davegutz/myStateOfCharge/README.md

# myStateOfCharge

[SOC_Particle - the main application](SOC_Particle/README.md)

- Interface python gui to interpret device Serial i/o is  [TestSOC.py](SOC_Particle/py/TestSOC.py) documented [here](SOC_Particle/doc/TestSOC.md).

[BT-AT - setup Bluetooth to a device](BT-AT/README.md)

[eeprom_test - Test Argon+ use of ERAM](eeprom_test/README.md)

[ScanI2C_Photon - Scan available I2C devices on system](ScanI2C_Photon/README.md)

[SOC_data_collection_test - Test serial connection possibilities](SOC_data_collection_test/README.md)
