davegutz/myStateOfCharge/SOC_Sense/README.md

# State of Charge Monitor sense only

Turned off everything.  Will get build warning about unused 'boot_wait' otherwise clean.   The pro3p2 has bad usb cable causing loss of usb sometimes...   Got T=0.0015 after efforts to turn off all unnecessary calculations.
