davegutz/myStateOfCharge/SOC_Particle/select_all decision table.odt

Certainly! Here's a decision tree representation of the logic in the `Fault::select_all_logic` function:

```Decision Table

Condition | Decision/Action | Outcome
reset_all_faults_ == true | Check sp.ib_select()
sp.ib_select() == 2 | ib_sel_stat_ = 2
sp.ib_select() == -1 | ib_sel_stat_ = -1
sp.ib_select() == 1 | ib_sel_stat_ = 1
Any of the above sp.ib_select() conditions | ib_sel_stat_last_ = ib_sel_stat_ | Print "reset ib flt"
ap.fake_faults == true | Check HDWE_IB_HI_LO
HDWE_IB_HI_LO defined | ib_sel_stat_ = 2
HDWE_IB_HI_LO not defined | ib_sel_stat_ = 1 | latched_fail_ = false
Sen->ShuntAmp->bare_detected() == true and Sen->ShuntNoAmp->bare_detected() == true | ib_sel_stat_ = 0 | latched_fail_ = true
sp.ib_select() > 0 and Sen->ShuntAmp->bare_detected() == false | ib_sel_stat_ = 1 | latched_fail_ = true
ib_sel_stat_last_ == -1 and Sen->ShuntNoAmp->bare_detected() == false and !(sp.mod_ib() && reset_all_faults_) | ib_sel_stat_ = -1 | latched_fail_ = true
sp.ib_select() < 0 and Sen->ShuntNoAmp->bare_detected() == false | ib_sel_stat_ = -1 | latched_fail_ = true
sp.ib_select() == 0 (auto) | Check conditions
Sen->ShuntAmp->bare_detected() == true and Sen->ShuntNoAmp->bare_detected() == false | ib_sel_stat_ = -1 | latched_fail_ = true
ib_diff_fa() == true | Check vb_sel_stat_ and wrap_fa()
vb_sel_stat_ == true and wrap_fa() == true | ib_sel_stat_ = -1 | latched_fail_ = true
vb_sel_stat_ == false and cc_diff_fa() == true | ib_sel_stat_ = -1 | latched_fail_ = true
`(sp.ib_select() < 0 && ib_sel_stat_last_ > -1) | | (sp.ib_select() >= 0 && ib_sel_stat_last_ < 1)`
Any other condition | latched_fail_ = false | Print "latchF"
ap.fake_faults == true (handling fake faults) | Check conditions
Sen->ShuntAmp->bare_detected() == true and Sen->ShuntNoAmp->bare_detected() == true | latched_fail_fake_ = true
ib_sel_stat_last_ == -1 and Sen->ShuntNoAmp->bare_detected() == false and sp.mod_ib() == false | latched_fail_fake_ = true
sp.ib_select() < 0 and Sen->ShuntNoAmp->bare_detected() == false | latched_fail_fake_ = true
Sen->ShuntAmp->bare_detected() == true and Sen->ShuntNoAmp->bare_detected() == false | latched_fail_fake_ = true
ib_diff_fa() == true | Check vb_sel_stat_ and wrap_fa()
vb_sel_stat_ == true and wrap_fa() == true | latched_fail_fake_ = true
vb_sel_stat_ == false and cc_diff_fa() == true | latched_fail_fake_ = true
Redundancy loss check | Call faultAssign(red_loss_calc(), RED_LOSS)
ap.fake_faults == true | ib_sel_stat_ = sp.ib_select()
reset_all_faults_ == true (reset vb faults) | vb_sel_stat_last_ = 1 | vb_sel_stat_ = 1
!ap.fake_faults == true | Check conditions
!vb_sel_stat_last_ == true and !sp.mod_vb() == true | vb_sel_stat_ = 0 | latched_fail_ = true
wrap_vb_fa() == true or vb_fa() == true | vb_sel_stat_ = 0 | latched_fail_ = true
ap.fake_faults == true (fake faults) | Check conditions
!vb_sel_stat_last_ == true and !sp.mod_vb() == true | latched_fail_fake_ = true
wrap_vb_fa() == true or vb_fa() == true | latched_fail_fake_ = true
reset_all_faults_ == true (reset tb faults) | tb_sel_stat_last_ = 1 | tb_sel_stat_ = 1
tb_fa() == true | tb_sel_stat_ = 0 | latched_fail_ = true
Any other condition | tb_sel_stat_ = 1
Status changes in ib_sel_stat_, vb_sel_stat_, or tb_sel_stat_ | Print detailed status message
ib_sel_stat_ != ib_sel_stat_last_ | Print "Small reset" | Call cp.cmd_reset()
Update last status | ib_sel_stat_last_ = ib_sel_stat_ | vb_sel_stat_last_ = vb_sel_stat_
| tb_sel_stat_last_ = tb_sel_stat_
Async Rf command execution | Check conditions
`(falw_ == 0 && fltw_ == 0) | | count > 1`
Any other condition | Increment count | Print Rf with count, Print "waiting to reset latched_fail"

### Detailed Graphical Decision Tree Description

#### Root Node

- Condition: reset_all_faults_ == true
  - True: Proceed to check sp.ib_select()
    - Condition: sp.ib_select() == 2
      - True: ib_sel_stat_ = 2 and ib_sel_stat_last_ = ib_sel_stat_
      - False: Proceed to next condition
    - Condition: sp.ib_select() == -1
      - True: ib_sel_stat_ = -1 and ib_sel_stat_last_ = ib_sel_stat_
      - False: Proceed to next condition
    - Condition: sp.ib_select() == 1
      - True: ib_sel_stat_ = 1 and ib_sel_stat_last_ = ib_sel_stat_
      - False: Proceed to next condition
    - Outcome: Print "reset ib flt"
  - False: Proceed to check ap.fake_faults == true

#### Node: ap.fake_faults == true

- True: Check HDWE_IB_HI_LO
  - Condition: HDWE_IB_HI_LO defined
    - True: ib_sel_stat_ = 2
    - False: ib_sel_stat_ = 1
  - Outcome: latched_fail_ = false
- False: Proceed to next condition

#### Node: Sen->ShuntAmp->bare_detected() && Sen->ShuntNoAmp->bare_detected()

- True:
  - Action: ib_sel_stat_ = 0
  - Outcome: latched_fail_ = true
- False: Proceed to next condition

#### Node: sp.ib_select() > 0 && !Sen->ShuntAmp->bare_detected()

- True:
  - Action: ib_sel_stat_ = 1
  - Outcome: latched_fail_ = true
- False: Proceed to next condition

#### Node: ib_sel_stat_last_ == -1 && !Sen->ShuntNoAmp->bare_detected() && !(sp.mod_ib() && reset_all_faults_)

- True:
  - Action: ib_sel_stat_ = -1
  - Outcome: latched_fail_ = true
- False: Proceed to next condition

#### Node: sp.ib_select() < 0 && !Sen->ShuntNoAmp->bare_detected()

- True:
  - Action: ib_sel_stat_ = -1
  - Outcome: latched_fail_ = true
- False: Proceed to next condition

#### Node: sp.ib_select() == 0

- True: Check nested conditions
  - Condition: Sen->ShuntAmp->bare_detected() && !Sen->ShuntNoAmp->bare_detected()
    - True:
      - Action: ib_sel_stat_ = -1
      - Outcome: latched_fail_ = true
    - False: Proceed to next condition
  - Condition: ib_diff_fa()
    - True: Check nested conditions
      - Condition: vb_sel_stat_ && wrap_fa()
        - True:
          - Action: ib_sel_stat_ = -1
          - Outcome: latched_fail_ = true
        - False: Proceed to next condition
      - Condition: cc_diff_fa()
        - True:
          - Action: ib_sel_stat_ = -1
          - Outcome: latched_fail_ = true
        - False: End of nested conditions
  - False: End of nested conditions
- False: Proceed to next condition

#### Node: (sp.ib_select() < 0 && ib_sel_stat_last_ > -1) || (sp.ib_select() >= 0 && ib_sel_stat_last_ < 1)

- True:
  - Outcome: latched_fail_ = true
- False:
  - Outcome: latched_fail_ = false

#### Node: Handling fake faults (if ap.fake_faults == true)

- True: Check conditions
  - Condition: Sen->ShuntAmp->bare_detected() && Sen->ShuntNoAmp->bare_detected()
    - True:
      - Outcome: latched_fail_fake_ = true
    - False: Proceed to next condition
  - Condition: ib_sel_stat_last_ == -1 && !Sen->ShuntNoAmp->bare_detected() && !sp.mod_ib()
    - True:
      - Outcome: latched_fail_fake_ = true
    - False: Proceed to next condition
  - Condition: sp.ib_select() < 0 && !Sen->ShuntNoAmp->bare_detected()
    - True:
      - Outcome: latched_fail_fake_ = true
    - False: Proceed to next condition
  - Condition: Sen->ShuntAmp->bare_detected() && !Sen->ShuntNoAmp->bare_detected()
    - True:
      - Outcome: latched_fail_fake_ = true
    - False: Proceed to next condition
  - Condition: ib_diff_fa()
    - True: Check nested conditions
      - Condition: vb_sel_stat_ && wrap_fa()
        - True:
          - Outcome: latched_fail_fake_ = true
        - False: Proceed to next condition
      - Condition: cc_diff_fa()
        - True:
          - Outcome: latched_fail_fake_ = true
        - False: End of nested conditions
  - False: End of nested conditions
- False: End of fake faults handling

#### Node: Redundancy loss check

- Action: Call faultAssign(red_loss_calc(), RED_LOSS)
- Condition: ap.fake_faults == true
  - True:
    - Action: ib_sel_stat_ = sp.ib_select()
  - False: Proceed to next condition

#### Node: Reset vb faults (if reset_all_faults_ == true)

- True:
  - Action: vb_sel_stat_last_ = 1, vb_sel_stat_ = 1
  - Outcome: Print "reset vb flts"
- False: Proceed to next condition

#### Node: Handling vb failure (if !ap.fake_faults)

- Condition: !vb_sel_stat_last_ && !sp.mod_vb()
  - True:
    - Action: vb_sel_stat_ = 0
    - Outcome: latched_fail_ = true
  - False: Proceed to next condition
- Condition: wrap_vb_fa() || vb_fa()
  - True:
    - Action: vb_sel_stat_ = 0
    - Outcome: latched_fail_ = true
  - False: End of nested conditions

#### Node: Handling vb failure (if ap.fake_faults)

- True: Check conditions
  - Condition: !vb_sel_stat_last_ && !sp.mod_vb()
    - True:
      - Outcome: latched_fail_fake_ = true
    - False: Proceed to next condition
  - Condition: wrap_vb_fa() || vb_fa()
    - True:
      - Outcome: latched_fail_fake_ = true
    - False: End of nested conditions
- False: End of fake faults handling

#### Node: Reset tb faults (if reset_all_faults_ == true)

- True:
  - Action: tb_sel_stat_last_ = 1, tb_sel_stat_ = 1
  - Outcome: Print "reset tb flts"
- False: Proceed to next condition

#### Node: Handling tb failure

- Condition: tb_fa()
  - True:
    - Action: tb_sel_stat_ = 0
    - Outcome: latched_fail_ = true
  - False:
    - Action: tb_sel_stat_ = 1
- Condition: Status changes in ib_sel_stat_, vb_sel_stat_, or tb_sel_stat_
  - True:
    - Outcome: Print detailed status message
  - False: Proceed to next condition
