davegutz/myStateOfCharge/SOC_Photon/dataReduction/figures/ReGaugeVocSoc.pyReGaugeVocSoc.py_2023-03-04T08-31-28.pdf_picture_1-2_of_2.pdf

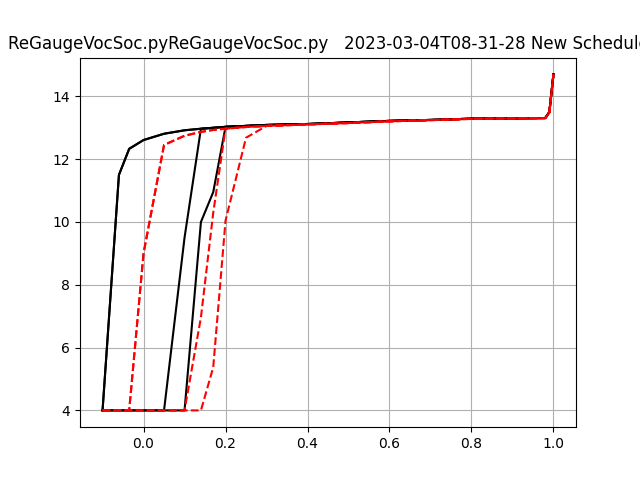
[picture p9: page 1]
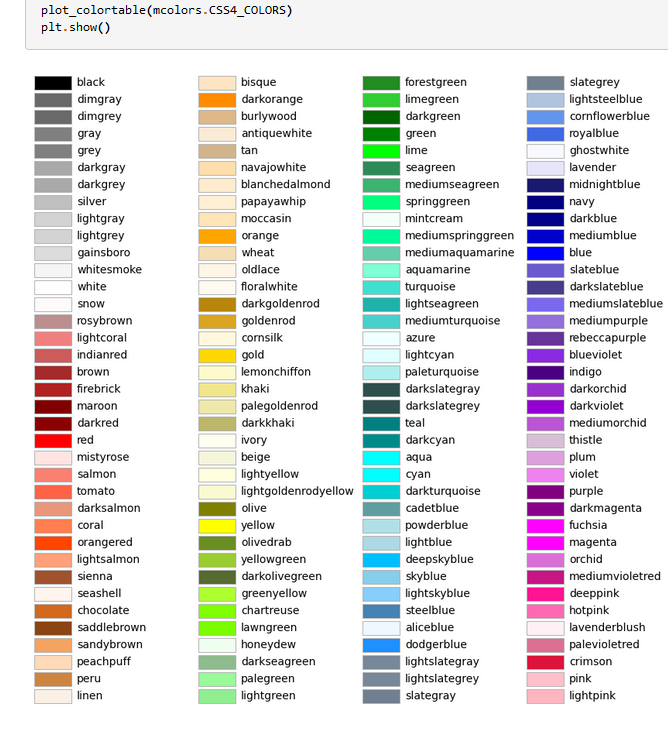
[picture p10: page 2]
