davegutz/myStateOfCharge/SOC_Photon/dataReduction/figures/ReGaugeVocSoc.pyReGaugeVocSoc.py_2023-03-02T19-05-37.pdf_picture_1-2_of_2.pdf

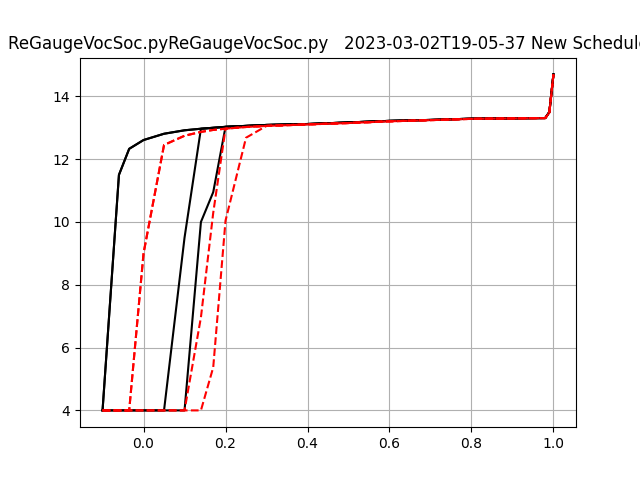
[picture p11: page 1]
