davegutz/myStateOfCharge/SOC_Photon/dataReduction/figures/ReGaugeVocSoc.pyReGaugeVocSoc.py_2023-03-02T18-55-13.pdf_picture_1-2_of_2.pdf

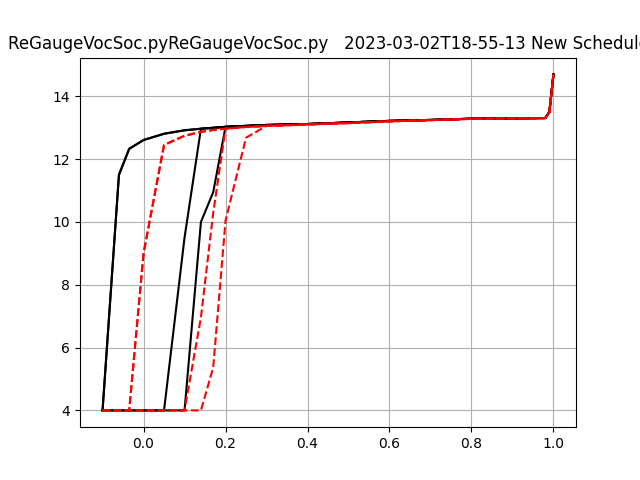
[picture p12: page 1]
