davegutz/myStateOfCharge/SOC_Photon/dataReduction/figures/ReGaugeVocSoc.pyReGaugeVocSoc.py_2023-03-02T16-22-21.pdf_picture_1-2_of_2.pdf

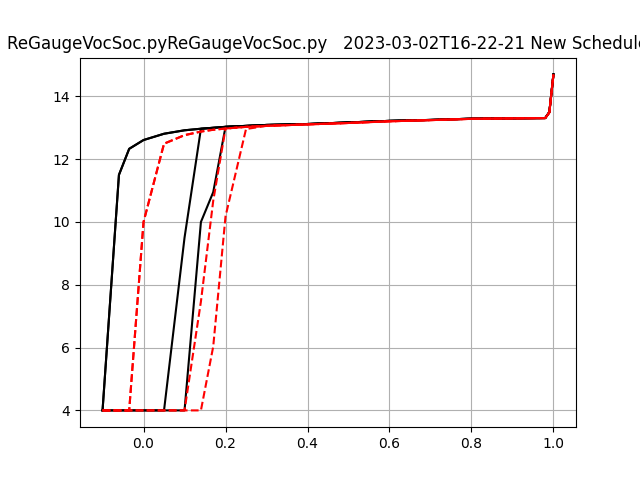
[picture p13: page 1]
