davegutz/myStateOfCharge/SOC_Photon/dataReduction/figures/hist_CompareFault-CompareFault.py_2023-02-12T07-20-07.pdf_picture_19-20_of_20.pdf

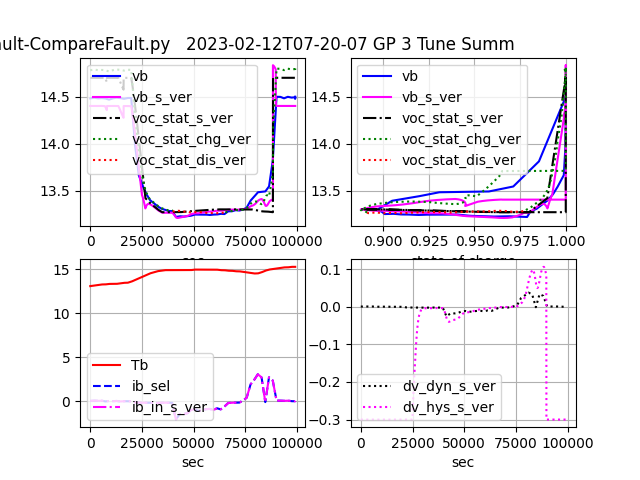
[picture p14: page 1]
