davegutz/myStateOfCharge/SOC_Photon/dataReduction/figures/hist_CompareFault-CompareFault.py_2023-02-12T05-17-59.pdf_picture_19-20_of_20.pdf

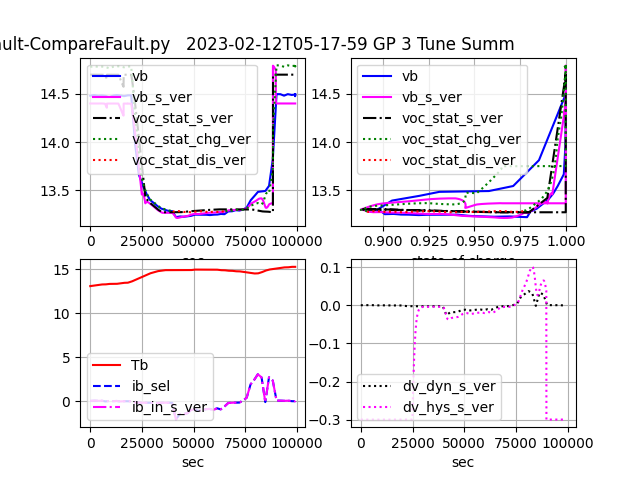
[picture p15: page 1]
