davegutz/myStateOfCharge/SOC_Photon/dataReduction/figures/hist_CompareFault-CompareFault.py_2023-02-11T13-36-58.pdf_picture_19-20_of_20.pdf

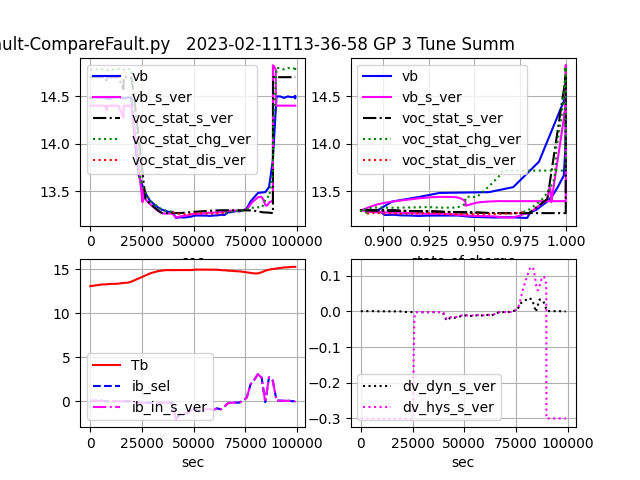
[picture p16: page 1]
