davegutz/myStateOfCharge/SOC_Photon/dataReduction/figures/hist_CompareFault-CompareFault.py_2023-02-09T05-07-31.pdf_picture_19-20_of_20.pdf

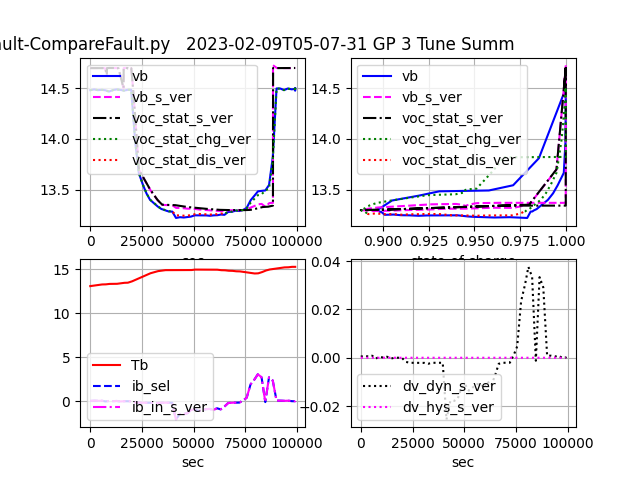
[picture p17: page 1]
