davegutz/myStateOfCharge/SOC_Photon/dataReduction/figures/hist_CompareFault-CompareFault.py_2023-02-08T13-31-16.pdf_picture_19-20_of_20.pdf

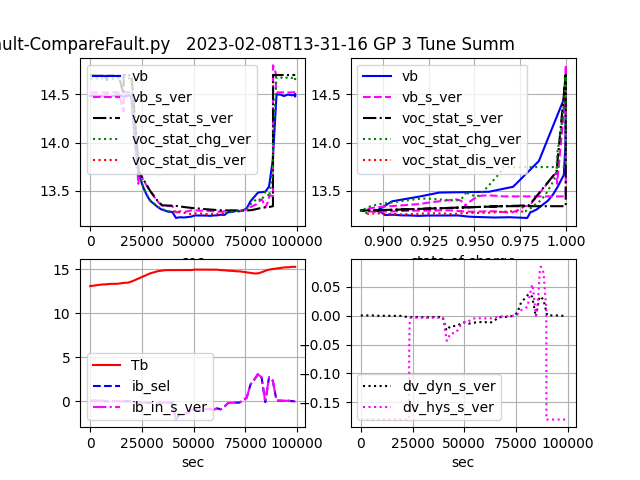
[picture p18: page 1]
