davegutz/myStateOfCharge/SOC_Photon/dataReduction/figures/hist_CompareFault-CompareFault.py_2023-02-07T05-28-49.pdf_picture_19-20_of_20.pdf

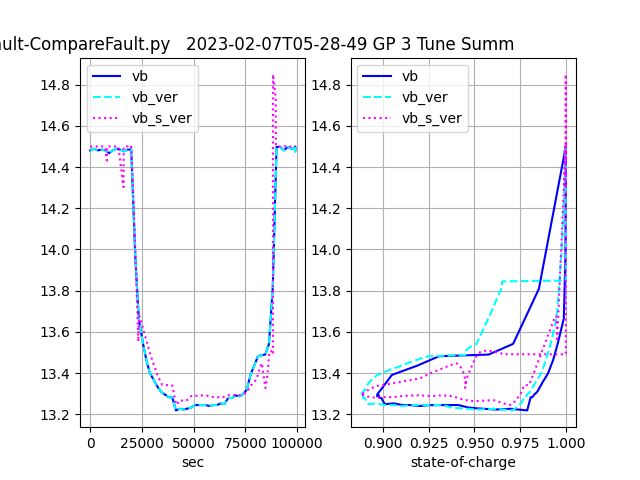
[picture p19: page 1]
