davegutz/myStateOfCharge/SOC_Photon/dataReduction/figures/rapidTweakRegression v20220917a_mon-CompareRun.py_2022-09-27T05-37-11.pdf_picture_19-19_of_19.pdf

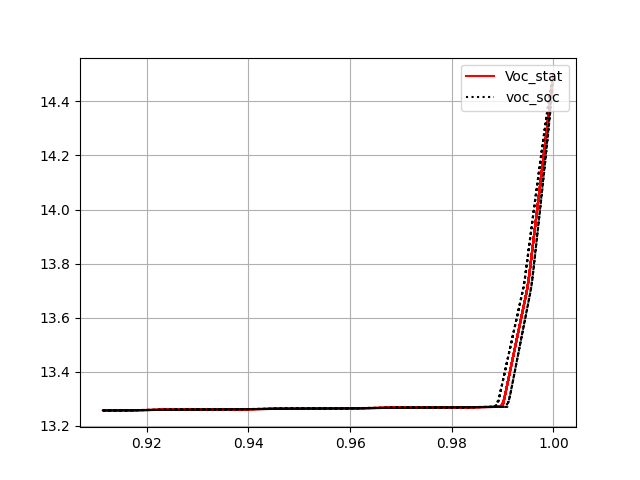
[picture p20: page 1]
