davegutz/myStateOfCharge/SOC_Photon/dataReduction/figures/EKF_Track Dr2000 v20220917_mon-CompareRun.py_2022-09-18T11-55-39.pdf_picture_19-19_of_19.pdf

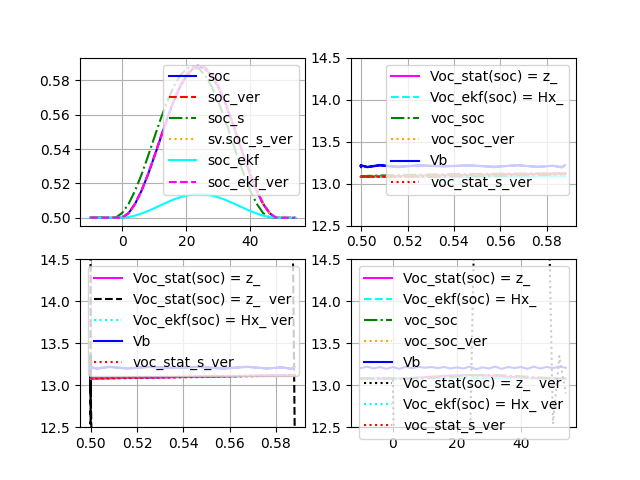
[picture p21: page 1]
