davegutz/myStateOfCharge/SOC_Particle/pyStateOfCharge/figures/faultParade_pro0p_ch_CompareHistSim_2023-12-15T14-03-37.pdf_picture_10-11_of_11.pdf

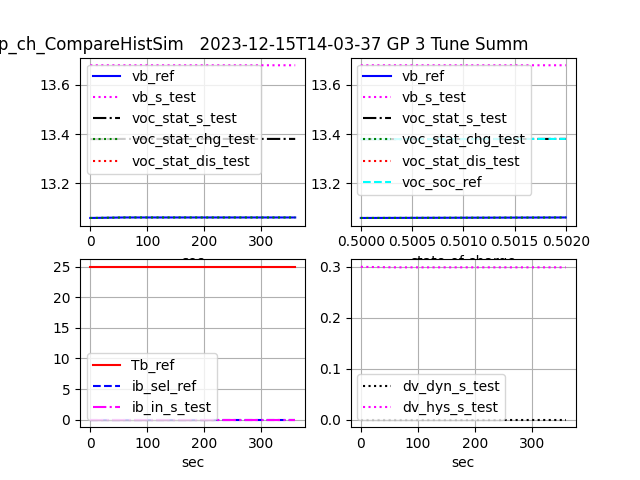
[picture p22: page 1]
