davegutz/myStateOfCharge/SOC_Particle/Battery State/BattleBorn Usable Capacity vs Temperature.png

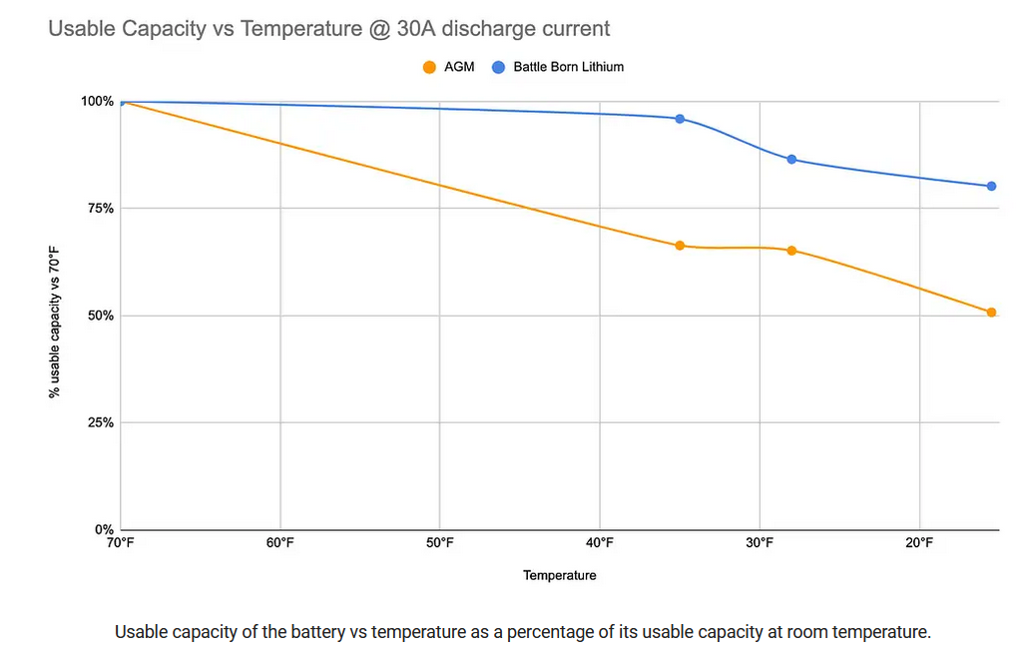
SOC_Particle/Battery State/BattleBorn Usable Capacity vs Temperature.png
