davegutz/myStateOfCharge/SOC_Particle/Battery State/Charge Bookkeeping 20211208.jpg

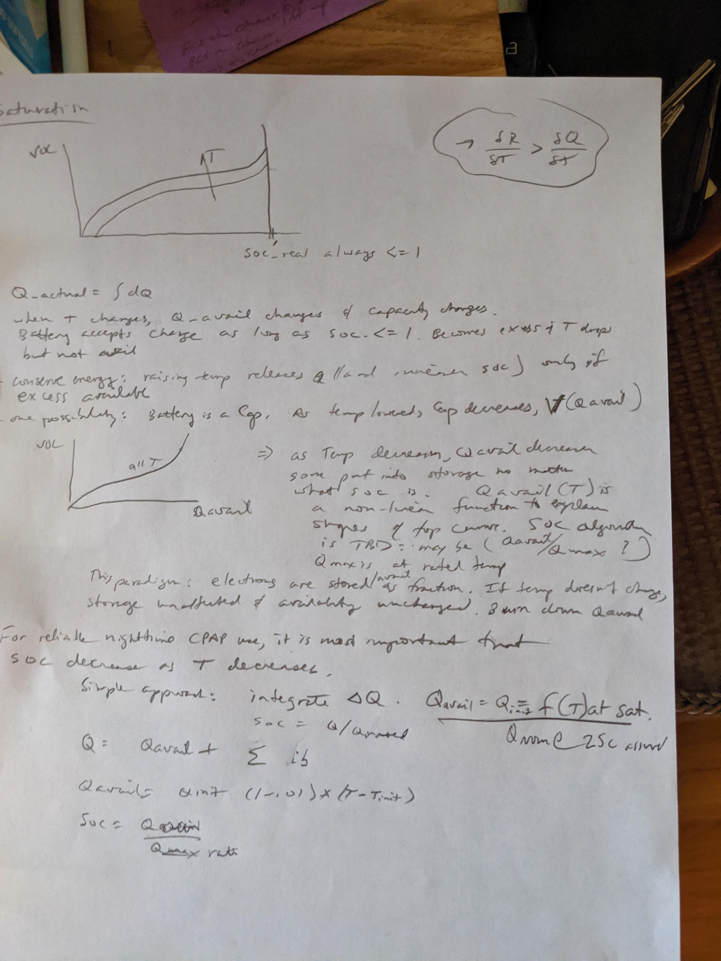
SOC_Particle/Battery State/Charge Bookkeeping 20211208.jpg
