davegutz/myStateOfCharge/SOC_Particle/Battery State/EKF/sandbox/figures/figure_d.png

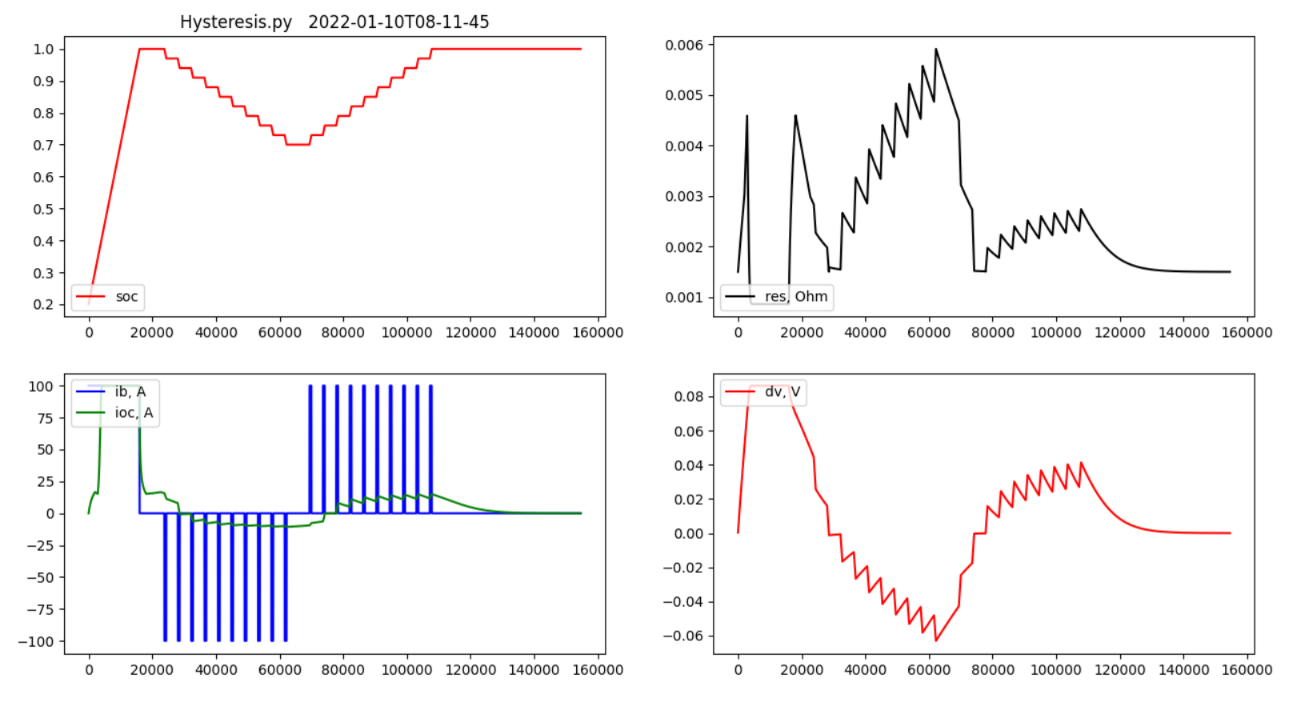
SOC_Particle/Battery State/EKF/sandbox/figures/figure_d.png
