davegutz/myStateOfCharge/SOC_Particle/Battery State/EKF/sandbox/figures/Hysteresis.py_1.png

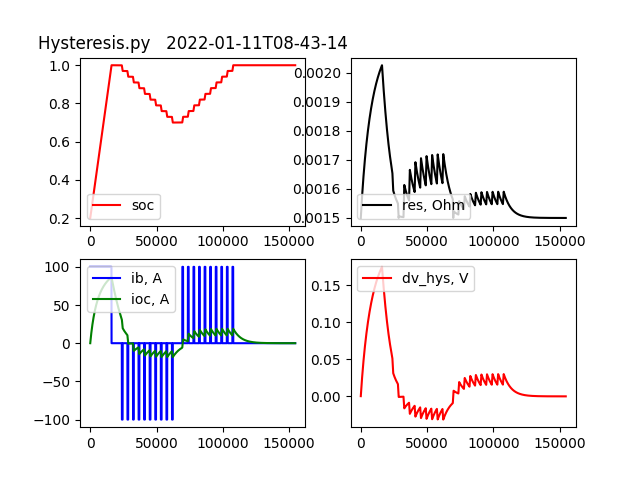
SOC_Particle/Battery State/EKF/sandbox/figures/Hysteresis.py_1.png
