davegutz/myStateOfCharge/SOC_Particle/Battery State/EKF/sandbox/figures/Hysteresis.py_2.png

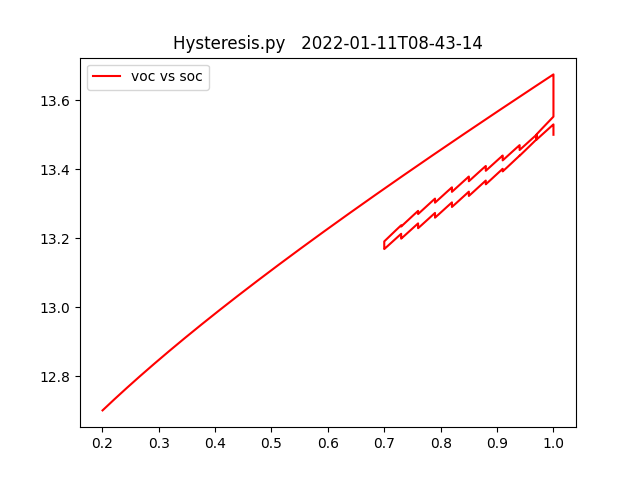
SOC_Particle/Battery State/EKF/sandbox/figures/Hysteresis.py_2.png
