davegutz/myStateOfCharge/SOC_Particle/Battery State/EKF/sandbox/figures/table_d.png

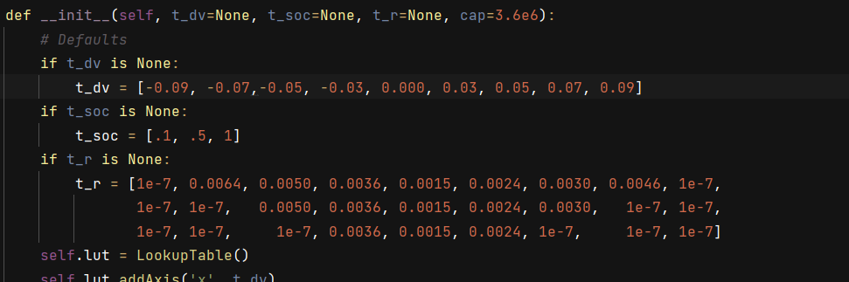
SOC_Particle/Battery State/EKF/sandbox/figures/table_d.png
