davegutz/myStateOfCharge/SOC_Particle/Battery State/Evolution-of-differential-voltage-curves-of-the-fresh-and-aged-LiFePO4-graphite-batteries.png

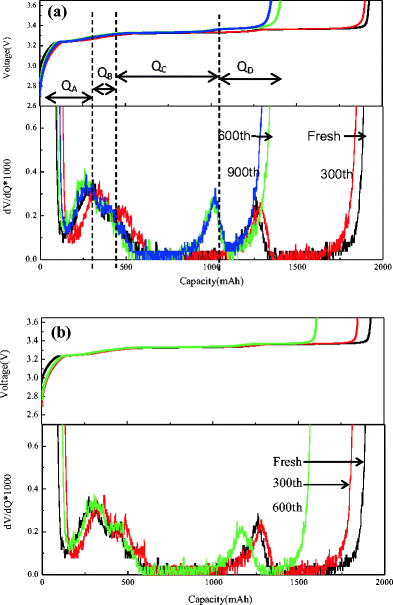
SOC_Particle/Battery State/Evolution-of-differential-voltage-curves-of-the-fresh-and-aged-LiFePO4-graphite-batteries.png
