davegutz/myStateOfCharge/SOC_Particle/Battery State/SMBus Battery Screenshot.png

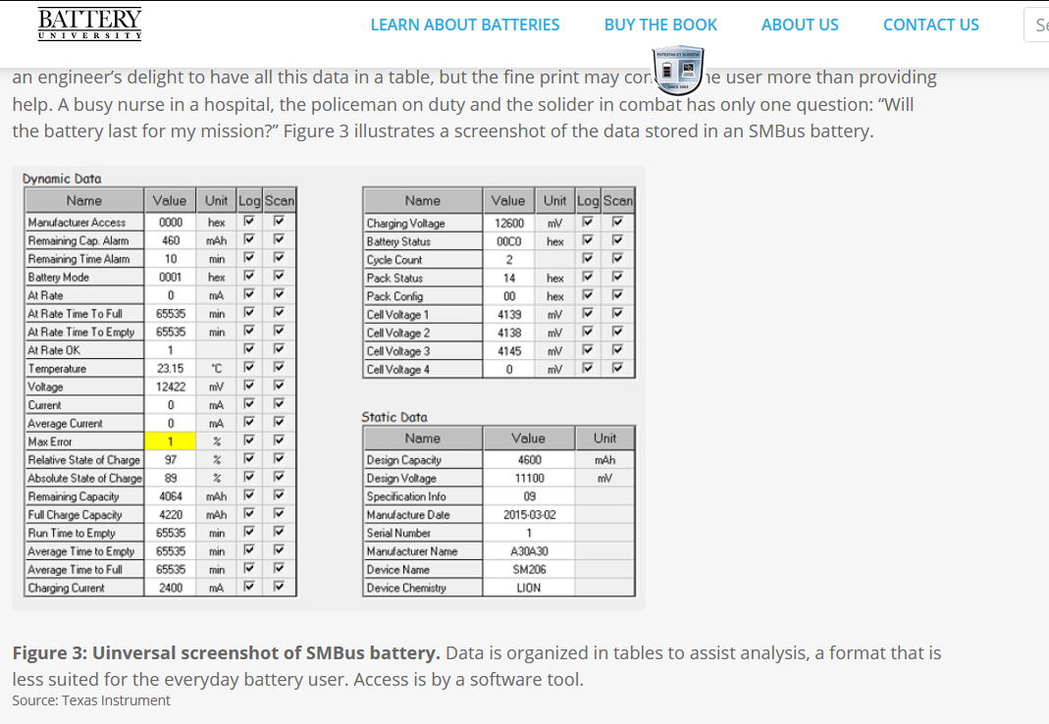
SOC_Particle/Battery State/SMBus Battery Screenshot.png
