davegutz/myStateOfCharge/SOC_Particle/Battery State/The-coulombic-efficiency-of-the-LiFePO4-graphite-batteries-cycled-at-a-25C-and-b-55C.png

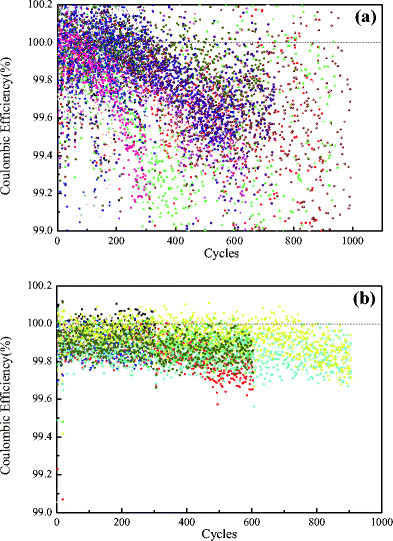
SOC_Particle/Battery State/The-coulombic-efficiency-of-the-LiFePO4-graphite-batteries-cycled-at-a-25C-and-b-55C.png
