davegutz/myStateOfCharge/SOC_Particle/datasheets/pSpice/3_filters_compared.png

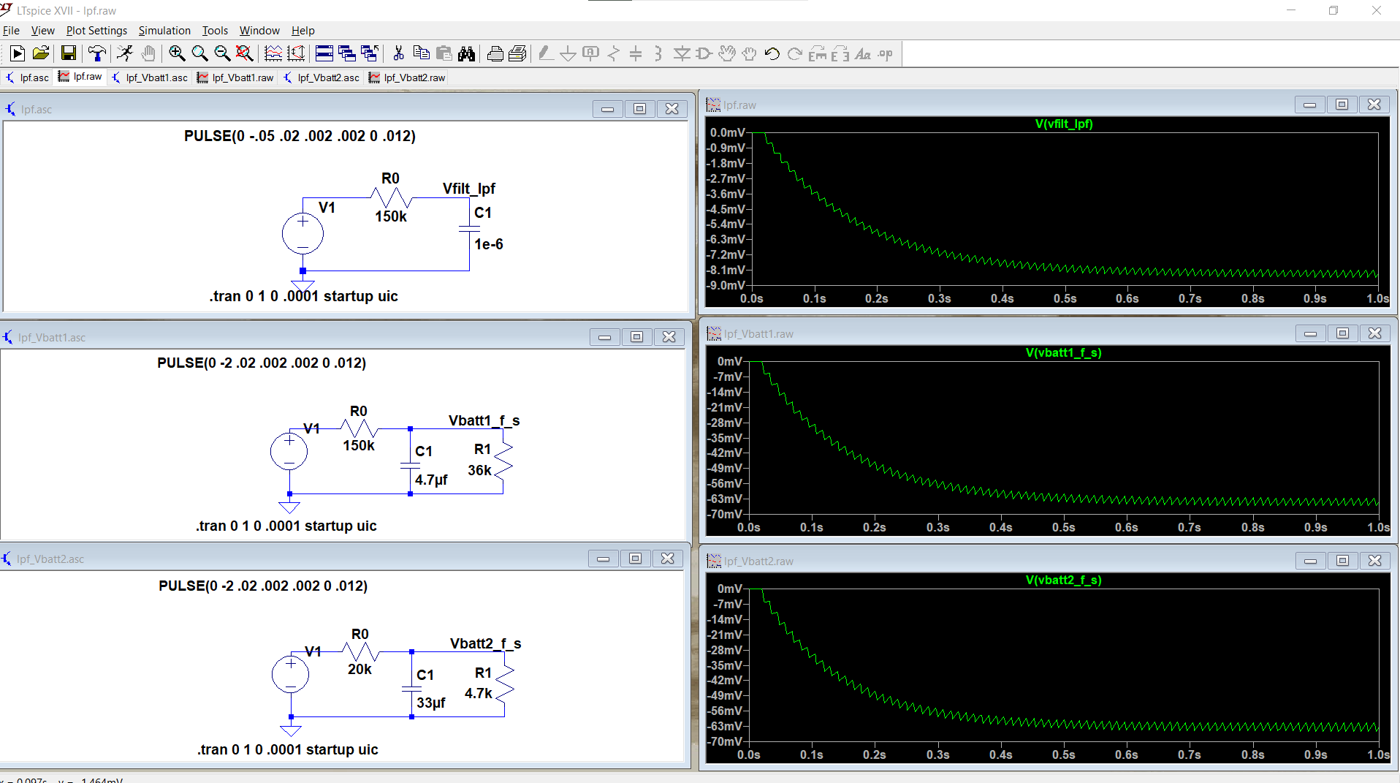
SOC_Particle/datasheets/pSpice/3_filters_compared.png
