davegutz/myStateOfCharge/SOC_Particle/datasheets/Schematics/ArgonBeta.jpg

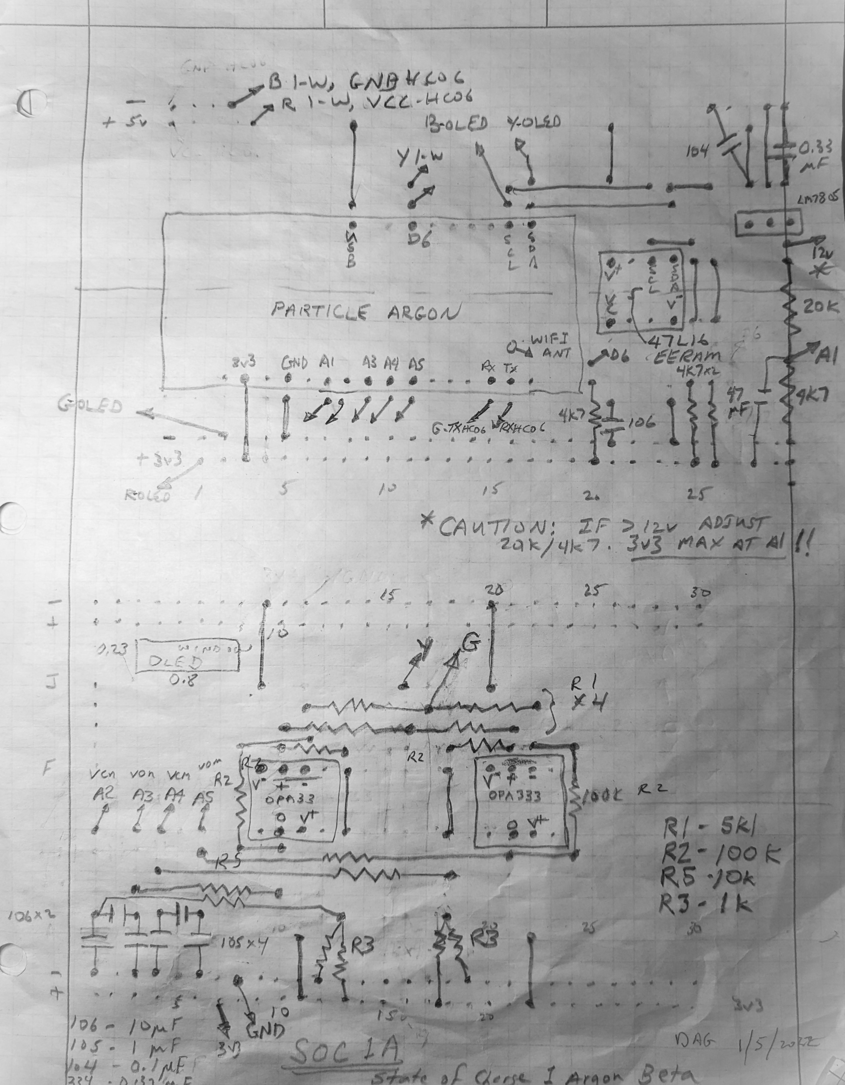
SOC_Particle/datasheets/Schematics/ArgonBeta.jpg
