davegutz/myStateOfCharge/SOC_Particle/datasheets/Schematics/ASD1013_OPA333 Layout.png

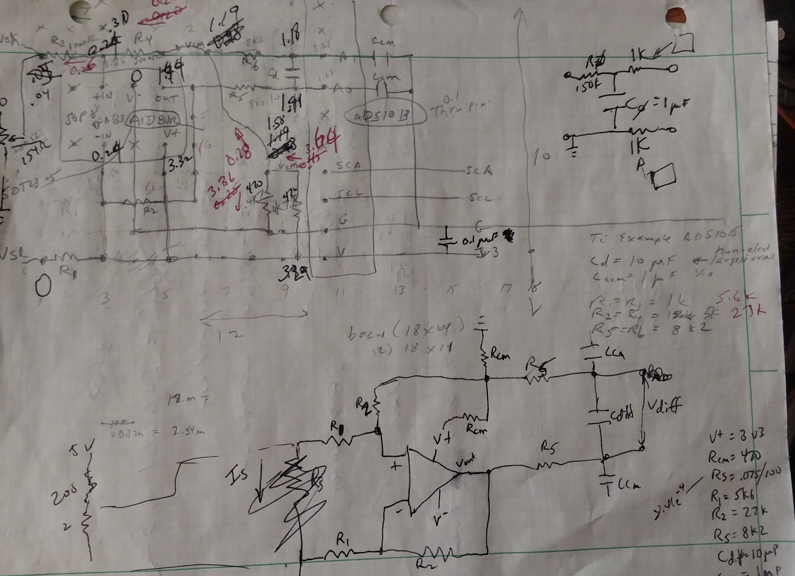
SOC_Particle/datasheets/Schematics/ASD1013_OPA333 Layout.png
