davegutz/myStateOfCharge/SOC_Particle/datasheets/Schematics/ASD1013_OPA333 Prototype Layout.png

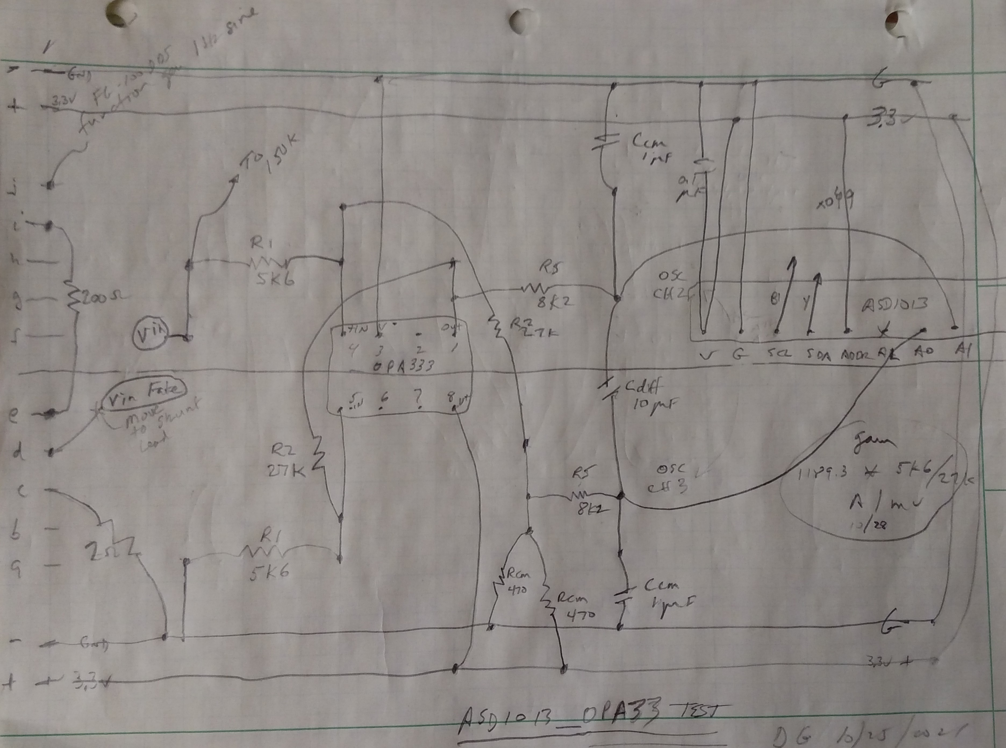
SOC_Particle/datasheets/Schematics/ASD1013_OPA333 Prototype Layout.png
