davegutz/myStateOfCharge/SOC_Particle/datasheets/Schematics/ASD_OPA Design 20211212.jpg

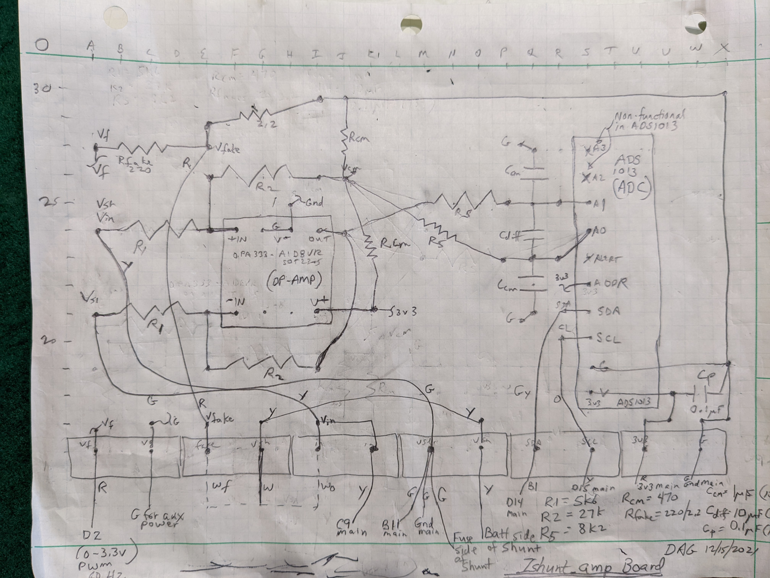
SOC_Particle/datasheets/Schematics/ASD_OPA Design 20211212.jpg
