davegutz/myStateOfCharge/SOC_Particle/datasheets/Schematics/Cutting Strip Board Circuit.jpg

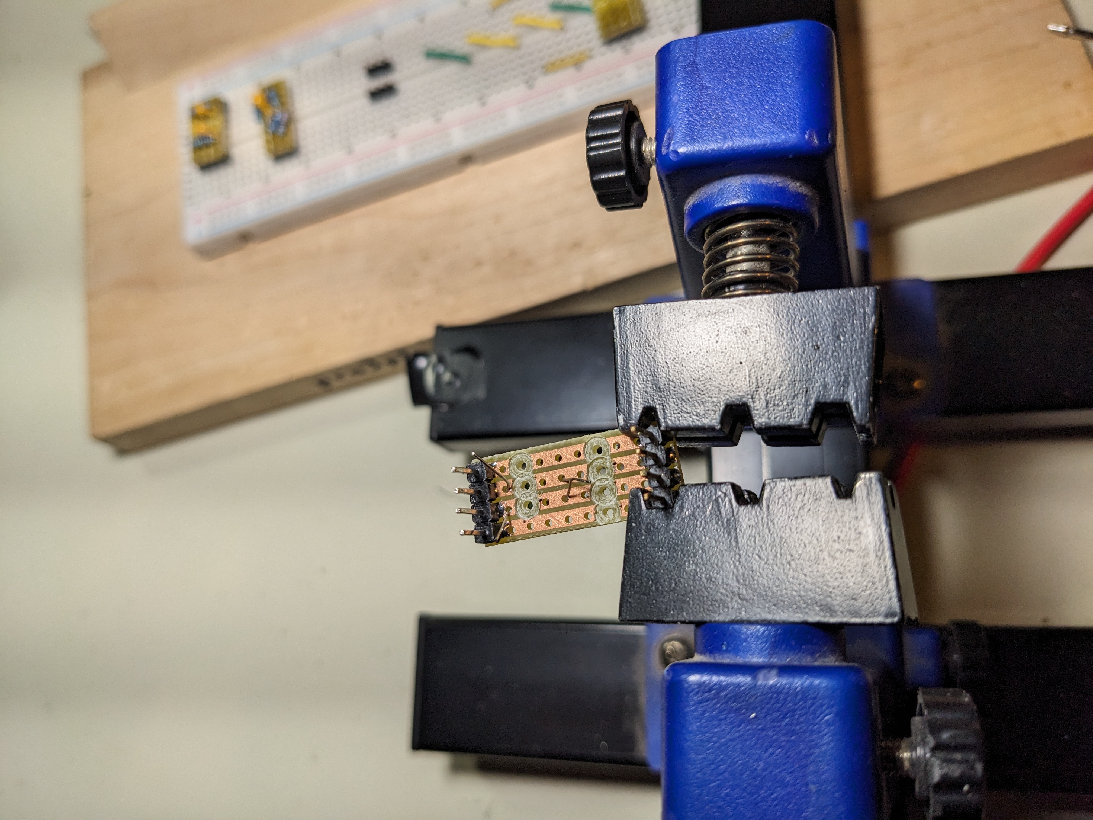
SOC_Particle/datasheets/Schematics/Cutting Strip Board Circuit.jpg
