davegutz/myStateOfCharge/SOC_Particle/datasheets/Schematics/Header Complete.jpg

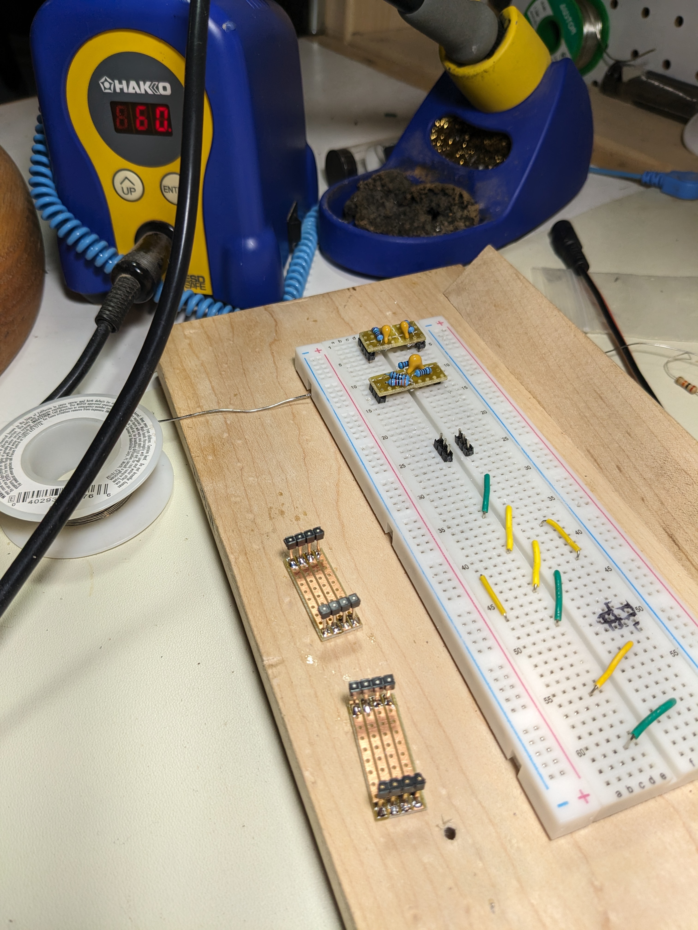
SOC_Particle/datasheets/Schematics/Header Complete.jpg
