davegutz/myStateOfCharge/SOC_Particle/datasheets/Schematics/Header Prep.jpg

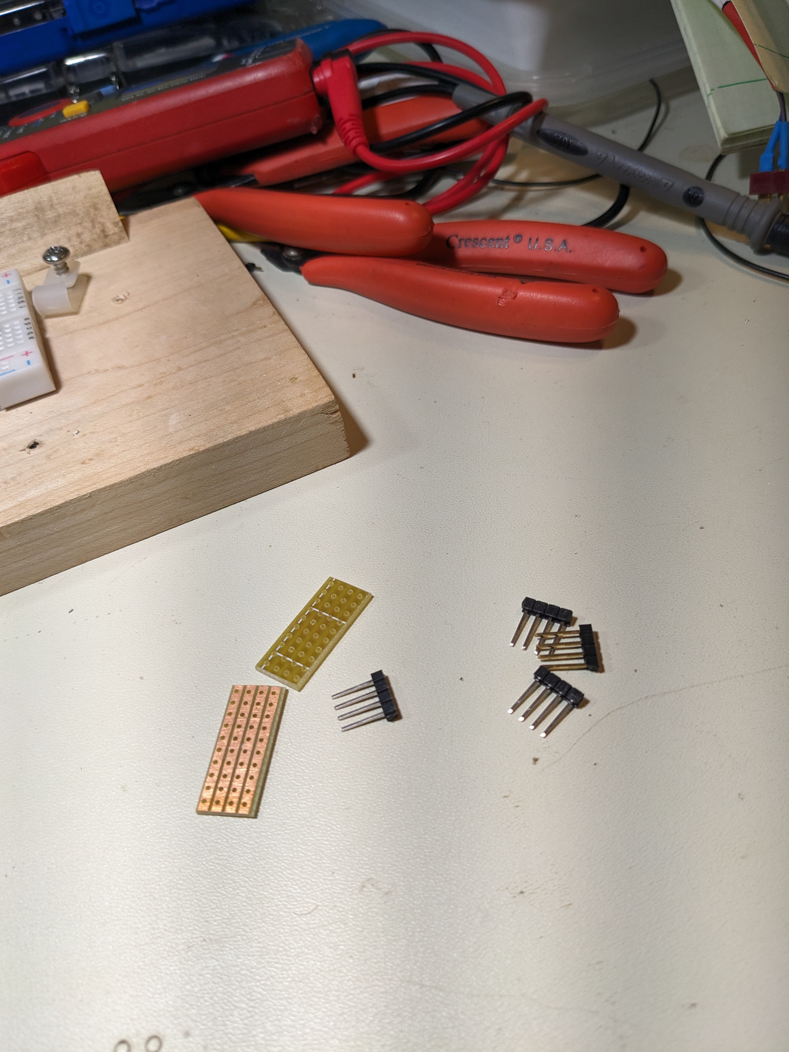
SOC_Particle/datasheets/Schematics/Header Prep.jpg
