davegutz/myStateOfCharge/SOC_Particle/datasheets/Schematics/Header Tack.jpg

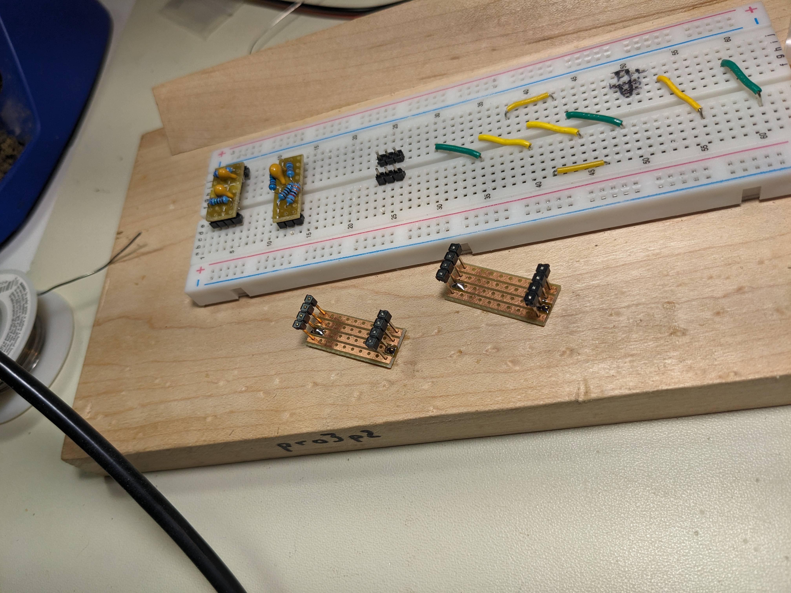
SOC_Particle/datasheets/Schematics/Header Tack.jpg
