davegutz/myStateOfCharge/SOC_Particle/datasheets/Schematics/House Awning.jpg

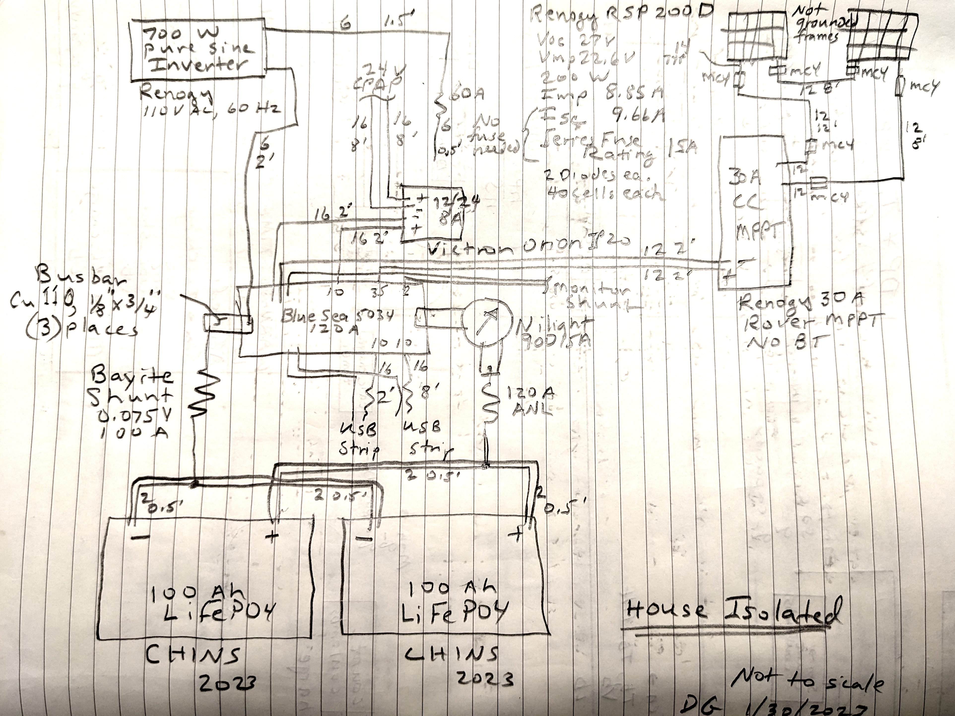
SOC_Particle/datasheets/Schematics/House Awning.jpg
