davegutz/myStateOfCharge/SOC_Particle/datasheets/Schematics/Ib Module.jpg

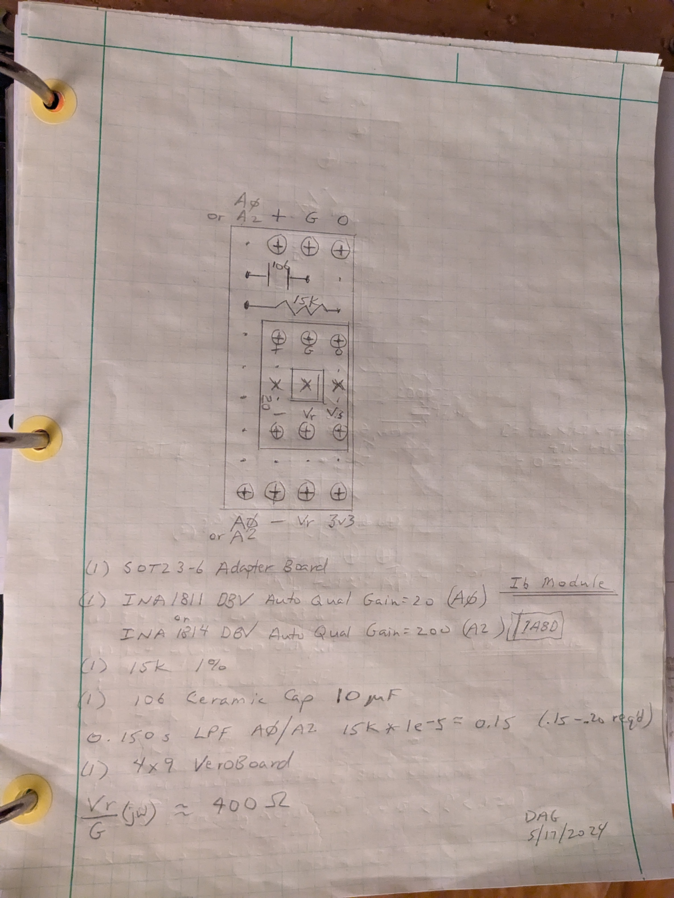
SOC_Particle/datasheets/Schematics/Ib Module.jpg
