davegutz/myStateOfCharge/SOC_Particle/datasheets/Schematics/Ib_Filter_Module.jpg

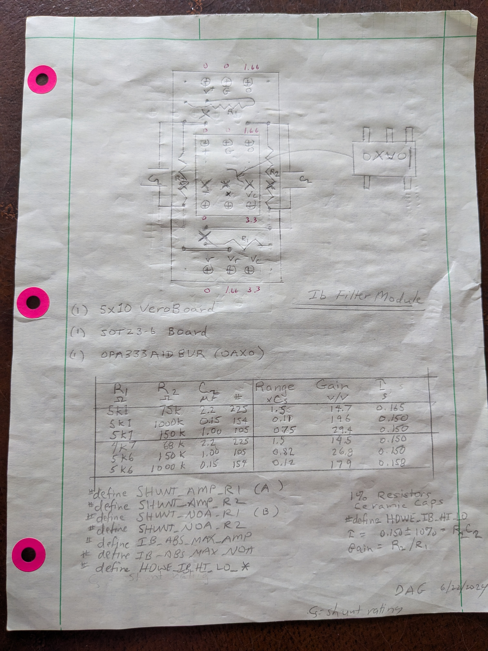
SOC_Particle/datasheets/Schematics/Ib_Filter_Module.jpg
