davegutz/myStateOfCharge/SOC_Particle/datasheets/Schematics/Isolated Garage Solar Power Station.drawio.png

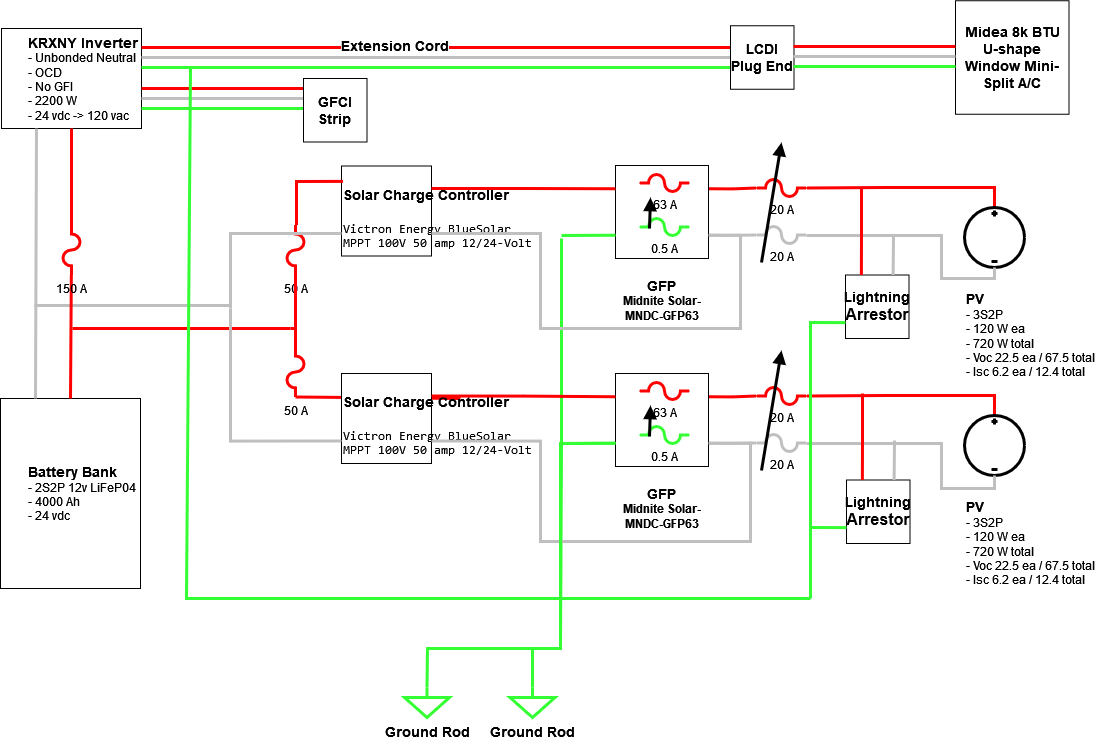
SOC_Particle/datasheets/Schematics/Isolated Garage Solar Power Station.drawio.png
