davegutz/myStateOfCharge/SOC_Particle/datasheets/Schematics/lifepo service life per powertechsystems_eu.png

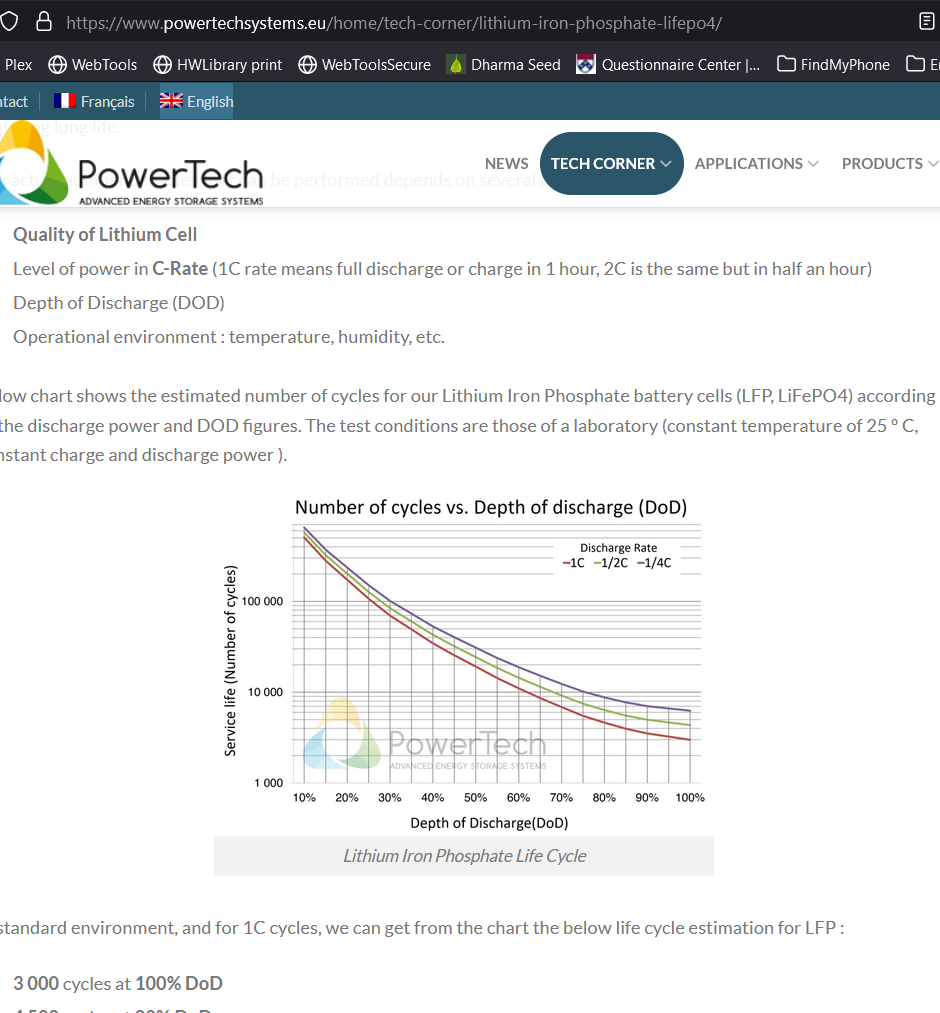
SOC_Particle/datasheets/Schematics/lifepo service life per powertechsystems_eu.png
