davegutz/myStateOfCharge/SOC_Particle/datasheets/Schematics/opa333_asd1013_5betaWith100k.png

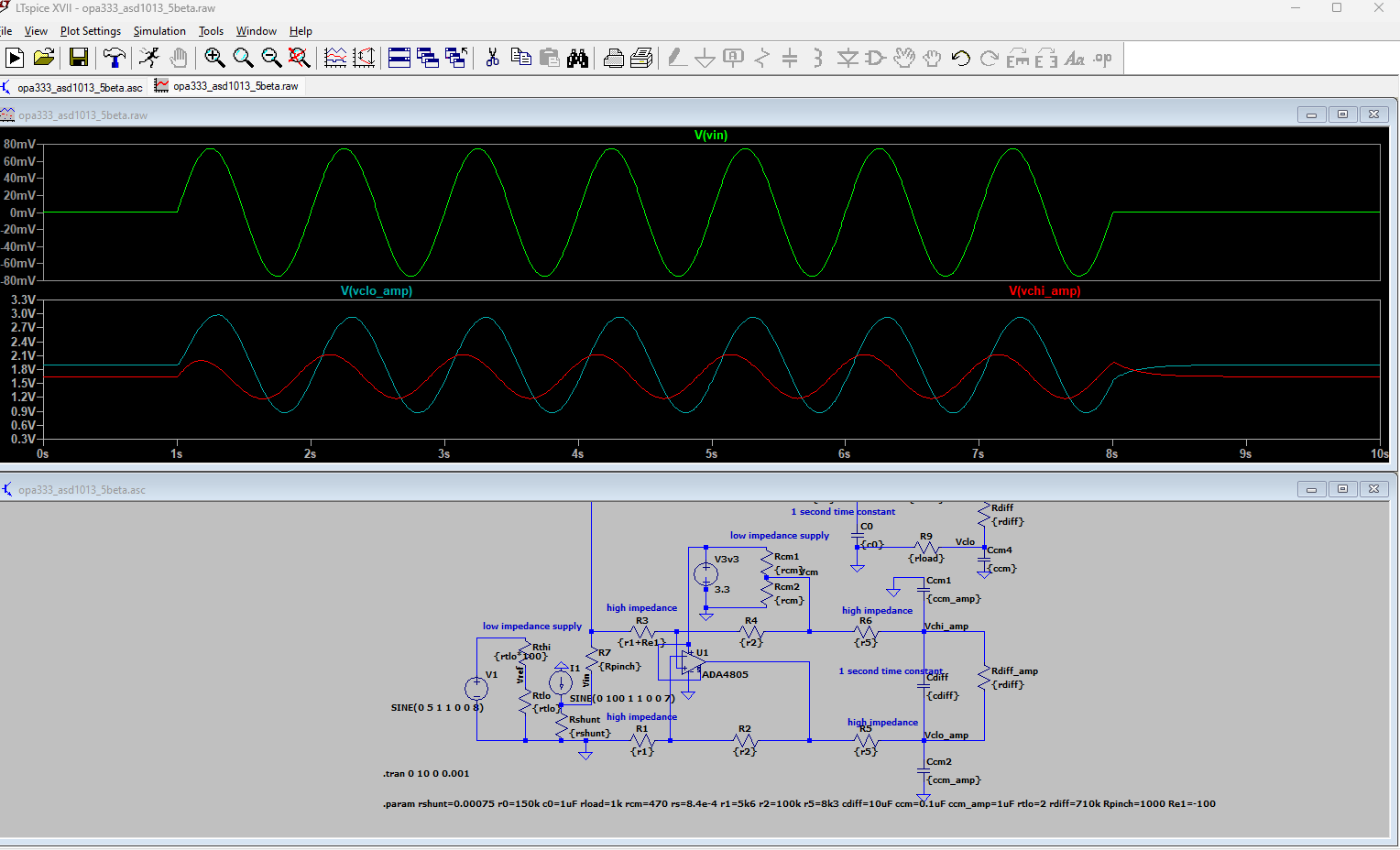
SOC_Particle/datasheets/Schematics/opa333_asd1013_5betaWith100k.png
