davegutz/myStateOfCharge/SOC_Particle/datasheets/Schematics/soc2p2_soc3p2.jpg

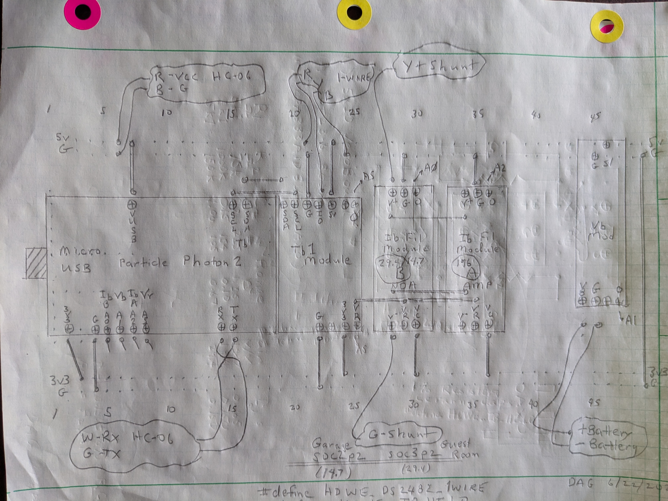
SOC_Particle/datasheets/Schematics/soc2p2_soc3p2.jpg
