davegutz/myStateOfCharge/SOC_Particle/datasheets/Schematics/soc4p2.jpg

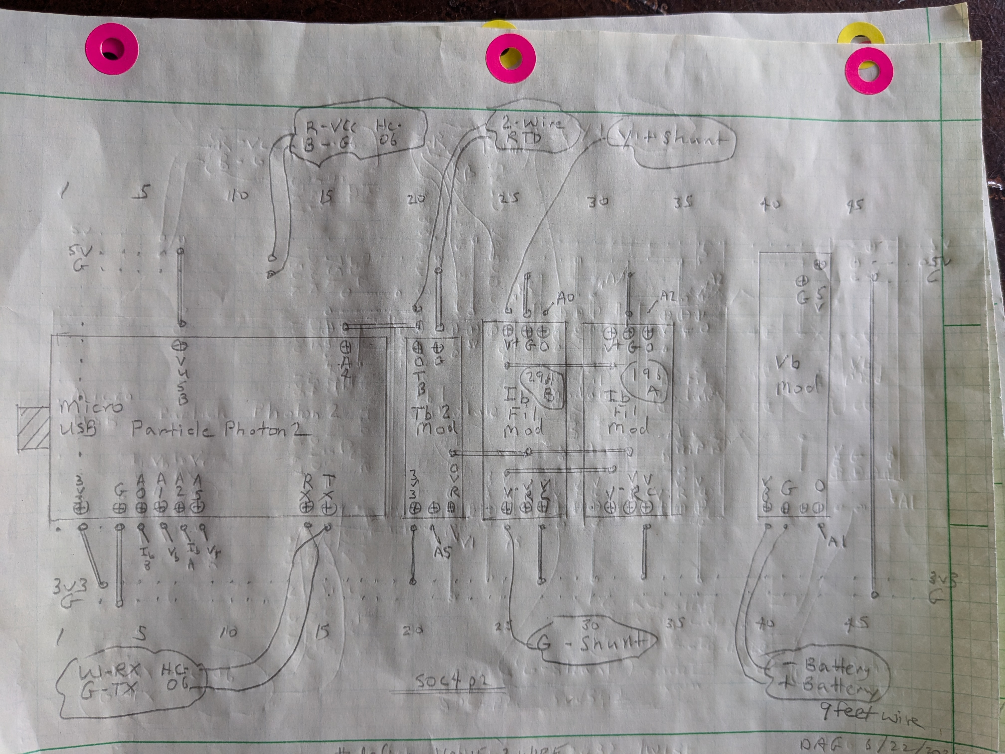
SOC_Particle/datasheets/Schematics/soc4p2.jpg
