davegutz/myStateOfCharge/SOC_Particle/datasheets/Schematics/SoC Layout.png

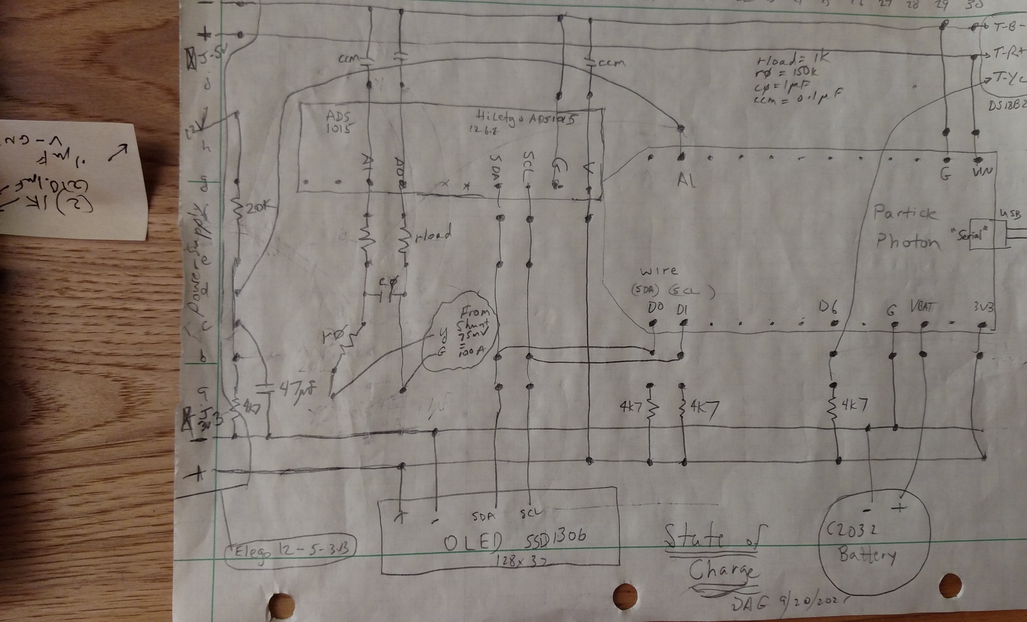
SOC_Particle/datasheets/Schematics/SoC Layout.png
