davegutz/myStateOfCharge/SOC_Particle/datasheets/Schematics/SoC Prototype Layout.png

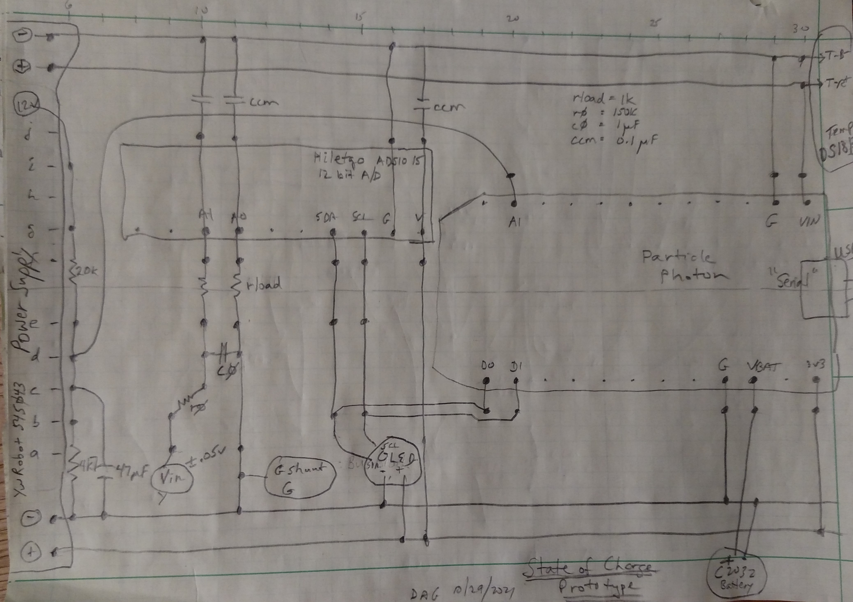
SOC_Particle/datasheets/Schematics/SoC Prototype Layout.png
