davegutz/myStateOfCharge/SOC_Particle/datasheets/Schematics/State of Charge Design.jpg

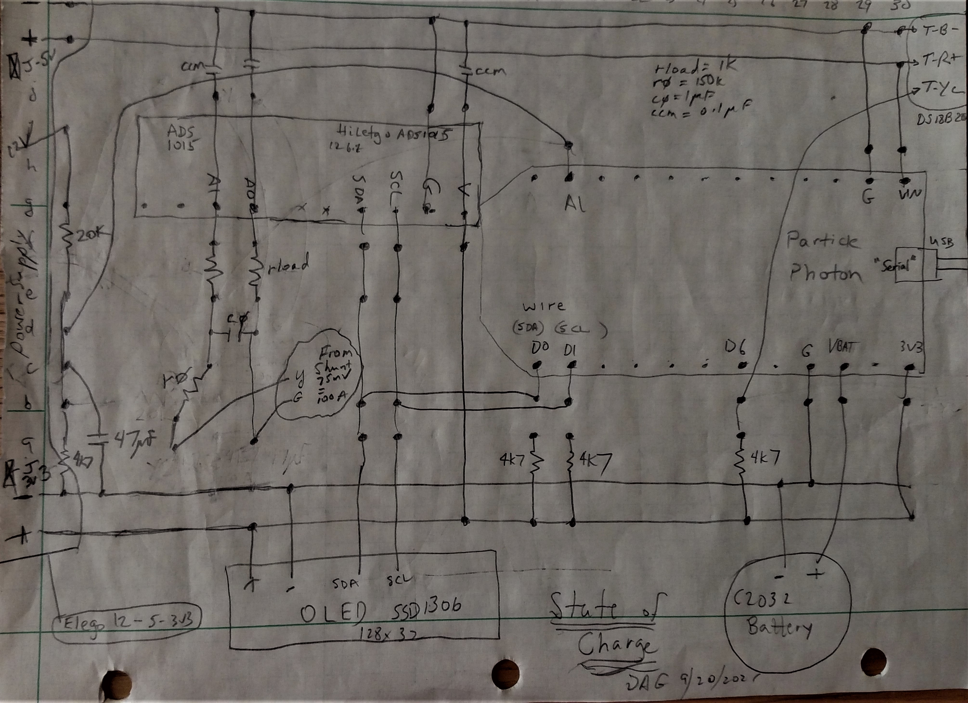
SOC_Particle/datasheets/Schematics/State of Charge Design.jpg
