davegutz/myStateOfCharge/SOC_Particle/datasheets/Schematics/State Of Charge Prototype.jpg

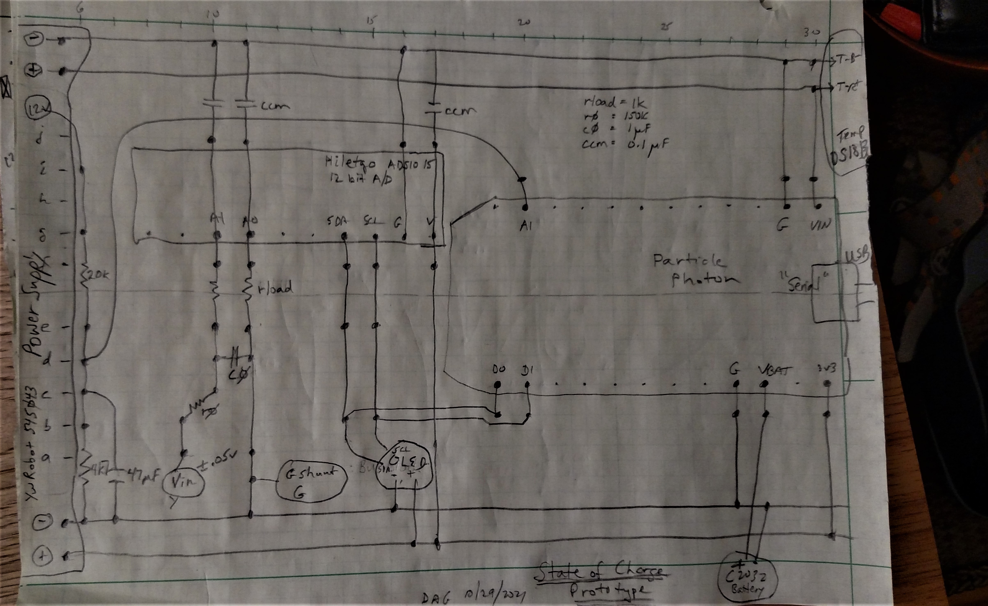
SOC_Particle/datasheets/Schematics/State Of Charge Prototype.jpg
