davegutz/myStateOfCharge/SOC_Particle/datasheets/Schematics/Tb1 Module.jpg

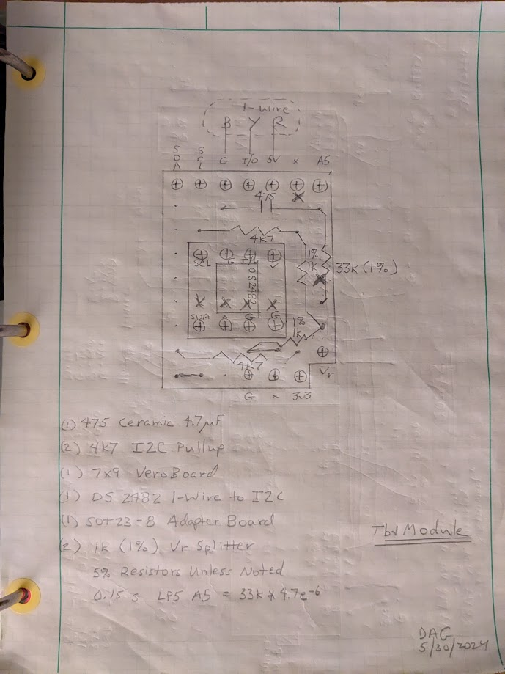
SOC_Particle/datasheets/Schematics/Tb1 Module.jpg
