davegutz/myStateOfCharge/SOC_Particle/datasheets/Schematics/Tb2 Module.jpg

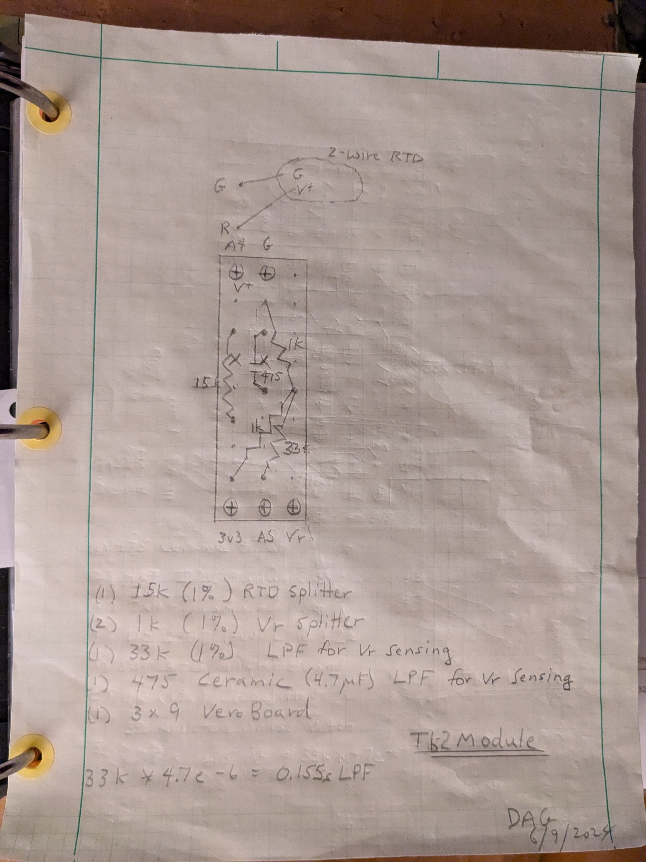
SOC_Particle/datasheets/Schematics/Tb2 Module.jpg
