davegutz/myStateOfCharge/SOC_Particle/datasheets/Schematics/Truck Camper.jpg

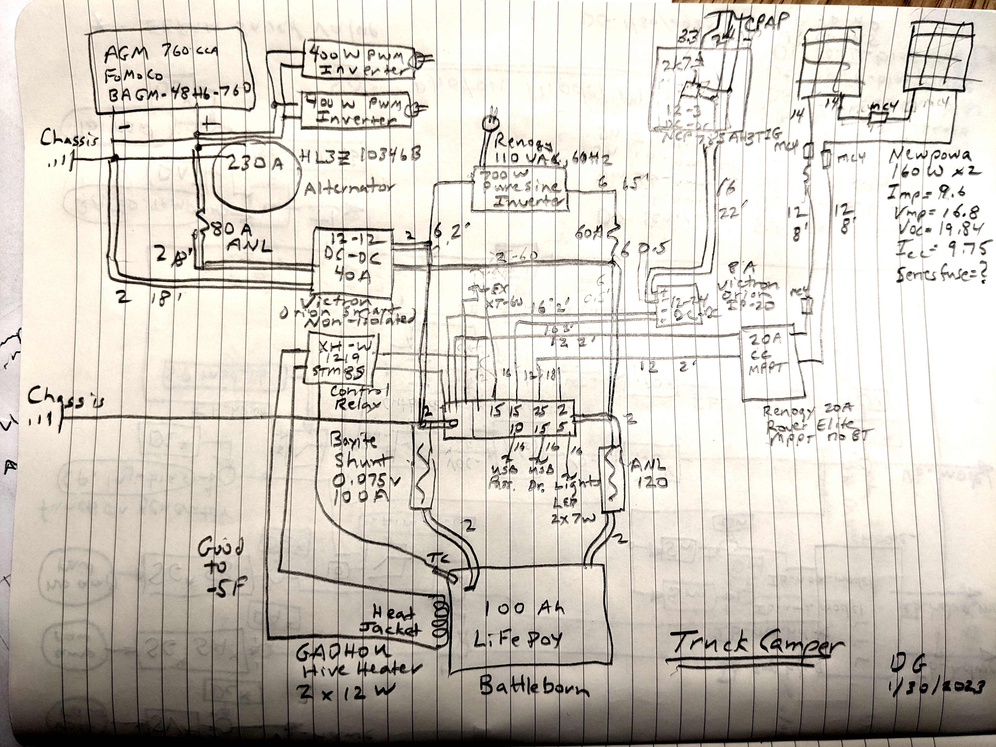
SOC_Particle/datasheets/Schematics/Truck Camper.jpg
