davegutz/myStateOfCharge/SOC_Particle/datasheets/Schematics/Vb Module.jpg

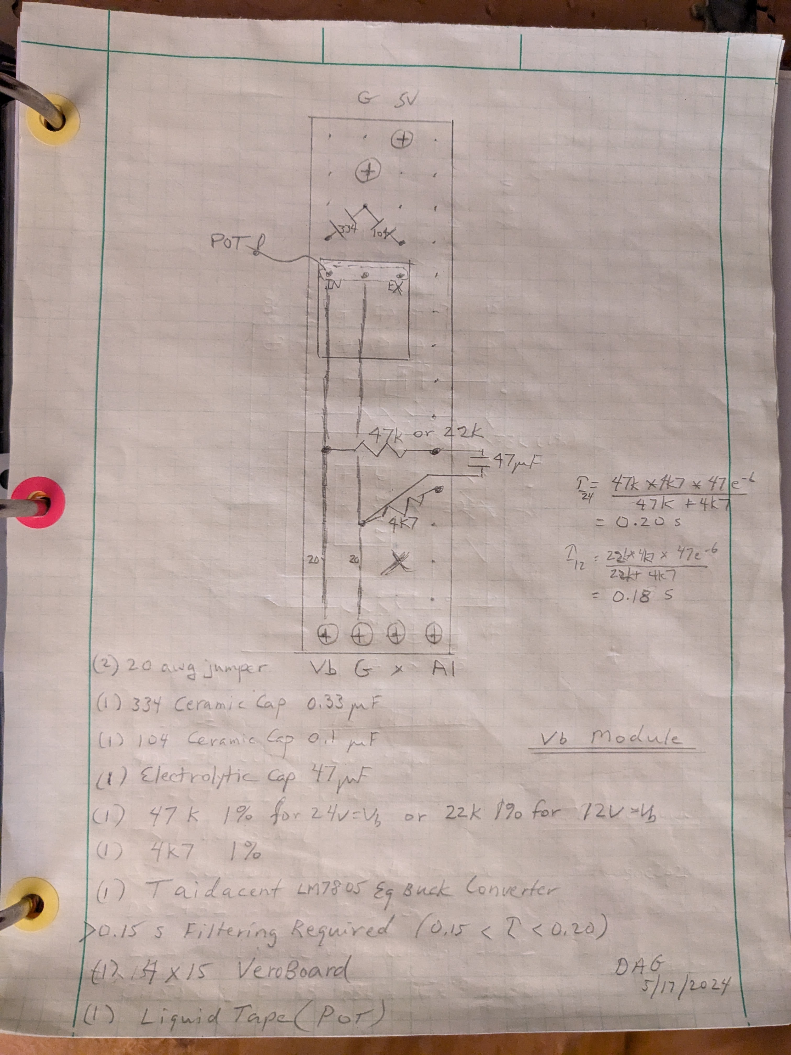
SOC_Particle/datasheets/Schematics/Vb Module.jpg
