davegutz/myStateOfCharge/SOC_Particle/datasheets/Schematics/VeroBoardDeburr.jpg

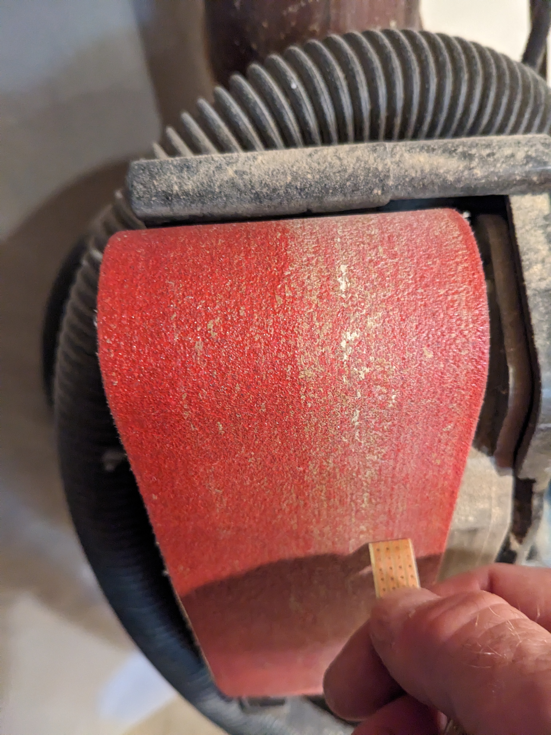
SOC_Particle/datasheets/Schematics/VeroBoardDeburr.jpg
