davegutz/myStateOfCharge/SOC_Particle/pyStateOfCharge/myFilters.py_1.png

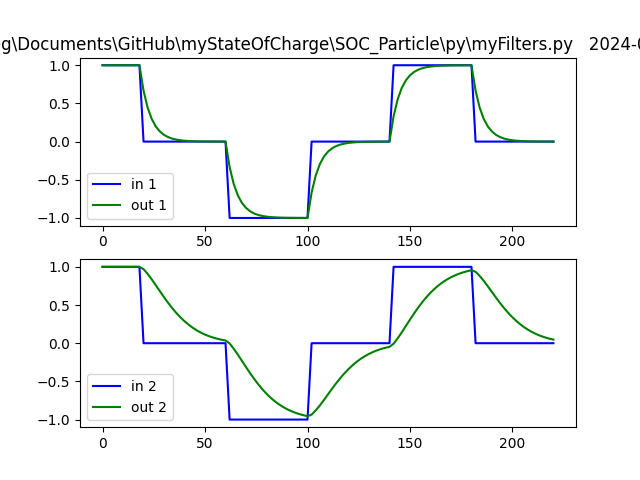
SOC_Particle/pyStateOfCharge/myFilters.py_1.png
