davegutz/myStateOfCharge/SOC_Particle/target/output_circuit.png

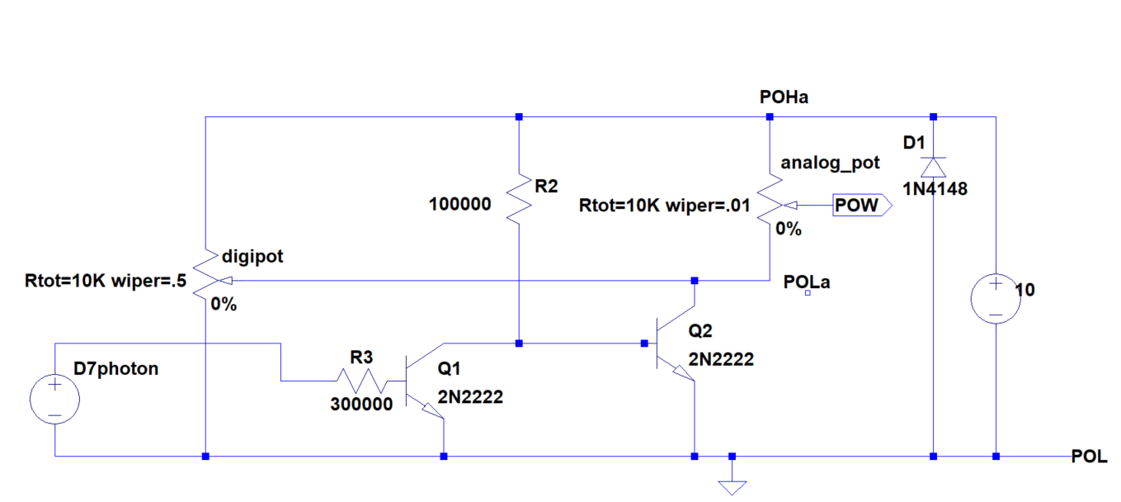
SOC_Particle/target/output_circuit.png
