davegutz/myStateOfCharge/SOC_Particle/doc/InstallationMacOS.md

# macOS Software Installation for Particle Devices State of Charge Monitoring

Particle Workbench extension to Visual Studio Code is used to develop and configure the real-time code for the different Particle devices and installations.   Header files set the differences.   Particle 'configure for device' chooses the device options that then interact with the headers.

A serial port tool is required to interact.  puTTY is the most effective and integrates best with the TestSOC.py tool on both Windows and Linux.

## Installing GitHub

Install the desktop app from [here](https://desktop.github.com/)

GitHub is tightly integrated with browser sessions.   Sign in to your GitHub first using the browser and browse to  [here](https://github.com/davegutz/myStateOfCharge)
 
- Code - Open with GitHub Desktop - Clone

## Installing Particle Workbench Integrated Development Environment (IDE)

- Download from [here](https://docs.particle.io/quickstart/workbench/#windows)
- Follow the instructions at that link
- It is not necessary to install the Azure IoT toolkit
- When done with installation open Visual Studio
  - IDE - File - New Window 
  - New Window - Particle Workbench 
    - Welcome to Particle Workbench
       - Create new Project - browse to parent folder.   e.g. if want BT-AT under GitHub/myStateOfCharge select 'myStateOfCharge' - Choose parent folder
                    -  Project name - e.g. 'BT-AT' - ok..........project will 'initialize and redraw the window with browser on side
      -  Configure for device  e.g. '3.1.0'  - 'Photon' - device name optional e.g. 'pro'

## Installing puTTY

- Download from [here](https://www.putty.org/)
- On macOS, it's easiest to configure graphically.   Open puTTY and '_Load_' the '_Default Settings_'.
- Configure non-default settings per [here](../dataReduction/putty/sessions/puTTY_Windows_setup_def.odt) and save as 'def'
- Configure the 'test' settings by changing the _logging_ location per [here](../dataReduction/putty/sessions/puTTY_Windows_setup_test.odt)
- Plug in a Particle device to a USB and set the proper _Serial line_ in both the _test_ and _def_ settings and resave them.
- You can find the device by plugging it in and out.
```
ls -lha /dev/tty* > plugged.txt
ls -lha /dev/tty* > np.txt
diff np.txt plugged.txt
```
- The Particle devices will not always be producing output.   Try entering _v1;_ into the puTTY terminal window manually to get it to produce a data stream.
- Enter _v0;_ to turn it back off.

To run putty on macOS you need to install [macPorts](https://guide.macports.org/chunked/installing.macports.html).
Then run
```commandline
sudo port install putty
```
For pasting into the open putty xterm window you need to install [XQuartz](https://www.xquartz.org/) and make some configuration changes.
Start putty then highlight the xterm (Xquartz) window and change
```commandline
XQuartz - X11 Preference
        - Emulate 3-button mouse
        - Emulate syncing
        - Update Primary
```
Then use 'Option key - click' to paste from mouse buffer.

## Installing GUI

The 'install.py' script run from py creates an .app in myStateOfCharge/SOC_Particle/py/dist.  The python scripts have embedded print statments to stdout that won't be visible unless you start the .app with a terminal.  TODO:  use python logger instead so the Console.app utility will show stdout.

```
    # Run from terminal command line:
    # /Users/daveg/Documents/GitHub/myStateOfCharge/SOC_Particle/py/dist/GUI_TestSOC.app/Contents/MacOS/GUI_TestSOC
```
