davegutz/myStateOfCharge/SOC_Sense/dataReduction/putty/puTTY_Windows_setup_def.odt

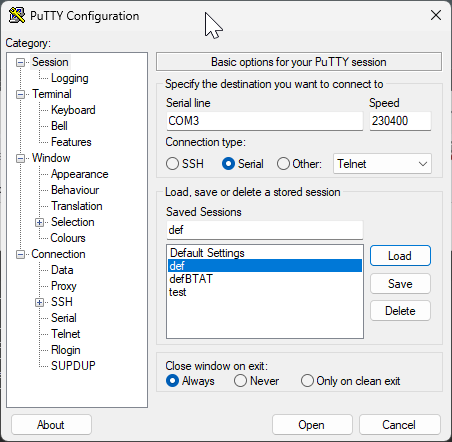
[picture p61: figure]
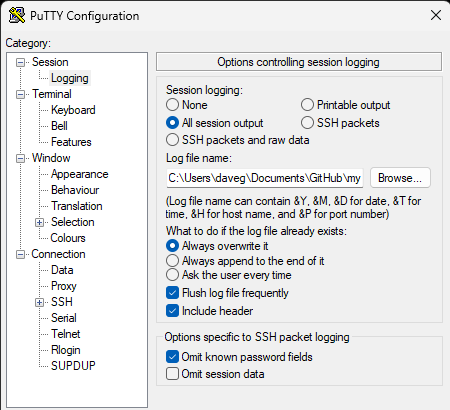
[picture p62: figure]

Windows puTTY setup to interact with SOC_Particle serial port

/dev/ttyACM0 for linux

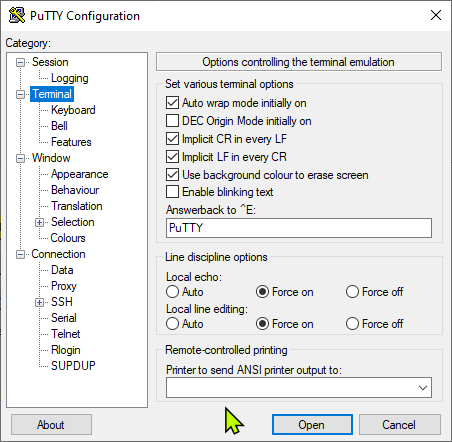
[picture p63: figure]
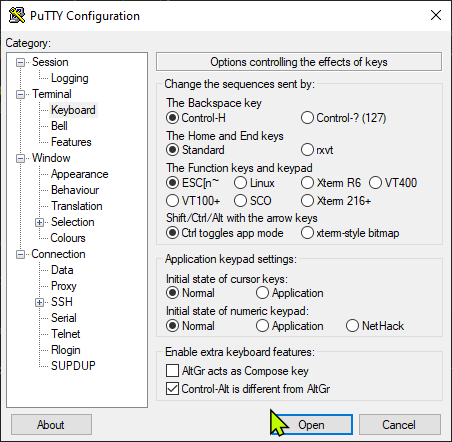
[picture p64: figure]
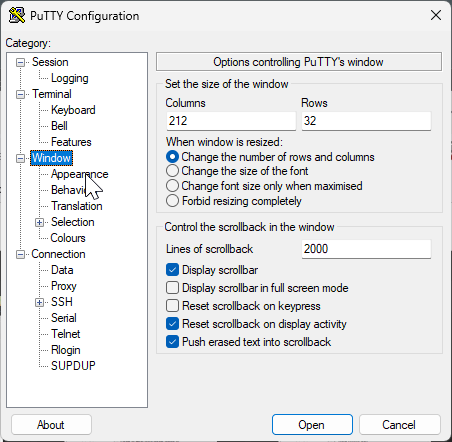
[picture p65: figure]
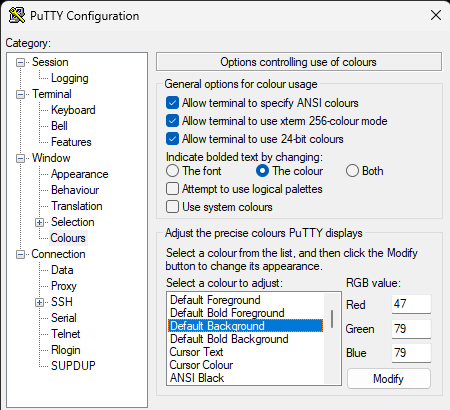
[picture p66: figure]
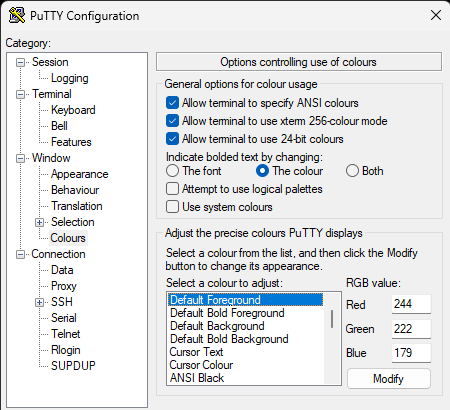
[picture p67: figure]
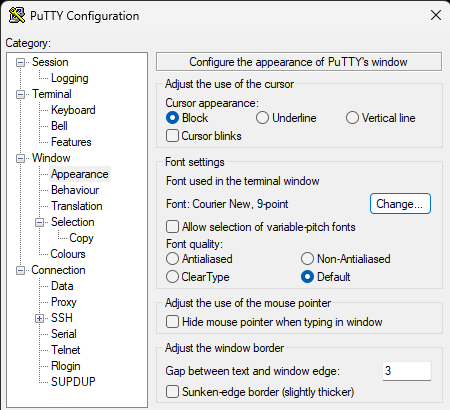
[picture p68: figure]
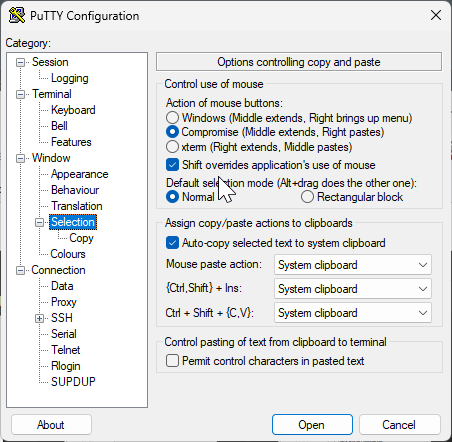
[picture p69: figure]
