davegutz/myStateOfCharge/SOC_Particle/dataReduction/putty/puTTY_Windows_setup_def.odt

Windows puTTY setup to interact with SOC_Particle serial port

/dev/ttyACM0 for linux

/home/daveg/.local/putty_def.csv (Linux)

Or

/Users/daveg/.local/putty_def.csv (Darwin)

or

C:\Users\daveg\AppData\Local\Temp\putty_def.csv (Windows)

/dev/tty.usbmodem14202 for Darwin

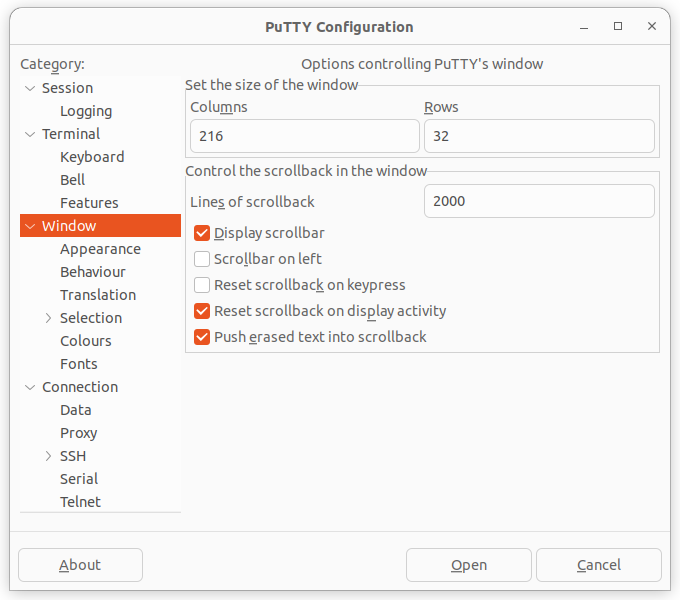
[picture p70: figure]
