davegutz/myStateOfCharge/SOC_Photon/dataReduction/rapidTweakRegressionTest20220723.txt

self_talk:  new string = 'Xp0'
self_talk:  new string = 'XS'
STOPPED
self_talk:  new string = 'Mk1'
rp.tweak_sclr   1.000 to   1.000
self_talk:  new string = 'Nk1'
rp.tweak_sclr from   1.000 to   1.000
self_talk:  new string = 'Dn0.998500'
coulombic eff from  0.9985, 0.9985, 0.9985, 0.9985, to  0.9985, 0.9985, 0.9985, 0.9985
self_talk:  new string = 'v0'
self_talk:  new string = 'Bm0'
Changing monitor chemistry from 0 to 0
self_talk:  new string = 'Bs0'
Changing simulation chemistry from 0 to 0 ('Battleborn')
self_talk:  new string = 'Xm15'
modeling from 7 to 15
Changed...soft reset
Modeling is 15
tweak_test is 1
mod_ib is 1
mod_vb is 1
mod_tb is 1
self_talk:  new string = 'Xts'
Set sin.  rp.type = 1
self_talk:  new string = 'Ca1'
soc=  1.000, modeling = 15, delta_q=  0.000, soc_model=  1.0000,   delta_q_model=  0.000, soc_ekf=  1.0000, delta_q_ekf= -0.095,
self_talk:  new string = 'Ri'
Amp cinf CC reset from -360000.0 to -360000.0
Amp dinf CC reset from  360000.0 to  360000.0
No amp cinf CC reset from -360000.0 to -360000.0
No amp dinf CC reset from  360000.0 to  360000.0
self_talk:  new string = 'Mw0'
Amp->time_to_wait from   6.000 to   0.000
self_talk:  new string = 'Nw0'
NoAmp->time_to_wait   6.000 to   0.000
self_talk:  new string = 'MC0.004'
Amp->max_change_   0.001000 to   0.004000
self_talk:  new string = 'Mx0.04'
Amp->max_tweak from   0.010 to   0.040
self_talk:  new string = 'NC0.004'
NoAmp->max_change_   0.001000 to   0.004000
self_talk:  new string = 'Nx0.04'
NoAmp->max_tweak   0.010 to   0.040
self_talk:  new string = 'Mk1'
rp.tweak_sclr   1.000 to   1.000
self_talk:  new string = 'Nk1'
rp.tweak_sclr from   1.000 to   1.000
self_talk:  new string = 'Dn1'
coulombic eff from  0.9985, 0.9985, 0.9985, 0.9985, to  1.0000, 1.0000, 1.0000, 1.0000
self_talk:  new string = 'Dp100'
100
self_talk:  new string = 'Xf0.02'
Injected freq set   0.020 Hz =   0.126 r/s
self_talk:  new string = 'Xa-2000'
Inj amp set -2000.000 & inj_bias set   0.000
self_talk:  new string = 'XW5'
Waiting     5.0 s to start inj
self_talk:  new string = 'XT5'
Waiting     5.0 s tail after inj
self_talk:  new string = 'XC3'
Num of inj cycles set to   3.000
self_talk:  new string = 'v24'
self_talk:  new string = 'Pa'
self_talk:  new string = 'Pm'

Mon:BatteryMonitor::Battery:
  temp_c_ =          25.000;  //  deg C
 *rp_delt_q_ =          0.0;  //  Coulombs
 *rp_t_last_ =         25.0;  // deg C
  dvoc_dt  =       0.004000;  //  V/deg C
  r_0 =            0.003000;  //  ohms
  r_ct =           0.001600;  //  ohms
  tau_ct =         0.200000;  //  s (=1/Rct/Cct)
  r_diff =         0.007700;  //  ohms
  tau_diff =      83.000000;  //  s (=1/Rdif/Cdif)
  r_sd =          70.000000;  //  ohms
  tau_sd =       25000000.0;  //  sec
  bms_off_ =              0;  // T=off
  dv_dsoc_=      122.995758;  // V/fraction
  ib_ =               0.000;  // A
  Ib =                0.000;  // Bank, A
  vb_ =              14.530;  // V
  Vb =               14.530;  // Bank, V
  voc_ =             14.530;  // V
  voc_stat_ =        14.530;  // V
  vsat_ =            13.800;  // V
  dv_dyn_ =           0.000;  // V
  sr_ =               1.000;  // Resistance scalar
  dv_ =               0.010;  // Table hard adj, V
  dt_ =               0.100;  // Update time, s
 *rp_nP_ =             1.00;  // P parallel in bank, e.g. '2P1S'
 *rp_nS_ =             1.00;  // S series in bank, e.g. '2P1S'
 BatteryMonitor::BatteryMonitor:
  amp_hrs_remaining_ekf_ =   92.250;  // Discharge amp*time left if drain to q_ekf=0, A-h
  amp_hrs_remaining_wt_  =   92.250;  // Discharge amp*time left if drain soc_wt_ to 0, A-h
  EKF_converged =                 1;  // EKF is converged, T=converged
  q_ekf =                  359999.9;  // Filtered charge calculated by ekf, C
  soc_ekf =                  1.0000;  // Solved state of charge, fraction
  soc_wt_ =                  1.0000;  // Weighted selection of ekf state of charge and coulomb counter (0-1)
  tcharge =                    24.0;  // Counted charging time to full, hr
  tcharge_ekf =                 0.0;  // Solved charging time to full from ekf, hr
  voc_filt_ =                14.480;  // Filtered charging voltage for saturation detect, V
  voc_stat_ =                14.530;  // Static model open circuit voltage from table (reference), V
  y_filt_ =                   0.000;  // Filtered y_ residual from EKF, V
Mon::Coulombs:
  q_cap_rated_ = 360000.0;  // Rated capacity at t_rated, C
  q_cap_rated_scaled_ =  360000.0;  // Applied rated capacity at t_rated_, C
  q_capacity_ =  360000.0;  // Saturation charge at temperature, C
  q_ =           360000.0;  // Present charge available to use, except q_min_, C
  q_min_ =        27900.0;  // Estimated charge at low voltage shutdown, C
  delta_q             0.0;  // Charge change since saturated, C
  soc_ =           1.0000;  // Fraction of saturation charge (q_capacity_) available (0-1);
  sat_ =                1;  // Indication that battery is saturated, T=saturated
  t_rated_ =         25.0;  // Rated temperature, deg C
  t_last =           25.0;  // Last battery temperature for rate limit memory, deg C
  t_rlim_ =         0.017;  // Tbatt rate limit, deg C / s
  resetting_ =          1;  // Flag to coordinate user testing of coulomb counters, T=performing an external reset of counter
  soc_min_ =       0.0775;  // Estimated soc where battery BMS will shutoff current, fraction
  mod_ =        Battleborn;  // Model type of battery chemistry e.g. Battleborn or LION
  mod_code_ =           0;  // Chemistry code integer
  coul_eff_ =      1.00000;  // Coulombic Efficiency
Coulombs::Chemistry:
  dqdt =          0.010;  // Change of charge with temperature, fraction/deg C (0.01 from literature)
  low_voc =      10.000;  // Volt threshold for BMS to turn off battery, V
  hys_cap =     360000.000;  // Cap of hysteresis, Farads
  v_sat =        13.850;  // Sat thresh at temp, V
  dvoc_dt =       0.004;  // Change of VOC with operating temperature in range 0 - 50 C V/deg C
  dv =            0.010;  // Adjustment for calibration error, V
  r_0 =          0.003000;  // Randles R0, ohms
  r_ct =         0.001600;  // Randles charge transfer resistance, ohms
  r_diff =       0.007700;  // Randles diffusion resistance, ohms
  tau_ct =        0.200;  // Randles charge transfer time constant, s (=1/Rct/Cct)
  tau_diff =     83.000;  // Randles diffusion time constant, s (=1/Rdif/Cdif)
  tau_sd =      25000000.000;  // Equivalent model for EKF reference.	Parasitic discharge time constant, sec
  r_sd =         70.000;  // Equivalent model for EKF reference.	Parasitic discharge equivalent, ohms
  r_ss =          0.012;  // Equivalent model for state space model initialization, ohms
  voc(t, soc):
    t=  {  5.000,  11.100,  20.000,  40.000, };
    soc={  0.000,   0.050,   0.100,   0.140,   0.170,   0.200,   0.250,   0.300,   0.400,   0.500,   0.600,   0.700,   0.800,   0.900,   0.990,   0.995,   1.000, };
    voc={
      {  4.000,   4.000,   6.000,   9.500,  11.700,  12.300,  12.500,  12.650,  12.820,  12.910,  12.980,  13.050,  13.110,  13.170,  13.220,  13.750,  14.450, },
      {  4.000,   4.000,   8.000,  11.600,  12.400,  12.600,  12.700,  12.800,  12.920,  13.010,  13.060,  13.110,  13.170,  13.200,  13.230,  13.760,  14.460, },
      {  4.000,   8.000,  12.200,  12.680,  12.730,  12.790,  12.810,  12.890,  13.000,  13.040,  13.090,  13.140,  13.210,  13.250,  13.270,  13.800,  14.500, },
      {  4.080,   8.080,  12.280,  12.760,  12.810,  12.870,  12.890,  12.970,  13.080,  13.120,  13.170,  13.220,  13.290,  13.330,  13.350,  13.880,  14.580, },
         };
  soc_min(temp_c):
    temp_c =  {  5.000,  11.100,  20.000,  40.000, };
    soc_min=  {  0.140,   0.120,   0.080,   0.070, };
  r(soc, dv):
    soc={0.000000, 0.500000, 1.000000, };
    dv ={ -0.900,  -0.700,  -0.500,  -0.300,   0.000,   0.300,   0.500,   0.700,   0.900, };
    r  ={
      { 0.000001,  0.064000,  0.050000,  0.036000,  0.015000,  0.024000,  0.030000,  0.046000,  0.000001, },
      { 0.000001,  0.000001,  0.050000,  0.036000,  0.015000,  0.024000,  0.030000,  0.000001,  0.000001, },
      { 0.000001,  0.000001,  0.000001,  0.036000,  0.015000,  0.024000,  0.000001,  0.000001,  0.000001, },
         };
Mon::StateSpace:
   A  =  [ -5.000000,  0.000000,
           0.000000, -0.012048];
   x  =  [  0.000000,  0.000000];
   B  =  [  0.008000,  0.000000,
           0.000093,  0.000000];
   u  =  [  0.000000, 14.530001];
   C  =  [ -1.000000, -1.000000];
   D  =  [ -0.003000,  1.000000];
   x_dot  =  [  0.000000,  0.000000];
   y  =  [ 14.530001];
   AinvB =  [  0.001600,  0.000000,
           0.007700,  0.000000];
  ::Hysteresis:
  res_ =         0.0150;  // Null, Ohms
  cap_init_ =  360000.0;  // Farads
  cap_ =       360000.0;  // Farads
  tau_ =         5400.0;  // Null time const, sec
  ib_ =           0.000;  // In, A
  ioc_ =          0.000;  // Out, A
  soc_ =         1.0000;  // Input
  res_ =          0.015;  // Variable value, ohms
  dv_dot_ =       0.000;  // Calculated rate, V/s
  dv_hys_ =       0.000;  // Delta state, V
  disabled_ =         0;  // Disabled by input < 1e-5, T=disab
  rp.hys_scale=    1.00;  // Scalar on hys
Mon::EKF_1x1:
Inputs:
  z  =    14.5300;  // 1x1 input, =voc, dynamic predicted by other model, V
  R  =   0.250000;  // 1x1 Kalman state uncertainty
  Q  =   0.000000;  // 1x1 Kalman process uncertainty
  H  =    122.996;  // 1x1 Jacobian sensitivity dV/dSOC
Outputs:
  x  =     1.0000;  // 1x1 Kalman state variable = Vsoc (0-1 fraction)
  hx =    14.5300;  // Output of observation function h(x)
  y  =     0.0000;  // 1x1 Residual z-hx, V
  P  =   0.000000;  // 1x1 Kalman uncertainty covariance
  K  =   0.000099;  // 1x1 Kalman gain
  S  =   0.253094;  // 1x1 system uncertainty

Sim:   rp.modeling = 15
self_talk:  new string = 'Ps'

Sim:   rp.modeling = 15
Sim:BatteryModel::Battery:
  temp_c_ =          25.000;  //  deg C
 *rp_delt_q_ =          0.0;  //  Coulombs
 *rp_t_last_ =         25.0;  // deg C
  dvoc_dt  =       0.004000;  //  V/deg C
  r_0 =            0.003000;  //  ohms
  r_ct =           0.001600;  //  ohms
  tau_ct =         0.200000;  //  s (=1/Rct/Cct)
  r_diff =         0.007700;  //  ohms
  tau_diff =      83.000000;  //  s (=1/Rdif/Cdif)
  r_sd =          70.000000;  //  ohms
  tau_sd =       25000000.0;  //  sec
  bms_off_ =              0;  // T=off
  dv_dsoc_=      122.999954;  // V/fraction
  ib_ =               0.000;  // A
  Ib =                0.000;  // Bank, A
  vb_ =              14.530;  // V
  Vb =               14.530;  // Bank, V
  voc_ =             14.530;  // V
  voc_stat_ =        14.530;  // V
  vsat_ =            13.800;  // V
  dv_dyn_ =           0.000;  // V
  sr_ =               1.000;  // Resistance scalar
  dv_ =               0.010;  // Table hard adj, V
  dt_ =               0.100;  // Update time, s
 *rp_nP_ =             1.00;  // P parallel in bank, e.g. '2P1S'
 *rp_nS_ =             1.00;  // S series in bank, e.g. '2P1S'
 BatteryModel::BatteryModel:
  sat_ib_max_ =         0.000;  // Current cutback to be applied to modeled ib output, A
  sat_ib_null_ =        0.000;  // Current cutback value for voc=vsat, A
  sat_cutback_gain_ =  1000.0;  // Gain to retard ib when voc exceeds vsat, dimensionless
  model_cutback_ =          1;  // Gain to retard ib when voc exceeds vsat, dimensionless
  model_saturated_ =        1;  // Modeled current being limited on saturation cutback, T = cutback limited
  ib_ =                 0.000;  // Battery terminal current, A
  ib_in_ =              0.000;  // Saved value of current input, A
  ib_fut_ =             0.000;  // Future value of limited current, A
  ib_sat_ =             0.500;  // Indicator of maximal cutback, T = cutback saturated
 *rp_s_cap_model_ =     1.000;  // Rated capacity scalar
Sim::Coulombs:
  q_cap_rated_ = 360000.0;  // Rated capacity at t_rated, C
  q_cap_rated_scaled_ =  360000.0;  // Applied rated capacity at t_rated_, C
  q_capacity_ =  360000.0;  // Saturation charge at temperature, C
  q_ =           360000.0;  // Present charge available to use, except q_min_, C
  q_min_ =        27900.0;  // Estimated charge at low voltage shutdown, C
  delta_q             0.0;  // Charge change since saturated, C
  soc_ =           1.0000;  // Fraction of saturation charge (q_capacity_) available (0-1);
  sat_ =                1;  // Indication that battery is saturated, T=saturated
  t_rated_ =         25.0;  // Rated temperature, deg C
  t_last =           25.0;  // Last battery temperature for rate limit memory, deg C
  t_rlim_ =         0.017;  // Tbatt rate limit, deg C / s
  resetting_ =          1;  // Flag to coordinate user testing of coulomb counters, T=performing an external reset of counter
  soc_min_ =       0.0775;  // Estimated soc where battery BMS will shutoff current, fraction
  mod_ =        Battleborn;  // Model type of battery chemistry e.g. Battleborn or LION
  mod_code_ =           0;  // Chemistry code integer
  coul_eff_ =      1.00000;  // Coulombic Efficiency
Coulombs::Chemistry:
  dqdt =          0.010;  // Change of charge with temperature, fraction/deg C (0.01 from literature)
  low_voc =      10.000;  // Volt threshold for BMS to turn off battery, V
  hys_cap =     360000.000;  // Cap of hysteresis, Farads
  v_sat =        13.850;  // Sat thresh at temp, V
  dvoc_dt =       0.004;  // Change of VOC with operating temperature in range 0 - 50 C V/deg C
  dv =            0.010;  // Adjustment for calibration error, V
  r_0 =          0.003000;  // Randles R0, ohms
  r_ct =         0.001600;  // Randles charge transfer resistance, ohms
  r_diff =       0.007700;  // Randles diffusion resistance, ohms
  tau_ct =        0.200;  // Randles charge transfer time constant, s (=1/Rct/Cct)
  tau_diff =     83.000;  // Randles diffusion time constant, s (=1/Rdif/Cdif)
  tau_sd =      25000000.000;  // Equivalent model for EKF reference.	Parasitic discharge time constant, sec
  r_sd =         70.000;  // Equivalent model for EKF reference.	Parasitic discharge equivalent, ohms
  r_ss =          0.012;  // Equivalent model for state space model initialization, ohms
  voc(t, soc):
    t=  {  5.000,  11.100,  20.000,  40.000, };
    soc={  0.000,   0.050,   0.100,   0.140,   0.170,   0.200,   0.250,   0.300,   0.400,   0.500,   0.600,   0.700,   0.800,   0.900,   0.990,   0.995,   1.000, };
    voc={
      {  4.000,   4.000,   6.000,   9.500,  11.700,  12.300,  12.500,  12.650,  12.820,  12.910,  12.980,  13.050,  13.110,  13.170,  13.220,  13.750,  14.450, },
      {  4.000,   4.000,   8.000,  11.600,  12.400,  12.600,  12.700,  12.800,  12.920,  13.010,  13.060,  13.110,  13.170,  13.200,  13.230,  13.760,  14.460, },
      {  4.000,   8.000,  12.200,  12.680,  12.730,  12.790,  12.810,  12.890,  13.000,  13.040,  13.090,  13.140,  13.210,  13.250,  13.270,  13.800,  14.500, },
      {  4.080,   8.080,  12.280,  12.760,  12.810,  12.870,  12.890,  12.970,  13.080,  13.120,  13.170,  13.220,  13.290,  13.330,  13.350,  13.880,  14.580, },
         };
  soc_min(temp_c):
    temp_c =  {  5.000,  11.100,  20.000,  40.000, };
    soc_min=  {  0.140,   0.120,   0.080,   0.070, };
  r(soc, dv):
    soc={0.000000, 0.500000, 1.000000, };
    dv ={ -0.900,  -0.700,  -0.500,  -0.300,   0.000,   0.300,   0.500,   0.700,   0.900, };
    r  ={
      { 0.000001,  0.064000,  0.050000,  0.036000,  0.015000,  0.024000,  0.030000,  0.046000,  0.000001, },
      { 0.000001,  0.000001,  0.050000,  0.036000,  0.015000,  0.024000,  0.030000,  0.000001,  0.000001, },
      { 0.000001,  0.000001,  0.000001,  0.036000,  0.015000,  0.024000,  0.000001,  0.000001,  0.000001, },
         };
Sim::StateSpace:
   A  =  [ -5.000000,  0.000000,
           0.000000, -0.012048];
   x  =  [  0.000000,  0.000000];
   B  =  [  0.008000,  0.000000,
           0.000093,  0.000000];
   u  =  [  0.000000, 14.530001];
   C  =  [  1.000000,  1.000000];
   D  =  [  0.003000,  1.000000];
   x_dot  =  [  0.000000,  0.000000];
   y  =  [ 14.530000];
   AinvB =  [  0.001600,  0.000000,
           0.007700,  0.000000];
  ::Hysteresis:
  res_ =         0.0150;  // Null, Ohms
  cap_init_ =  360000.0;  // Farads
  cap_ =       360000.0;  // Farads
  tau_ =         5400.0;  // Null time const, sec
  ib_ =           0.000;  // In, A
  ioc_ =          0.000;  // Out, A
  soc_ =         1.0000;  // Input
  res_ =          0.015;  // Variable value, ohms
  dv_dot_ =       0.000;  // Calculated rate, V/s
  dv_hys_ =       0.000;  // Delta state, V
  disabled_ =         0;  // Disabled by input < 1e-5, T=disab
  rp.hys_scale=    1.00;  // Scalar on hys
self_talk:  new string = 'Pr'

retained parameters (rp):
  debug =                     24;  // Level of debug printing
  delta_q =               0.000;  // Coulomb Counter state for ekf, (-1 - 1)
  t_last =               25.000;  // Battery temperature past value for rate limit memory, deg C
  delta_q_model =           0.0;  // Coulomb Counter state for model, (-1 - 1)
  t_last_model =         25.000;  // Battery temperature past value for rate limit memory, deg C
  ibatt_bias_amp =       -0.240;  // Calibrate amp current sensor, A
  ibatt_bias_noamp =     -1.100;  // Calibrate non-amplified current sensor, A
  ibatt_bias_all =        0.000;  // Bias all current sensors, A 
  ibatt_sel_noamp =           0;  // Use non-amplified sensor
  vbatt_bias =            1.500;  // Calibrate Vbatt, V
  modeling =                  15;  // Bit mapped modeling specification
  amp =                 -2000.000;  // Injected amplitude, A pk (0-18.3)
  freq =                  0.126;  // Injected frequency, r/s (0-2*pi)
  type =                      1;  //  Injected waveform type.   0=sine, 1=square, 2=triangle
  inj_bias =              0.000;  // Injected bias, A
  tbatt_bias =            0.000;  // Sensed temp bias, deg C
  s_cap_model =           1.000;  // Scalar on battery model size
  cutback_gain_scalar =   1.000;  // Scalar on battery model saturation cutback function
  isum =                      3;  // Summary location ptr.   Begins at -1
  delta_q_cinf_amp =  -360000.0;  // Coul
  delta_q_dinf_amp =   360000.0;  // Coul
  delta_q_cinf_noamp= -360000.0;  // Coul
  delta_q_dinf_noamp=  360000.0;  // Coul
  hys_scale =             1.000;  //  Hysteresis scalar
  tweak_sclr_amp =        1.000;  // Tweak calibration for amplified current
  tweak_sclr_noamp =      1.000;  // Tweak calibration for non-amplified current
  nP =                     1.00;  // Number of parallel batteries in bank, e.g. '2P1S'
  nS =                     1.00;  // Number of series batteries in bank, e.g. '2P1S'
  mon_mod =                   0;  //  Monitor battery model for electrical chars.  0=Battleborn, 1=LION
  sim_mod =                   0;  //  Simulation battery model for electrical chars.  0=Battleborn, 1=LION

command parameters(cp):
  enable_wifi =            0;
  model_cutback =          1;
  model_saturated =        1;
  soft_reset =             1;
  write_summary =          0;
  ibatt_bias_amp =     0.000;
  ibatt_bias_noamp =   0.000;
  dc_dc_on =               0;
  blynking =               0;
self_talk:  new string = 'Pt'

Mon::StateSpace:
   A  =  [ -5.000000,  0.000000,
           0.000000, -0.012048];
   x  =  [  0.000000,  0.000000];
   B  =  [  0.008000,  0.000000,
           0.000093,  0.000000];
   u  =  [  0.000000, 14.530001];
   C  =  [ -1.000000, -1.000000];
   D  =  [ -0.003000,  1.000000];
   x_dot  =  [  0.000000,  0.000000];
   y  =  [ 14.530001];
   AinvB =  [  0.001600,  0.000000,
           0.007700,  0.000000];
  ::Hysteresis:
  res_ =         0.0150;  // Null, Ohms
  cap_init_ =  360000.0;  // Farads
  cap_ =       360000.0;  // Farads
  tau_ =         5400.0;  // Null time const, sec
  ib_ =           0.000;  // In, A
  ioc_ =          0.000;  // Out, A
  soc_ =         1.0000;  // Input
  res_ =          0.015;  // Variable value, ohms
  dv_dot_ =       0.000;  // Calculated rate, V/s
  dv_hys_ =       0.000;  // Delta state, V
  disabled_ =         0;  // Disabled by input < 1e-5, T=disab
  rp.hys_scale=    1.00;  // Scalar on hys

Sim::StateSpace:
   A  =  [ -5.000000,  0.000000,
           0.000000, -0.012048];
   x  =  [  0.000000,  0.000000];
   B  =  [  0.008000,  0.000000,
           0.000093,  0.000000];
   u  =  [  0.000000, 14.530001];
   C  =  [  1.000000,  1.000000];
   D  =  [  0.003000,  1.000000];
   x_dot  =  [  0.000000,  0.000000];
   y  =  [ 14.530000];
   AinvB =  [  0.001600,  0.000000,
           0.007700,  0.000000];
  ::Hysteresis:
  res_ =         0.0150;  // Null, Ohms
  cap_init_ =  360000.0;  // Farads
  cap_ =       360000.0;  // Farads
  tau_ =         5400.0;  // Null time const, sec
  ib_ =           0.000;  // In, A
  ioc_ =          0.000;  // Out, A
  soc_ =         1.0000;  // Input
  res_ =          0.015;  // Variable value, ohms
  dv_dot_ =       0.000;  // Calculated rate, V/s
  dv_hys_ =       0.000;  // Delta state, V
  disabled_ =         0;  // Disabled by input < 1e-5, T=disab
  rp.hys_scale=    1.00;  // Scalar on hys
self_talk:  new string = 'PM'

Tweak::Shunt(Amp)::
  port_ =                0x49; // I2C port used by Acafruit_ADS1015
  bare_ =                   0; // If ADS to be ignored
  *cp_ibatt_bias_ =     0.000; // Global bias, A
  v2a_s_ =            -246.67; // Selected shunt conversion gain, A/V
  vshunt_int_ =           0; // Sensed shunt voltage, count
  ishunt_cal_ =         0.000; // Sensed, calibrated ADC, A
Shunt(Amp)::Tweak(Amp)::
  max_change_ =               0.004; // Maximum allowed change to calibration scalar see 'N/MC'
  max_tweak_ =                0.040; // Maximum allowed calibration scalar see 'N/Mx'
  rp_delta_q_cinf_ =      -360000.0; // Charge infinity at past update see 'N/Mi', Coulombs
  rp_delta_q_dinf_ =       360000.0; // Discharge infinity at past update see 'N/Mi', Coulombs
  sat_ =                          1; // Indication that battery is saturated, T=saturated
  delta_hrs_ =             0.030911; // Time since last allowed saturation see 'N/Mz', hr
  time_to_wait =           0.000000; // Time to wait before allowing saturation see 'N/Mw', hr
  tweak_sclr =                1.000; // Scalar on Coulombic Efficiency 'N/Mk'
  coul_eff_ =      1.00000;  // Coulombic Efficiency
Shunt(Amp)::Adafruit_ADS1x15 (Amp):
 m_bitShift =      4;
 m_gain =       2048;
 s_gain =       1024;
 m_dataRate =    128;
Adafruit_ADS1x15::Adafruit_I2CDevice (Amp):
  _addr =        0x49;
  _begun =          1;
  _maxBufferSize = 32;
self_talk:  new string = 'PN'

Tweak::Shunt(No Amp)::
  port_ =                0x48; // I2C port used by Acafruit_ADS1015
  bare_ =                   0; // If ADS to be ignored
  *cp_ibatt_bias_ =     0.000; // Global bias, A
  v2a_s_ =            -1189.30; // Selected shunt conversion gain, A/V
  vshunt_int_ =           0; // Sensed shunt voltage, count
  ishunt_cal_ =         0.000; // Sensed, calibrated ADC, A
Shunt(No Amp)::Tweak(No Amp)::
  max_change_ =               0.004; // Maximum allowed change to calibration scalar see 'N/MC'
  max_tweak_ =                0.040; // Maximum allowed calibration scalar see 'N/Mx'
  rp_delta_q_cinf_ =      -360000.0; // Charge infinity at past update see 'N/Mi', Coulombs
  rp_delta_q_dinf_ =       360000.0; // Discharge infinity at past update see 'N/Mi', Coulombs
  sat_ =                          1; // Indication that battery is saturated, T=saturated
  delta_hrs_ =             0.030913; // Time since last allowed saturation see 'N/Mz', hr
  time_to_wait =           0.000000; // Time to wait before allowing saturation see 'N/Mw', hr
  tweak_sclr =                1.000; // Scalar on Coulombic Efficiency 'N/Mk'
  coul_eff_ =      1.00000;  // Coulombic Efficiency
Shunt(No Amp)::Adafruit_ADS1x15 (No Amp):
 m_bitShift =      4;
 m_gain =       2560;
 s_gain =       2560;
 m_dataRate =    128;
Adafruit_ADS1x15::Adafruit_I2CDevice (No Amp):
  _addr =        0x48;
  _begun =          1;
  _maxBufferSize = 32;
self_talk:  new string = 'XR'
RUN: at 114934,   3.000 cycles from 119934 to 269934 with 5000 wait and 5000 tail
soft reset...
unit_sim,       115.171, 25.00000,25.00000, 13.80000,14.53000,0.00000,14.53000,   0.000,  0.000,  1,    0.000000,      0.0, 360000.0, 360000.0,   1.00000, 1, 
unit,               hm,                  cTime,       dt,       sat,sel,mod,  Tb,  Vb,  Ib,        Vsat,dV_dyn,Voc_stat,Voc_ekf,     y_ekf,    soc_m,soc_ekf,soc,soc_wt,
unit_m,  c_time,       Tb_m,Tbl_m,  vsat_m, voc_stat_m, dv_dyn_m, vb_m, ib_m, ib_in_m, sat_m, ddq_m, dq_m, q_m, qcap_m, soc_m, reset_m,
pro_20220723, 2022-07-23T03:59:34,       115.171, 0.237,   1,  0,  15,  25.0,14.530,     0.000,    13.80000,0.00000,14.53000,14.52986,   0.000143, 1.00000,1.00000,1.00000,1.00000,
unit_sim,       115.271, 25.00000,25.00000, 13.80000,14.53000,0.00000,14.53000,   0.000,  0.000,  1,    0.000000,      0.0, 360000.0, 360000.0,   1.00000, 0, 
pro_20220723, 2022-07-23T03:59:35,       115.271, 0.100,   1,  0,  15,  25.0,14.530,     0.000,    13.80000,0.00000,14.53000,14.52986,   0.000143, 1.00000,1.00000,1.00000,1.00000,
unit_sim,       115.371, 25.00000,25.00000, 13.80000,14.53000,0.00000,14.53000,   0.000,  0.000,  1,    0.000000,      0.0, 360000.0, 360000.0,   1.00000, 0, 
pro_20220723, 2022-07-23T03:59:35,       115.371, 0.100,   1,  0,  15,  25.0,14.530,     0.000,    13.80000,0.00000,14.53000,14.52986,   0.000143, 1.00000,1.00000,1.00000,1.00000,
unit_sim,       115.471, 25.00000,25.00000, 13.80000,14.53000,0.00000,14.53000,   0.000,  0.000,  1,    0.000000,      0.0, 360000.0, 360000.0,   1.00000, 0, 
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
unit_sim,       166.325, 25.00000,25.00000, 13.80000,13.81028,4.86420,18.67012, 929.413,907.086,  0,   92.941278,  -1774.0, 358226.0, 360000.0,   0.99507, 0,
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
