davegutz/myStateOfCharge/SOC_Particle/Battery State/EKF/sandbox/figures/Test_plot.py2.png

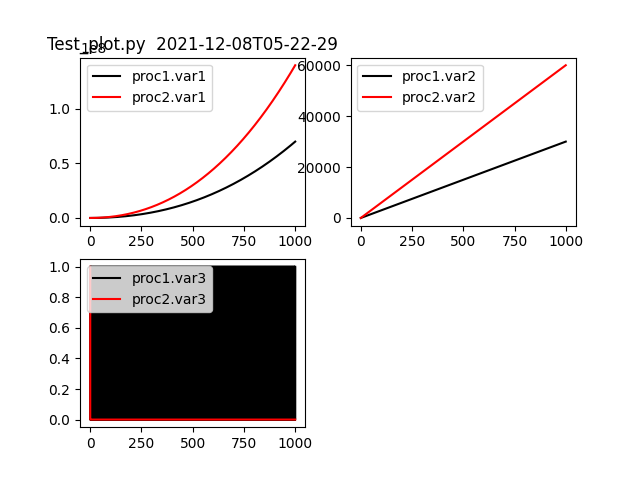
SOC_Particle/Battery State/EKF/sandbox/figures/Test_plot.py2.png
