davegutz/myStateOfCharge/SOC_Particle/datasheets/Schematics/ASD_OPA Test.jpg

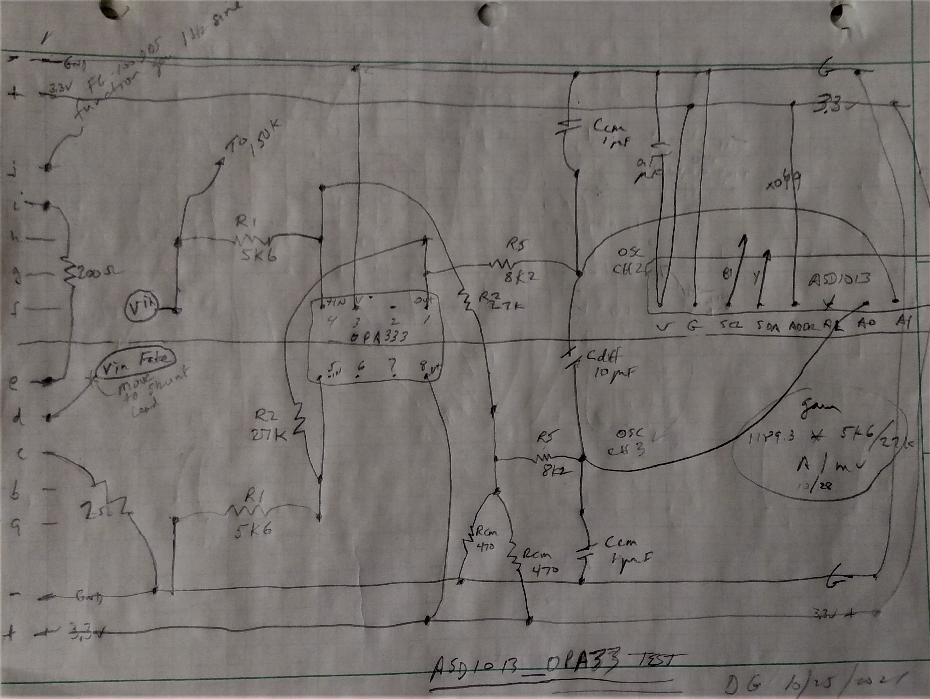
SOC_Particle/datasheets/Schematics/ASD_OPA Test.jpg
