davegutz/myStateOfCharge/SOC_Particle/datasheets/Schematics/opa333_asd1013_3_expected_result.png

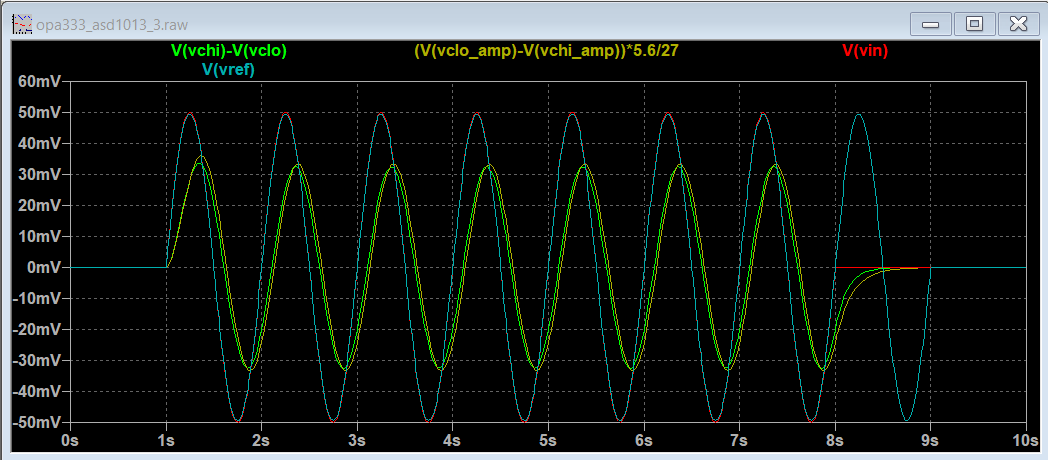
SOC_Particle/datasheets/Schematics/opa333_asd1013_3_expected_result.png
