davegutz/myStateOfCharge/SOC_Particle/pyStateOfCharge/Calibrate_exe_4.png

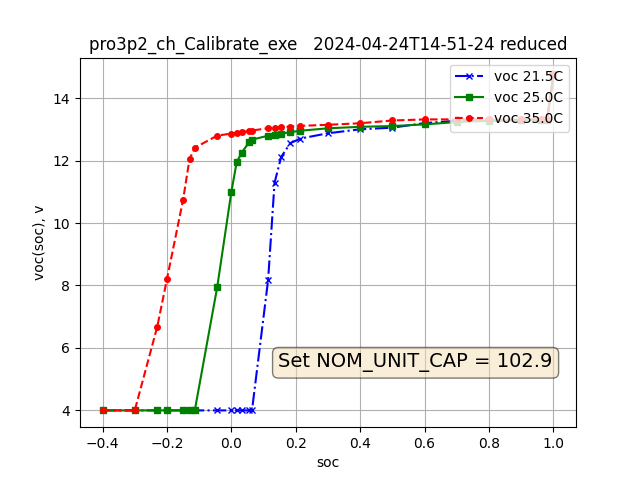
SOC_Particle/pyStateOfCharge/Calibrate_exe_4.png
