davegutz/myStateOfCharge/SOC_Particle/pyStateOfCharge/GUI_TestSOC.png

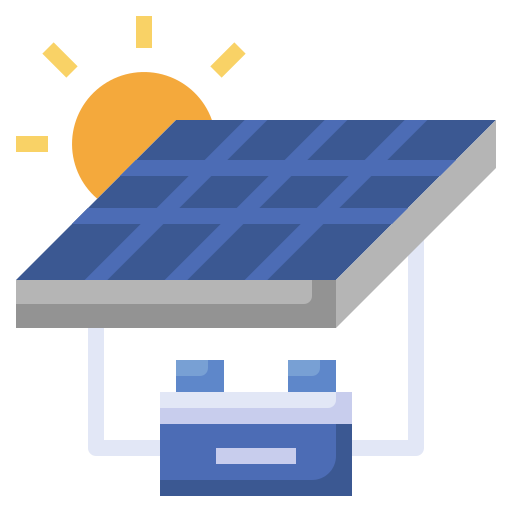
SOC_Particle/pyStateOfCharge/GUI_TestSOC.png
