davegutz/myStateOfCharge/SOC_Sense/doc/GUI_TestSOC.png

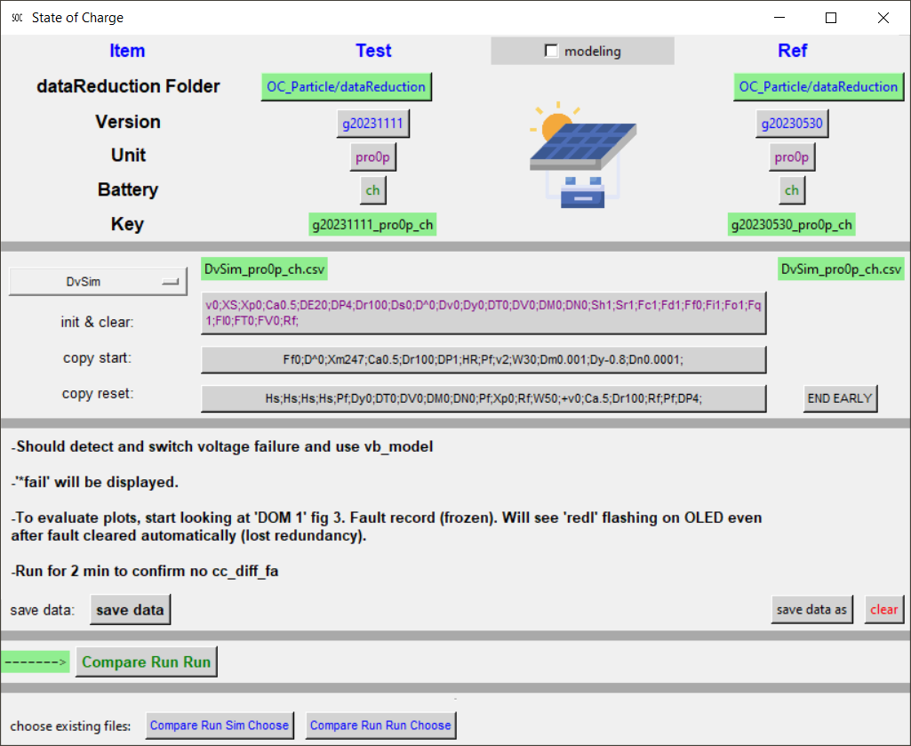
SOC_Sense/doc/GUI_TestSOC.png
