davegutz/myStateOfCharge/SOC_Particle/datasheets/pSpice/2s2p_batt_test_1.asc

I1: current; SINE(0 200 1 1 0 0 3)
R2: res; {r32}
R3: res; {r41}
R4: res; {r42}
R5: res; {r}
R6: res; {r}
R7: res; {r}
R8: res; {r}
R9: res; {r34}
R10: res; {r21}
R11: res; {r13}
V1: voltage; 12
V2: voltage; 12
V3: voltage; 12
V4: voltage; 12
Named nets: 0
.tran 0 5 0 0.001
.param r=.011 rawg2=0.00039 r21=1*rawg2 r41=2.5*rawg2 r32=0.5*rawg2 r34=1*rawg2 r42=2*rawg2 r13=2*rawg2
