davegutz/myStateOfCharge/SOC_Particle/datasheets/pSpice/ib_filter_module_ladder.asc

I1: current; 200p
R1: res; {R2}
R2: res; {R1}
R3: res; {R1}
R4: res; {R2}
R5: res; {Rr}
R6: res; {Rr}
R7: res; 3000
R8: res; {Radc}
R9: res; {Rtest}
UniversalOpAmp2_1: UniversalOpamp2
V1: voltage; 3.3
V2: voltage; {R1}
V3: voltage; {R2}
V4: voltage; {RS}
Named nets: 0, v-, v+, VON, Vr, R1, R2, RS, vv
.param Rr=1k R1=5k1 R2=75k RS=.075/200 Radc=2k1 Rtest=47
.tran 1
.measurements IN=(V(von)-V(vr))/{R2}*{R1}/{RS}
.step param Rtest list 22 47 68
.step param Radc 2k 44k 5k5
