davegutz/myStateOfCharge/SOC_Particle/datasheets/pSpice/ib_filter_module.asc

I1: current; SINE(0 250 4 0 0 0 4)
R1: res; {R2}
R2: res; {R1}
R3: res; {R1}
R4: res; {R2}
R5: res; {Rr}
R6: res; {Rr}
R7: res; {RS}
R8: res; {Radc}
UniversalOpAmp2_1: UniversalOpamp2
V1: voltage; 3.3
V2: voltage; {R1}
V3: voltage; {R2}
V4: voltage; {RS}
Named nets: 0, v-, v+, VON, Vr, R1, R2, RS
.param Rr=1k R1=5k1 R2=75k RS=.075/200 Radc=2k1
.tran 1
.measurements IN=(V(von)-V(vr))/{R2}*{R1}/{RS}
