davegutz/myStateOfCharge/SOC_Particle/datasheets/pSpice/opa333fil_ina181_NR_1.asc

C1: cap; {ccm_amp}
C2: cap; {ccm_amp}
C3: cap; {ccm_amp}
C4: cap; {cfil}
C5: cap; {ccm_amp}
I1: current; SINE(0 25 1.1 1 0 0 7)
R1: res; {r1}
R2: res; {r2}
R3: res; {r1+Re1}
R4: res; {r2}
R5: res; {r5}
R6: res; {r5}
R7: res; {Rpinch}
R9: res; {r5}
R10: res; {r5}
Rcm1: res; {rcm}
Rcm2: res; {rcm}
Rshunt: res; {rshunt}
Rthi: res; {rtlo*100}
Rtlo: res; {rtlo}
U1: ADA4805
U2: INA181A3
U3: INA181A4
U4: INA181A1
V1: voltage; SINE(0 5 1 1 0 0 8)
V2: signal; PWL file=C:\Users\daveg\Documents\GitHub\myStateOfCharge\SOC_Particle\datasheets\pSpice\Rigol\oneFanOff_vin.txt
V3v3: voltage; 3.3
Named nets: 0, Vcm, Vin, Vref, Vclo_ina181a4, Vclo_ina181a1, Vclo_ina181a3, v_ina181a3, v_ina181a4, v_ina181a1, v_diy, vin_fil, vr
.param rshunt=0.00075 rcm=470 r1=5k r2=1000k r5=15k ccm_amp=10uf rtlo=2 Rpinch=1e-6 Re1=0 cfil=0.15uf
.tran 0 1.06 1 0.001
Files:
C:\\Users\\daveg\\Documents\\GitHub\\myStateOfCharge\\SOC_Particle\\datasheets\\pSpice\\Rigol\\light_vin.txt
C:\\Users\\daveg\\Documents\\GitHub\\myStateOfCharge\\SOC_Particle\\datasheets\\pSpice\\Rigol\\light_vr.txt
C:\\Users\\daveg\\Documents\\GitHub\\myStateOfCharge\\SOC_Particle\\datasheets\\pSpice\\Rigol\\bothFansHiOsc_vin.txt
C:\\Users\\daveg\\Documents\\GitHub\\myStateOfCharge\\SOC_Particle\\datasheets\\pSpice\\Rigol\\bothFansHiOsc_vr.txt
C:\\Users\\daveg\\Documents\\GitHub\\myStateOfCharge\\SOC_Particle\\datasheets\\pSpice\\Rigol\\oneFanHi_vin.txt
C:\\Users\\daveg\\Documents\\GitHub\\myStateOfCharge\\SOC_Particle\\datasheets\\pSpice\\Rigol\\oneFanHi_vr.txt
C:\\Users\\daveg\\Documents\\GitHub\\myStateOfCharge\\SOC_Particle\\datasheets\\pSpice\\Rigol\\oneFanLow_vin.txt
C:\\Users\\daveg\\Documents\\GitHub\\myStateOfCharge\\SOC_Particle\\datasheets\\pSpice\\Rigol\\oneFanLow_vr.txt
C:\\Users\\daveg\\Documents\\GitHub\\myStateOfCharge\\SOC_Particle\\datasheets\\pSpice\\Rigol\\oneFanOff_vin.txt
C:\\Users\\daveg\\Documents\\GitHub\\myStateOfCharge\\SOC_Particle\\datasheets\\pSpice\\Rigol\\oneFanOff_vr.txt
C:\\Users\\daveg\\Documents\\GitHub\\myStateOfCharge\\SOC_Particle\\datasheets\\pSpice\\Rigol\\inverterOff_vin.txt
C:\\Users\\daveg\\Documents\\GitHub\\myStateOfCharge\\SOC_Particle\\datasheets\\pSpice\\Rigol\\inverterOff_vr.txt
