davegutz/myStateOfCharge/SOC_Particle/datasheets/pSpice/opa333fil_ina181_FR_0.asc

C2: cap; {ccm_amp}
C4: cap; {cfil}
I1: current; SINE(0 10 1.1 1 0 0 7)
R1: res; {r1}
R2: res; {r2}
R3: res; {r1+Re1}
R4: res; {r2}
R7: res; {Rpinch}
R9: res; {r5}
Rcm1: res; {rcm}
Rcm2: res; {rcm}
Rshunt: res; {rshunt}
Rthi: res; {rtlo*100}
Rtlo: res; {rtlo}
U1: ADA4805
U2: INA181A4
V1: voltage; SINE(0 5 1 1 0 0 8)
V3v3: voltage; 3.3
Named nets: 0, Vcm, Vin, Vref, Vclo_ina181a4, v_ina181a4, v_diy
.param rshunt=0.00075 rcm=470 r1=5k r2=1000k r5=15k ccm_amp=10uf rtlo=2 Rpinch=1e-6 Re1=0 cfil=.15uf
.tran 0 8 0 0.001
