davegutz/myStateOfCharge/SOC_Particle/datasheets/pSpice/tsc2010_0.asc

Ccm2: cap; {ccm_amp}
I1: current; SINE(0 100 1 1 0 0 7)
R1: res; {r1}
R2: res; {r2}
R3: res; {r1+Re1}
R4: res; {r2}
R5: res; {r5}
R7: res; {Rpinch}
Rcm1: res; {rcm}
Rcm2: res; {rcm}
Rshunt: res; {rshunt}
Rthi: res; {rtlo*100}
Rtlo: res; {rtlo}
U1: ADA4805
V1: voltage; SINE(0 5 1 1 0 0 8)
V3v3: voltage; 3.3
Named nets: 0, Vcm, Vclo_amp, Vin, Vref
.param rshunt=0.00075 rcm=470 r1=5k r2=100k r5=10k ccm_amp=1uf rtlo=2 Rpinch=1e-6 Re1=0
.tran 0 10 0 0.001
