davegutz/myStateOfCharge/SOC_Particle/datasheets/pSpice/opa333_7_beta.asc

C1: cap; {c105}
C2: cap; {c106}
C3: cap; {c105}
C4: cap; {c105}
C5: cap; {c105}
C6: cap; {c105}
C7: cap; {c105}
Ccm1: cap; {c105}
Ccm2: cap; {c105}
Cdiff1: cap; {c106}
Cdiff3: cap; {c106}
Cdiff: cap; {c106}
I1: current; SINE(0 100 1 1 0 0 7)
I2: current; SINE(0 100 1 1 0 0 7)
R1: res; {r1}
R2: res; {r2}
R3: res; {r1+Re1}
R4: res; {r2}
R5: res; {r5}
R6: res; {r5}
R7: res; {Rpinch}
R8: res; {r5_mod}
R9: res; {r5_mod}
R10: res; {rdiff}
R11: res; {r1+Re1}
R12: res; {r2}
R13: res; {r5}
R14: res; {r5}
R15: res; {r2}
R16: res; {r1}
R18: res; {r1+Re1}
R19: res; {r2}
R20: res; {r2}
R21: res; {r1}
R22: res; {r5}
R23: res; {r5}
R25: res; {Rpinch}
Ra2dA2: res; {rdiff}
Ra2dA3: res; {rdiff}
Ra2dA4: res; {rdiff}
Ra2dA5: res; {rdiff}
Rcm1: res; {rcm}
Rcm2: res; {rcm}
Rcm3: res; {rcm}
Rcm4: res; {rcm}
Rcm5: res; {rcm}
Rcm6: res; {rcm}
Rdiff: res; {rdiff}
Rshunt1: res; {rshunt}
Rshunt: res; {rshunt}
U1: ADA4805
U2: ADA4805
U3: ADA4805
V2: voltage; 3.3
V3v3: voltage; 3.3
Named nets: 0, Vcm, Vchi, Vclo, Vchi_mod, Vclo_mod, vc_amp, v_amp, v_noa, vc_noa
.param rshunt=0.00075 r0=150k c0=1uF rcm=1000 rs=8.4e-4 r1=5k1 r2=100k r5=10k c106=10uF c105=1uF rtlo=2 rdiff=710k Rpinch=10 Re1=-1000 r5_mod=8k2
.tran 0 10 0 0.001
1 second time constant
low impedance supply
high impedance
high impedance
high impedance
high impedance
1 second time constant
low impedance supply
high impedance
high impedance
high impedance
high impedance
high impedance
high impedance
high impedance
high impedance
