davegutz/myStateOfCharge/SOC_Particle/datasheets/pSpice/opa333_6_beta.asc

C1: cap; {c105}
C2: cap; {c106}
C3: cap; {c105}
Ccm1: cap; {c105}
Ccm2: cap; {c105}
Cdiff: cap; {c106}
I1: current; SINE(0 100 1 1 0 0 7)
R1: res; {r1}
R2: res; {r2}
R3: res; {r1+Re1}
R4: res; {r2}
R5: res; {r5}
R6: res; {r5}
R7: res; {Rpinch}
R8: res; {r5_mod}
R9: res; {r5_mod}
R10: res; {rdiff}
Rcm1: res; {rcm}
Rcm2: res; {rcm}
Rdiff: res; {rdiff}
Rshunt: res; {rshunt}
Rthi: res; {rtlo*100}
Rtlo: res; {rtlo}
U1: ADA4805
V1: voltage; SINE(0 5 1 1 0 0 8)
V3v3: voltage; 3.3
Named nets: 0, Vcm, Vchi, Vclo, Vin, Vref, Vchi_mod, Vclo_mod
.param rshunt=0.00075 r0=150k c0=1uF rcm=1000 rs=8.4e-4 r1=5k1 r2=100k r5=10k c106=10uF c105=1uF rtlo=2 rdiff=710k Rpinch=1000 Re1=-1000 r5_mod=8k2
.tran 0 10 0 0.001
1 second time constant
low impedance supply
low impedance supply
high impedance
high impedance
high impedance
high impedance
