davegutz/myStateOfCharge/SOC_Particle/datasheets/pSpice/GP_battery.asc

Cct: cap; {Cct/nCells}
Cdif: cap; {Cdif/nCells}
I: current; PULSE(0 30 1 0.001 0 200 400)
R0: res; {R0*nCells}
Rct: res; {Rct*nCells}
Rdif: res; {Rdif*nCells}
Vocv: voltage; 13.5
Named nets: 0, Vc, Vd, Vb, Vocv
.param Cct=2300  Rct=0.0016  Cdif=10820  Rdif=0.0077  R0=0.003 nCells=4
.tran 0 200 0.1 0.1
