davegutz/myStateOfCharge/SOC_Particle/datasheets/pSpice/RC-RC.asc

Cct: cap; {Cct}
Cdif: cap; {Cct}
I: current; PULSE(0 30 1 0.001 0 200 400)
R0: res; 0
Rct: res; {Rct}
Rdif: res; {Rct}
Vocv: voltage; 13.5
Named nets: 0, Vc, Vd, Vb, Vocv
.param Cct=2300  Rct=0.0016  Cdif=10820  Rdif=0.0077  R0=0.003
.tran 0 25 0 0.01
