davegutz/myStateOfCharge/SOC_Particle/datasheets/pSpice/opa333_asd1013_1.asc

Ccm1: cap; {ccm}
Ccm2: cap; {ccm}
Cdiff: cap; {cdiff}
R1: res; {r1}
R2: res; {r2}
R3: res; {r1}
R4: res; {r2}
R5: res; {r5}
R6: res; {r5}
Rcm1: res; {rcm}
Rcm2: res; {rcm}
Rthi: res; {rtlo*100}
Rtlo: res; {rtlo}
U1: ADA4805
V1: voltage; SINE(0 5 1 1 0 0 8)
V3v3: voltage; 3.3
Named nets: 0, Vcm, Vchi, Vclo, Vin
.PARAM  rcm=470  rs=8.4e-4  r1=5k6  r2=27k  r5=8k3  cdiff=10uF  ccm=1uF rtlo=2
.tran 0 10 0 0.001
