davegutz/myStateOfCharge/SOC_Particle/datasheets/pSpice/opa333_asd1013_2.asc

C0: cap; {c0}
Ccm1: cap; {ccm}
Ccm2: cap; {ccm}
Cdiff: cap; {cdiff}
R0: res; {r0}
R1: res; {r1}
R2: res; {r2}
R3: res; {r1}
R4: res; {r2}
R5: res; {r5}
R6: res; {r5}
R9: res; {rload}
R10: res; {rload}
Rcm1: res; {rcm}
Rcm2: res; {rcm}
Rdiff: res; {rdiff}
Rdiff_amp: res; {rdiff}
Rthi: res; {rtlo*100}
Rtlo: res; {rtlo}
U1: ADA4805
V1: voltage; SINE(0 5 1 1 0 0 8)
V3v3: voltage; 3.3
Named nets: 0, Vcm, Vchi_amp, Vclo_amp, Vin, Vchi, Vclo
.param r0=150k c0=1uF rload=1k rcm=470 rs=8.4e-4 r1=5k6 r2=27k r5=8k3 cdiff=10uF ccm=1uF rtlo=2 rdiff=710k
.tran 0 10 0 0.001
1 second time constant
1 second time constant
low impedance supply
low impedance supply
high impedance
high impedance
high impedance
high impedance
high impedance
