davegutz/myStateOfCharge/SOC_Particle/datasheets/pSpice/opa333_asd1013_0.asc

Ccm1: cap; {ccm}
Ccm2: cap; {ccm}
Cdiff: cap; {cdiff}
R1: res; {r1}
R2: res; {r2}
R3: res; {r1}
R4: res; {r2}
R5: res; {r5}
R6: res; {r5}
Rcm1: res; {rcm}
Rcm2: res; {rcm}
U1: ADA4805
V3v3: voltage; 3.3
Vin: voltage; PULSE(0 .05 .1 1e-12 1e-12 2 4 4)
Named nets: 0, Vcm, Vchi, Vclo, Vilo, Vin
.PARAM  rcm=470  rs=8.4e-4  r1=5k6  r2=27k  r5=8k3  cdiff=10uF  ccm=1uF rthi=200 rtlo=2
.tran 0 4 0 0.001
