davegutz/myStateOfCharge/SOC_Particle/datasheets/pSpice/lpf.asc

C1: cap; 1e-6
R0: res; 150k
V1: voltage; PULSE(0 -.05 .02 .002 .002 0 .012)
Named nets: Vfilt_lpf, 0
.tran 0 1 0 .0001 startup uic
