davegutz/myStateOfCharge/SOC_Particle/datasheets/pSpice/lpf_Vbatt.asc

C1: cap; 1e-6
R0: res; 150k
R1: res; 20k
R2: res; 4k7
V1: voltage; PULSE(0 -2 .02 .002 .002 0 .012)
Named nets: 0, Vbatt_s_f, Vbatt_s
.tran 0 1 0 .0001 startup uic
