davegutz/myStateOfCharge/SOC_Particle/datasheets/pSpice/lpf_Vbatt1.asc

C1: cap; 4.7µf
R0: res; 150k
R1: res; 36k
V1: voltage; PULSE(0 -2 .02 .002 .002 0 .012)
Named nets: 0, Vbatt1_f_s
.tran 0 1 0 .0001 startup uic
