davegutz/myStateOfCharge/SOC_Particle/datasheets/pSpice/lpf_Vbatt2.asc

C1: cap; 33µf
R0: res; 20k
R1: res; 4.7k
V1: voltage; PULSE(0 -2 .02 .002 .002 0 .012)
Named nets: 0, Vbatt2_f_s
.tran 0 1 0 .0001 startup uic
