davegutz/myStateOfCharge/(list of files, drawings)

Other design files:
DS18B20-master/verified/ds18b20.fzz
