davegutz/myStateOfCharge/SOC_Particle/src/Sensors.cpp

//
// MIT License
//
// Copyright (C) 2023 - Dave Gutz
//
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
#include "application.h"
#include "command.h"
#include "Sensors.h"
#include "constants.h"
#include <math.h>
#include "debug.h"
#include "Summary.h"

extern CommandPars cp;  // Various parameters shared at system level
extern PrinterPars pr;  // Print buffer
extern PublishPars pp;  // For publishing
extern SavedPars sp;    // Various parameters to be static at system level and saved through power cycle

// Print bitmap utility
void bitMapPrint(char *buf, const int16_t fw, const uint8_t num)
{
  for ( int i=0; i<num; i++ )
  {
    if ( bitRead(fw, i) ) buf[num-i-1] = '1';
    else  buf[num-i-1] = '0';
  }
  buf[num] = '\0';
}


// class TempSensor
// constructors
TempSensor::TempSensor(const uint16_t pin, const bool parasitic, const uint16_t conversion_delay)
: DS18B20(pin, true, conversion_delay), tb_stale_flt_(true)
{
   SdTb = new SlidingDeadband(HDB_TBATT);
   Serial.printf("DS18 1-wire Tb started\n");
}
TempSensor::TempSensor(const uint16_t pin, const bool parasitic, const uint16_t conversion_delay, const uint16_t VTb_pin)
: DS18B20(pin, true, conversion_delay), tb_stale_flt_(true), VTb_pin_(VTb_pin)
{
   SdTb = new SlidingDeadband(HDB_TBATT);
   Serial.printf("DS18 1-wire Tb started\n");
}
TempSensor::~TempSensor() {}
// operators
// functions
float TempSensor::sample(Sensors *Sen)
{
  Log.info("top TempSensor::sample");
  // Read Sensor
  // MAXIM conversion 1-wire Tp plenum temperature
  static float Tb_hdwe = 0.;

  #ifdef HDWE_DS18B20_SWIRE
    uint8_t count = 0;
    float temp = 0.;
    // Read hardware and check
    while ( ++count<MAX_TEMP_READS && temp==0 && !sp.mod_tb_dscn() )
    {
        if ( crcCheck() ) temp = getTemperature() + (TBATT_TEMPCAL);
      delay(1);
    }

    // Check success
    if ( count<MAX_TEMP_READS && TEMP_RANGE_CHECK<temp && temp<TEMP_RANGE_CHECK_MAX && !ap.fail_tb )
    {
      Tb_hdwe = SdTb->update(temp);
      tb_stale_flt_ = false;
      if ( sp.debug()==16 ) Serial.printf("I:  t=%7.3f ct=%d, Tb_hdwe=%7.3f,\n", temp, count, Tb_hdwe);
    }
    else
    {
      Serial.printf("DS18 1-wire Tb, t=%8.1f, ct=%d, sending Tb_hdwe=%8.1f\n", temp, count, Tb_hdwe);
      tb_stale_flt_ = true;
      // Using last-good-value:  no assignment
    }

  #elif defined(HDWE_DS2482_1WIRE)
    // Check success

    if ( cp.tb_info.ready && TEMP_RANGE_CHECK<cp.tb_info.t_c && cp.tb_info.t_c<TEMP_RANGE_CHECK_MAX && !ap.fail_tb )
    {
      Tb_hdwe = SdTb->update(cp.tb_info.t_c);
      tb_stale_flt_ = false;
      if ( sp.debug()==16 ) Serial.printf("I:  t=%7.3f ready=%d, Tb_hdwe=%7.3f,\n", cp.tb_info.t_c, cp.tb_info.ready, Tb_hdwe);
    }
    else
    {
      if ( sp.debug()>0 )
        Serial.printf("DS18 1-wire Tb, t=%8.1f, ready=%d, sending Tb_hdwe=%8.1f\n", cp.tb_info.t_c, cp.tb_info.ready, Tb_hdwe);
      tb_stale_flt_ = true;
      // Using last-good-value:  no assignment
    }

  #elif defined(HDWE_2WIRE)

    float volt = float(analogRead(VTb_pin_))*VTB_CONV_GAIN;
    float res = volt * float(HDWE_RS_2WIRE) / (V3V3 - volt);

    #ifdef USE_SH_2WIRE
      // Steinhart-Hart (see '2-wireRTD.ods')
      float lnres = log(res);
      Tb_hdwe = ( 1. / max( HDWE_SHA_2WIRE + (HDWE_SHB_2WIRE + HDWE_SHC_2WIRE *lnres*lnres) * lnres, 0.000001 ) ) - 273.;

    #else
      // Data fit (see '2-wireRTD.ods')
      Tb_hdwe = float(HDWE_M_2WIRE) * log10(res) + float(HDWE_B_2WIRE);

    #endif

    tb_stale_flt_ = false;
    if ( sp.debug()==16 ) Serial.printf("I 2wire:  volt=%7.3f Tb_hdwe=%7.3f,\n", volt, Tb_hdwe);

  #endif

  return ( Tb_hdwe );
}


// class Shunt
// constructors
Shunt::Shunt()
: Adafruit_ADS1015(), name_("None"), port_(0x00), bare_shunt_(false){}
Shunt::Shunt(const String name, const uint8_t port, float *sp_ib_scale,  float *sp_Ib_bias, const float v2a_s,
  const uint8_t vc_pin, const uint8_t vo_pin, const uint8_t vh3v3_pin, const boolean using_opAmp)
: Adafruit_ADS1015(),
  name_(name), port_(port), bare_shunt_(false), v2a_s_(v2a_s),
  vshunt_int_(0), vshunt_int_0_(0), vshunt_int_1_(0), vshunt_(0), Ishunt_cal_(0), Ishunt_cal_filt_(0),
  sp_ib_bias_(sp_Ib_bias), sp_ib_scale_(sp_ib_scale), sample_time_(0UL), sample_time_z_(0UL), dscn_cmd_(false),
  vc_pin_(vc_pin), vo_pin_(vo_pin), vr_pin_(vh3v3_pin), Vc_raw_(HALF_V3V3/VH3V3_CONV_GAIN), Vc_(HALF_V3V3),
  Vo_Vc_(0.), using_opamp_(using_opAmp)
{
  #ifdef HDWE_ADS1013_AMP_NOA
    if ( name_=="No Amp")
      setGain(GAIN_SIXTEEN, GAIN_SIXTEEN); // 16x gain differential and single-ended  +/- 0.256V  1 bit = 0.125mV  0.0078125mV
    else if ( name_=="Amp")
      setGain(GAIN_EIGHT, GAIN_TWO); // First argument is differential, second is single-ended.
    else
      setGain(GAIN_EIGHT, GAIN_TWO); // First argument is differential, second is single-ended.
    if (!begin(port_)) {
      Serial.printf("FAILED init ADS SHUNT MON %s\n", name_.c_str());
      #ifndef HDWE_BARE
        bare_shunt_ = true;
      #else
        bare_shunt_ = false;
      #endif
    }
    else Serial.printf("SHUNT MON %s started\n", name_.c_str());
  #else
    if ( using_opamp_ ) Serial.printf("Ib %s sense ADC pin %d started using OpAmp and 3V3 pin %d\n", name_.c_str(), vo_pin_, vr_pin_);
    else Serial.printf("Ib %s sense ADC pins %d and %d started\n", name_.c_str(), vo_pin_, vc_pin_);
  #endif
  Filt_ = new General2_Pole(0.1, F_W_I, F_Z_I, -NOM_UNIT_CAP*sp.nP(), NOM_UNIT_CAP*sp.nP());  // actual update time provided run time
}
Shunt::~Shunt() {}
// operators
// functions

void Shunt::pretty_print()
{
#ifndef SOFT_DEPLOY_PHOTON
  Serial.printf(" *sp_Ib_bias%7.3f; A\n", *sp_ib_bias_);
  Serial.printf(" *sp_ib_scale%7.3f; A\n", *sp_ib_scale_);
  Serial.printf(" bare_shunt %d dscn_cmd %d\n", bare_shunt_, dscn_cmd_);
  Serial.printf(" Ishunt_cal%7.3f; A\n", Ishunt_cal_);
  Serial.printf(" Ishunt_cal_filt%7.3f; A\n", Ishunt_cal_filt_);
  Serial.printf(" port 0x%X;\n", port_);
  Serial.printf(" v2a_s%7.2f; A/V\n", v2a_s_);
  Serial.printf(" Vc%10.6f; V\n", Vc_);
  Serial.printf(" Vc_raw %d;\n", Vc_raw_);
  Serial.printf(" Vo%10.6f; V\n", Vo_);
  Serial.printf(" Vo-Vc%10.6f; V\n", Vo_-Vc_);
  Serial.printf(" Vo_raw %d;\n", Vo_raw_);
  Serial.printf(" vshunt_int %d; count\n", vshunt_int_);
  Serial.printf("Shunt(%s)::\n", name_.c_str());
  // Serial.printf("Shunt(%s)::", name_.c_str()); Adafruit_ADS1015::pretty_print(name_);
#else
     Serial.printf("Shunt: silent DEPLOY\n");
#endif
}

// Convert sampled shunt data to Ib engineering units
void Shunt::convert(const boolean disconnect, const boolean reset, Sensors *Sen)
{
  #ifdef HDWE_ADS1013_AMP_NOA
    if ( !bare_shunt_ && !dscn_cmd_ )
    {
      #ifndef HDWE_BARE
        vshunt_int_ = readADC_Differential_0_1(name_);
      #else
        vshunt_int_ = 0;
      #endif
      sample_time_z_ = sample_time_;
      sample_time_ = System.millis();
    }
    else
    {
      vshunt_int_0_ = 0; vshunt_int_1_ = 0; vshunt_int_ = 0;
    }
    vshunt_ = computeVolts(vshunt_int_);
  #else
    #ifndef HDWE_BARE
      bare_shunt_ = Vc_ < VC_BARE_DETECTED;
    #else
      bare_shunt_ = false;
    #endif
    if ( !bare_shunt_ && !dscn_cmd_ )
    {
      vshunt_ = Vo_Vc_;
      vshunt_int_0_ = 0; vshunt_int_1_ = 0; vshunt_int_ = 0;
    }
    else
    {
      vshunt_int_0_ = 0; vshunt_int_1_ = 0; vshunt_int_ = 0; vshunt_ = 0.;
      Vc_raw_ = 0; Vc_ = 0.; Vo_raw_ = 0; Vo_ = 0.;
      Ishunt_cal_ = 0.;
    }
  #endif
  if ( disconnect )
    Ishunt_cal_ = 0.;
  else
    Ishunt_cal_ = vshunt_*v2a_s_*(*sp_ib_scale_) + *sp_ib_bias_;

      // 2-pole filter
  Ishunt_cal_filt_ = Filt_->calculate(Ishunt_cal_, disconnect || reset, min(Sen->T, MAX_T_Q_FILT));
  if ( Ishunt_cal_filt_ < 0. ) Ishunt_cal_ *= sp.ib_disch_slr();

}

// Sample amplifier Vo-Vc
void Shunt::sample(const boolean reset_loc, const float T)
{
  sample_time_z_ = sample_time_;
  if ( using_opamp_ )
  {
    Vc_raw_ = analogRead(vr_pin_);
    Vc_ =  float(Vc_raw_)*VH3V3_CONV_GAIN + ap.vc_add;
  }
  else
  {
    Vc_raw_ = analogRead(vc_pin_);
    Vc_ =  float(Vc_raw_)*VC_CONV_GAIN + ap.vc_add;
  }
  sample_time_ = System.millis();
  Vo_raw_ = analogRead(vo_pin_);
  Vo_ =  float(Vo_raw_)*VO_CONV_GAIN;
  Vo_Vc_ = Vo_ - Vc_;
  #ifndef HDWE_PHOTON
    if  ( sp.debug()==14 )Serial.printf("ADCref %7.3f samp_t %lld vo_pin_%d V0_raw_%d Vo_%7.3f Vo_Vc_%7.3f Vc_%7.3f\n", (float)analogGetReference(), sample_time_, vo_pin_, Vo_raw_, Vo_, Vo_Vc_, Vc_);
  #endif
}


// Class Looparound
Looparound::Looparound(BatteryMonitor *Mon, Sensors *Sen, const float wrap_hi_amp, const float wrap_lo_amp, const double wrap_trim_gain,
    const float imax, const float imin, const float err_max):
  chem_(Mon->chem()), e_wrap_(0.), e_wrap_filt_(0.), e_wrap_trim_(0.), e_wrap_trimmed_(0.), hi_fail_(false), hi_fault_(false), ib_(0.),
  ib_past_(0), imax_(imax), imin_(imin), lo_fail_(false), lo_fault_(false), Mon_(Mon), reset_(false), Sen_(Sen), voc_(0.), wrap_hi_amp_(wrap_hi_amp), wrap_lo_amp_(wrap_lo_amp),
  wrap_trim_gain_(wrap_trim_gain)
{
  ChargeTransfer_ = new LagExp(EKF_NOM_DT, chem_->tau_ct, -NOM_UNIT_CAP, NOM_UNIT_CAP);     // actual update time provided run time
  Trim_ = new TustinIntegrator(EKF_NOM_DT, -err_max*10., err_max*10.);          // actual update time provided run time
  WrapErrFilt_ = new LagTustin(2., WRAP_ERR_FILT, -err_max, err_max);   // actual update time provided run time
  WrapHi_ = new TFDelay(false, WRAP_HI_S, WRAP_HI_R, EKF_NOM_DT);  // Wrap test persistence.  Initializes false
  WrapLo_ = new TFDelay(false, WRAP_LO_S, WRAP_LO_R, EKF_NOM_DT);  // Wrap test persistence.  Initializes false
}

// Update the loop
void Looparound::calculate(const boolean reset, const float ib, Sensors *Sen)
{
  reset_ = reset || Sen_->Flt->reset_all_faults();
  ib_ = ib;

  // Dynamic emf. vb_ is stale when running with model
  float ib_dyn;
  if (sp.mod_vb()) ib_dyn = ib_past_;
  else ib_dyn = ib_;
  float dv_dyn = ChargeTransfer_->calculate(ib_dyn, reset_, chem_->tau_ct, Sen_->T)*chem_->r_ct*ap.slr_res + ib_dyn*chem_->r_0*ap.slr_res;
  voc_ = Mon_->vb() - dv_dyn;
  e_wrap_ = Mon_->voc_soc() - voc_;

  // Trimmer using past values
  float trim_init = 0.;
  float trim_rate_lim = 0.;
  if ( wrap_trim_gain_ > 0. )
  {
    trim_init = -(Mon_->vb() - Mon_->voc_soc() - dv_dyn);
    trim_rate_lim = max(min(e_wrap_filt_*wrap_trim_gain_, MAX_TRIM_RATE), -MAX_TRIM_RATE);
    e_wrap_trim_ = -Trim_->calculate(trim_rate_lim, min(Sen_->T, F_MAX_T_WRAP), reset_, trim_init);
  }
  else
  {
    trim_init = 0.;
    trim_rate_lim = 0.;
    e_wrap_trim_ = 0.;
  }

  // e_wrap using present values
  e_wrap_trimmed_ = e_wrap_ + e_wrap_trim_;
  e_wrap_filt_ = WrapErrFilt_->calculate(e_wrap_trimmed_, reset_, min(Sen_->T, F_MAX_T_WRAP));

  // Thresholds. Scalars are calculated by Flt->wrap_scalars()
  ewhi_thr_ = Mon_->r_ss() * wrap_hi_amp_ * ap.ewhi_slr * Sen_->Flt->ewsat_slr() * Sen_->Flt->ewmin_slr();
  ewlo_thr_ = Mon_->r_ss() * wrap_lo_amp_ * ap.ewlo_slr * Sen_->Flt->ewsat_slr() * Sen_->Flt->ewmin_slr();

  // sat logic screens out voc jumps when ib>0 when saturated
  // wrap_hi and wrap_lo don't latch because need them available to check next ib sensor selection for dual ib sensor
  // wrap_vb latches because vb is single sensor  faultAssign( (e_wrap_filt_ >= ewhi_thr_ && !Mon->sat()), WRAP_HI_FLT);

  hi_fault_ = e_wrap_filt_ >= ewhi_thr_;
  hi_fail_ = WrapHi_->calculate(hi_fault_, WRAP_HI_S, WRAP_HI_R, Sen_->T, reset_) && !Sen_->Flt->vb_fa();  // not latched
  lo_fault_ = e_wrap_filt_ <= ewlo_thr_;
  lo_fail_ = WrapLo_->calculate(lo_fault_, WRAP_LO_S, WRAP_LO_R, Sen_->T, reset_) && !Sen_->Flt->vb_fa();  // not latched

  if ( sp.debug()==71 ) Serial.printf("ib%7.3f reset%d ewlo_thr/e_wrap_filt/ewhi_thr  %7.3f/%7.3f/%7.3f trim%7.3f vb_fa %d lo_fault/fail %d/%d hi_fault/fail %d/%d\n",
   ib_, reset_, ewlo_thr_, e_wrap_filt_, ewhi_thr_, e_wrap_trim_, Sen_->Flt->vb_fa(), lo_fault_, lo_fail_, hi_fault_, hi_fail_);
  ib_past_ = ib_;
}

void Looparound::pretty_print()
{
  Serial.printf(" reset %d\n", reset_);
  Serial.printf(" ib%7.3f A\n", ib_);
  Serial.printf(" voc%7.3f V\n", voc_);
  Serial.printf(" e_wrap%7.3f V\n", e_wrap_);
  Serial.printf(" e_wrap_f%7.3f V\n", e_wrap_filt_);
  Serial.printf(" e_wrap_trim%7.3f V\n", e_wrap_trim_);
  Serial.printf(" e_wrap_trimmed%7.3f V\n", e_wrap_trimmed_);
  Serial.printf(" wrap_trim_gain%7.3f r/s\n", wrap_trim_gain_);
  Serial.printf(" hi_fault/fail %d/%d\n", hi_fault_, hi_fail_);
  Serial.printf(" lo_fault/fail %d/%d\n", lo_fault_, lo_fail_);
  Serial.printf(" ewlo_thr/ewhi_thr%7.3f/%7.3f V\n", ewlo_thr_, ewhi_thr_);
}


// Class Fault
Fault::Fault(const double T, uint8_t *preserving, BatteryMonitor *Mon, Sensors *Sen):
  cc_diff_(0.), cc_diff_empty_slr_(1), disable_amp_fault_(false), ewmin_slr_(1), ewsat_slr_(1), e_wrap_(0), e_wrap_filt_(0),
  fltw_(0UL), falw_(0UL),
  ib_amp_hi_(false), ib_amp_invalid_(false), ib_amp_lo_(false), ib_choice_(UsingDef),
  ib_choice_last_(UsingDef), ib_decision_(0), ib_diff_(0), ib_diff_f_(0), ib_lo_active_(true),
  ib_noa_hi_(false), ib_noa_invalid_(false), ib_noa_lo_(false), ib_quiet_(0), ib_rate_(0),
  ib_sel_stat_(IB_SEL_STAT_DEF), ib_sel_stat_last_(IB_SEL_STAT_DEF), latched_fail_(false),
  latched_fail_fake_(false), reset_all_faults_(false), sp_preserving_(preserving), tb_sel_stat_(TB_SEL_STAT_DEF),
  tb_sel_stat_last_(TB_SEL_STAT_DEF), vb_sel_stat_(VB_SEL_STAT_DEF), vb_sel_stat_last_(VB_SEL_STAT_DEF)
{
  IbNoaRate = new RateLagExp(T, WRAP_ERR_FILT/4., -MAX_ERR_FILT, MAX_ERR_FILT);
  IbErrFilt = new LagTustin(T, TAU_ERR_FILT, -IBATT_DISAGREE_THRESH*1.5, IBATT_DISAGREE_THRESH*1.5);  // actual update time provided run time
  IbdPosPer = new TFDelay(false, IBATT_INST_DIFF_SET, IBATT_INST_DIFF_RESET, T);
  IbdNegPer = new TFDelay(false, IBATT_INST_DIFF_SET, IBATT_INST_DIFF_RESET, T);
  IbdHiPer = new TFDelay(false, IBATT_DISAGREE_SET, IBATT_DISAGREE_RESET, T);
  IbdLoPer = new TFDelay(false, IBATT_DISAGREE_SET, IBATT_DISAGREE_RESET, T);
  DisabAmpFltPer = new TFDelay(false, DISAB_LO_SET, DISAB_LO_RESET, T);
  CcdiffPer  = new TFDelay(false, CC_DIFF_SET, CC_DIFF_RESET, T);
  IbAmpHardFail  = new TFDelay(false, IB_HARD_SET, IB_HARD_RESET, T);
  IbLoActive  = new TFDelay(true, IB_LO_ACTIVE_SET, IB_LO_ACTIVE_RESET, T);
  IbNoAmpHardFail  = new TFDelay(false, IB_HARD_SET, IB_HARD_RESET, T);
  TbHardFail  = new TFDelay(false, TB_HARD_SET, TB_HARD_RESET, T);
  TbStaleFail  = new TFDelay(false, TB_STALE_SET, TB_STALE_RESET, T);
  VbHardFail  = new TFDelay(false, VB_HARD_SET, VB_HARD_RESET, T);
  VcHardFail  = new TFDelay(false, VC_HARD_SET, VC_HARD_RESET, T);
  QuietPer  = new TFDelay(false, QUIET_S, QUIET_R, T);
  WrapErrFilt = new LagTustin(T, WRAP_ERR_FILT, -MAX_WRAP_ERR_FILT, MAX_WRAP_ERR_FILT);  // actual update time provided run time
  WrapHi = new TFDelay(false, WRAP_HI_S, WRAP_HI_R, EKF_NOM_DT);  // Wrap test persistence.  Initializes false
  WrapLo = new TFDelay(false, WRAP_LO_S, WRAP_LO_R, EKF_NOM_DT);  // Wrap test persistence.  Initializes false
  QuietFilt = new General2_Pole(T, WN_Q_FILT, ZETA_Q_FILT, MIN_Q_FILT, MAX_Q_FILT);  // actual update time provided run time
  QuietRate = new RateLagExp(T, TAU_Q_FILT, MIN_Q_FILT, MAX_Q_FILT);
  LoopIbAmp = new Looparound(Mon, Sen, WRAP_HI_AMP, WRAP_LO_AMP, AMP_WRAP_TRIM_GAIN, IB_ABS_MAX_AMP, -IB_ABS_MAX_AMP,
                              MAX_WRAP_ERR_FILT/(IB_ABS_MAX_NOA/IB_ABS_MAX_AMP));
  LoopIbNoa = new Looparound(Mon, Sen, WRAP_HI_NOA, WRAP_LO_NOA, NOA_WRAP_TRIM_GAIN, IB_ABS_MAX_NOA, -IB_ABS_MAX_NOA,
                              MAX_WRAP_ERR_FILT);
}

// Coulomb Counter difference test - failure conditions track poorly
void Fault::cc_diff(const boolean reset, Sensors *Sen, BatteryMonitor *Mon)
{
  cc_diff_ = Mon->soc_ekf() - Mon->soc(); // These are filtered in their construction (EKF is a dynamic filter and 
                                          // Coulomb counter is wrapa big integrator)
  if ( Mon->soc() <= max(Mon->soc_min()+WRAP_SOC_LO_OFF_REL, WRAP_SOC_LO_OFF_ABS) )
  {
    cc_diff_empty_slr_ = CC_DIFF_LO_SOC_SLR;
  }
  else
  {
    cc_diff_empty_slr_ = 1.;
  }
  // ewsat_slr_ used here because voc_soc map inaccurate on cold days
  cc_diff_thr_ = CC_DIFF_SOC_DIS_THRESH*ap.cc_diff_slr*cc_diff_empty_slr_*ewsat_slr_;
  failAssign( CcdiffPer->calculate(abs(cc_diff_)>=cc_diff_thr_, CC_DIFF_SET, CC_DIFF_RESET, Sen->T, reset), CC_DIFF_FA ); // CC_DIFF_FA not latched
}

// Compare current sensors - failure conditions large difference
void Fault::ib_diff(const boolean reset, Sensors *Sen, BatteryMonitor *Mon)
{
  boolean reset_loc = reset || reset_all_faults_;
  if ( !ib_lo_active_ || disable_amp_fault_ ) ib_diff_ = 0.;
  ib_diff_f_ = IbErrFilt->calculate(ib_diff_, reset_loc || disable_amp_fault_ || !ib_lo_active_, min(Sen->T, MAX_ERR_T));
  ib_diff_thr_ = IBATT_DISAGREE_THRESH*ap.ib_diff_slr;
  faultAssign( IbdPosPer->calculate((ib_diff_f_>=ib_diff_thr_), IBATT_INST_DIFF_SET, IBATT_INST_DIFF_RESET, Sen->T, reset_loc) && 
      ib_lo_active_, IB_DIFF_HI_FLT );
  faultAssign( IbdNegPer->calculate((ib_diff_f_<=-ib_diff_thr_), IBATT_INST_DIFF_SET, IBATT_INST_DIFF_RESET, Sen->T, reset_loc) &&
      ib_lo_active_, IB_DIFF_LO_FLT );
  failAssign( IbdHiPer->calculate(ib_diff_hi_flt(), IBATT_DISAGREE_SET, IBATT_DISAGREE_RESET, Sen->T, reset_loc),
      IB_DIFF_HI_FA ); // IB_DIFF_FA not latched
  failAssign( IbdLoPer->calculate(ib_diff_lo_flt(), IBATT_DISAGREE_SET, IBATT_DISAGREE_RESET, Sen->T, reset_loc),
     IB_DIFF_LO_FA ); // IB_DIFF_FA not latched

  // if ( sp.debug()==2 || sp.debug()==4 ) Serial.printf("ib_diff_%7.3f reset_loc %d disable_amp_fault_ %d ib_diff_f_ %7.3f ib_diff_thr_ %7.3f ib_lo_active_ %d\n",
  //    ib_diff_, reset_loc, disable_amp_fault_, ib_diff_f_, ib_diff_thr_, ib_lo_active_);
}

// Compare current sensors - failure conditions large difference
void Fault::ib_logic(const boolean reset, Sensors *Sen, BatteryMonitor *Mon)
{
  boolean reset_loc = reset || reset_all_faults_;

  // Difference error, filter, check, persist, doesn't latch
  if ( sp.mod_ib() )
  {
    ib_diff_ = Sen->ib_amp_model() - Sen->ib_noa_model();
    #ifdef HDWE_IB_HI_LO
      ib_amp_hi_ = Sen->ib_amp_model() >= HDWE_IB_HI_LO_AMP_HI / sp.nP();
      ib_amp_lo_ = Sen->ib_amp_model() <= HDWE_IB_HI_LO_AMP_LO / sp.nP();
      ib_noa_hi_ = Sen->ib_noa_model() >= HDWE_IB_HI_LO_AMP_HI / sp.nP();
      ib_noa_lo_ = Sen->ib_noa_model() <= HDWE_IB_HI_LO_AMP_LO / sp.nP();
      ib_lo_active_ = IbLoActive->calculate(HDWE_IB_HI_LO_AMP_LO / sp.nP() < Sen->Ib_noa_model &&
                                            Sen->Ib_noa_model < HDWE_IB_HI_LO_AMP_HI / sp.nP(),
                                            IB_LO_ACTIVE_SET, IB_LO_ACTIVE_RESET, Sen->T , reset_loc);
    #else
      ib_amp_hi_ = false;
      ib_amp_lo_ = false;
      ib_noa_hi_ = false;
      ib_noa_lo_ = false;
      ib_lo_active_ = false;
    #endif
  }
  else
  {
    ib_diff_ = Sen->ib_amp_hdwe() - Sen->ib_noa_hdwe();
    #ifdef HDWE_IB_HI_LO
      ib_amp_hi_ = Sen->ib_amp_hdwe() >= HDWE_IB_HI_LO_AMP_HI / sp.nP();
      ib_amp_lo_ = Sen->ib_amp_hdwe() <= HDWE_IB_HI_LO_AMP_LO / sp.nP();
      ib_noa_hi_ = Sen->ib_noa_hdwe() >= HDWE_IB_HI_LO_AMP_HI / sp.nP();
      ib_noa_lo_ = Sen->ib_noa_hdwe() <= HDWE_IB_HI_LO_AMP_LO / sp.nP();
      ib_lo_active_ = IbLoActive->calculate(HDWE_IB_HI_LO_AMP_LO / sp.nP() < Sen->Ib_noa_hdwe &&
                                            Sen->Ib_noa_hdwe < HDWE_IB_HI_LO_AMP_HI / sp.nP(),
                                            IB_LO_ACTIVE_SET, IB_LO_ACTIVE_RESET, Sen->T , reset_loc);
    #else
      ib_amp_hi_ = false;
      ib_amp_lo_ = false;
      ib_noa_hi_ = false;
      ib_noa_lo_ = false;
      ib_lo_active_ = false;
    #endif
  }
  disable_amp_fault_ = DisabAmpFltPer->calculate( (ib_amp_hi_ && ib_noa_hi_) || (ib_amp_lo_ && ib_noa_lo_), DISAB_LO_SET, DISAB_LO_RESET, Sen->T, reset);

}

// Detect no signal present based on detection of quiet signal.
// Research by sound industry found that 2-pole filtering is the sweet spot between seeing noise
// and actual motion without 'guilding the lily'
void Fault::ib_quiet(const boolean reset, Sensors *Sen)
{
  boolean reset_loc = reset | reset_all_faults_;

  // Rate (has some filtering)
  ib_rate_ = QuietRate->calculate(Sen->Ib_amp_hdwe + Sen->Ib_noa_hdwe, reset, min(Sen->T, MAX_T_Q_FILT));

  // 2-pole filter
  ib_quiet_ = QuietFilt->calculate(ib_rate_, reset_loc, min(Sen->T, MAX_T_Q_FILT));

  // Fault
  ib_quiet_thr_ = QUIET_A * ap.ib_quiet_slr;
  faultAssign( !sp.mod_ib() && abs(ib_quiet_)<=ib_quiet_thr_ && !reset_loc, IB_DSCN_FLT );   // initializes false
  failAssign( QuietPer->calculate(dscn_flt(), QUIET_S, QUIET_R, Sen->T, reset_loc), IB_DSCN_FA);
  #ifndef HDWE_PHOTON
    if ( sp.debug()==-13 ) debug_m13(Sen);
    if ( sp.debug()==-23 ) debug_m23(Sen);
    if ( sp.debug()==-24 ) debug_m24(Sen);
  #endif
}

// Range checks latch
void Fault::ib_range(const boolean reset, Sensors *Sen, BatteryMonitor *Mon)
{
  boolean reset_loc = reset | reset_all_faults_;
  if ( reset_loc )
  {
    failAssign(false, IB_AMP_FA);
    failAssign(false, IB_NOA_FA);
  }
  faultAssign( Sen->ShuntAmp->bare_shunt(), IB_AMP_BARE);
  faultAssign( Sen->ShuntNoAmp->bare_shunt(), IB_NOA_BARE);

  // Range checks latch
  if ( sp.mod_ib() )
  {
    faultAssign( ( abs(Sen->ib_amp_model()) >= ap.ib_amp_max ) && !ap.disab_ib_fa && !sp.tweak_test(), IB_AMP_FLT );
    faultAssign( ( abs(Sen->ib_noa_model()) >= ap.ib_noa_max ) && !ap.disab_ib_fa && !sp.tweak_test(), IB_NOA_FLT );
  }
  else
  {
    #ifndef HDWE_BARE
      faultAssign( ( ib_amp_bare() || abs(Sen->ib_amp_hdwe()) >= ap.ib_amp_max ) && !ap.disab_ib_fa && !sp.tweak_test(), IB_AMP_FLT );
      faultAssign( ( ib_noa_bare() || abs(Sen->ib_noa_hdwe()) >= ap.ib_noa_max ) && !ap.disab_ib_fa && !sp.tweak_test(), IB_NOA_FLT );
    #else
      float current_max = NOM_UNIT_CAP * sp.nP();
      faultAssign( abs(Sen->ShuntAmp->Ishunt_cal()) >= current_max && !ap.disab_ib_fa && !sp.tweak_test(), IB_AMP_FLT );
      faultAssign( abs(Sen->ShuntNoAmp->Ishunt_cal()) >= current_max && !ap.disab_ib_fa && !sp.tweak_test(), IB_NOA_FLT );
    #endif
  }

  // Fail persistence
  if ( ap.disab_ib_fa )
  {
    failAssign( false, IB_AMP_FA );
    failAssign( false, IB_NOA_FA);
  }
  else
  {
    failAssign( vc_fa() || ib_amp_bare() || ib_amp_fa() || IbAmpHardFail->calculate(ib_amp_flt(), IB_HARD_SET, IB_HARD_RESET, Sen->T, reset_loc), IB_AMP_FA );
    failAssign( vc_fa() || ib_noa_bare() || ib_noa_fa() || IbNoAmpHardFail->calculate(ib_noa_flt(), IB_HARD_SET, IB_HARD_RESET, Sen->T, reset_loc), IB_NOA_FA);
  }
  #ifdef DEBUG_DETAIL
    if ( sp.mod_ib() )
    {
      if ( sp.debug()==62 ) Serial.printf("ibnoamod%7.3f ibampmod%7.3f ib_lo_active %d\n", Sen->Ib_noa_model, Sen->Ib_amp_model, ib_lo_active_);
      if ( sp.debug()==62 ) Serial.printf("ibmm %7.3f mx %7.3f ibnm %7.3f nx %7.3f IB_AMP_FLT %d IB_NOA_FLT %d\n", Sen->ib_amp_model(), ap.ib_amp_max, Sen->ib_noa_model(), ap.ib_noa_max, ib_amp_flt(), ib_noa_flt());
    }
    else
    {
      if ( sp.debug()==62 ) Serial.printf("ibnoahdwe%7.3f ibamphdwe%7.3f ib_lo_active %d\n", Sen->Ib_noa_hdwe, Sen->Ib_amp_hdwe, ib_lo_active_);
      if ( sp.debug()==62 ) Serial.printf("ib_amp_bare=%d ib_noa_bare=%d ibm%7.3f mx%7.3f ibn%7.3f nx%7.3f IB_AMP_FLT=%d IB_NOA_FLT%d ib_lo_active%d\n", ib_amp_bare(), ib_noa_bare(), Sen->ib_amp_hdwe(), ap.ib_amp_max, Sen->ib_noa_hdwe(), ap.ib_noa_max, ib_amp_flt(), ib_noa_flt(), ib_lo_active_);
    }
  #endif
}

// Voltage wraparound logic for current selection
// Avoid using hysteresis data for this test and accept more generous thresholds
void Fault::ib_wrap(const boolean reset, Sensors *Sen, BatteryMonitor *Mon)
{
  boolean reset_loc = reset | reset_all_faults_;
  if ( reset_loc )
  {
    failAssign(false, WRAP_VB_FA);
  }

  // Thresholds
  wrap_scalars(Mon);

  // HI_LO-Only Logic
  #ifdef HDWE_IB_HI_LO
    LoopIbNoa->calculate(reset_loc, Sen->ib_noa(), Sen);
    boolean ib_amp_reset = reset_loc || disable_amp_fault_;
    LoopIbAmp->calculate(ib_amp_reset, Sen->ib_amp(), Sen);
    faultAssign( LoopIbAmp->hi_fault(), WRAP_HI_M_FLT);
    failAssign( LoopIbAmp->hi_fail(), WRAP_HI_M_FA);  // WRAP_HI_M_FA not latched
    faultAssign( LoopIbAmp->lo_fault(), WRAP_LO_M_FLT);
    failAssign( LoopIbAmp->lo_fail(), WRAP_LO_M_FA);  // WRAP_LO_M_FA not latched
    faultAssign( LoopIbNoa->hi_fault(), WRAP_HI_N_FLT);
    failAssign( LoopIbNoa->hi_fail(), WRAP_HI_N_FA);  // WRAP_HI_N_FA not latched
    faultAssign( LoopIbNoa->lo_fault(), WRAP_LO_N_FLT);
    failAssign( LoopIbNoa->lo_fail(), WRAP_LO_N_FA);  // WRAP_LO_N_FA not latched
  #endif

  // Overall wrap logic (separates amp/noa and hi/lo)
  #ifdef HDWE_IB_HI_LO
    e_wrap_ = scale_select(Sen->Ib_noa_hdwe, Sen->sel_brk_hdwe, LoopIbAmp->e_wrap(), LoopIbNoa->e_wrap());
    e_wrap_filt_ = scale_select(Sen->Ib_noa_hdwe, Sen->sel_brk_hdwe, LoopIbAmp->e_wrap_filt(), LoopIbNoa->e_wrap_filt());
    faultAssign( ( wrap_hi_m_flt() && wrap_hi_n_flt() && !Mon->sat() ), WRAP_HI_FLT);
    faultAssign( ( wrap_lo_m_flt() && wrap_lo_n_flt() ), WRAP_LO_FLT);
    failAssign( ( wrap_hi_m_fa() && wrap_hi_n_fa() && !Mon->sat() ), WRAP_HI_FA);
    failAssign( ( wrap_lo_m_fa() && wrap_lo_n_fa() ), WRAP_LO_FA);
  #else
    e_wrap_ = Mon->voc_soc() - Mon->voc_stat();
    e_wrap_filt_ = WrapErrFilt->calculate(e_wrap_, reset_loc, min(Sen->T, F_MAX_T_WRAP));
    // sat logic screens out voc jumps when ib>0 when saturated
    // wrap_hi and wrap_lo don't latch because need them available to check next ib sensor selection for dual ib sensor
    // wrap_vb latches because vb is single sensor
    // Thresholds calculated by wrap_scalars()
    faultAssign( (e_wrap_filt_ >= ewhi_thr_ && !Mon->sat()), WRAP_HI_FLT);
    faultAssign( (e_wrap_filt_ <= ewlo_thr_), WRAP_LO_FLT);
    failAssign( (WrapHi->calculate(wrap_hi_flt(), WRAP_HI_S, WRAP_HI_R, Sen->T, reset_loc) && !vb_fa()), WRAP_HI_FA );  // not latched
    failAssign( (WrapLo->calculate(wrap_lo_flt(), WRAP_LO_S, WRAP_LO_R, Sen->T, reset_loc) && !vb_fa()), WRAP_LO_FA );  // not latched
  #endif
  failAssign( (wrap_vb_fa() && !reset_loc) || (!ib_diff_fa() && wrap_m_and_n_fa()), WRAP_VB_FA);    // WRAP_VB_FA latches latches because vb is single sensor
}

void Fault::pretty_print(Sensors *Sen, BatteryMonitor *Mon)
{
  Serial.printf("\nLooparound Amp:\n");
  LoopIbAmp->pretty_print();
  Serial.printf("\nLooparound Noa:\n");
  LoopIbNoa->pretty_print();

  Serial.printf("\nFault:\n");
  Serial.printf(" cc_diff%9.6f  thr%9.6f Fc^\n", cc_diff_, cc_diff_thr_);
  Serial.printf(" ib_lo_active %d\n", ib_lo_active_);
  Serial.printf(" ib_diff%7.3f thr%7.3f Fd^\n", ib_diff_f_, ib_diff_thr_);
  Serial.printf(" e_wrap_filt%7.3f thr%7.3f Fo^%7.3f Fi^\n", e_wrap_filt_, ewlo_thr_, ewhi_thr_);
  Serial.printf(" ib_quiet%7.3f thr%7.3f Fq v\n", ib_quiet_, ib_quiet_thr_);
  Serial.printf(" sel_brk_hdwe:     ");
  Sen->sel_brk_hdwe->pretty_print();
  Serial.printf("\n");

  Serial.printf(" soc%7.3f soc_inf%7.3f voc%7.3f  voc_soc%7.3f\n", Mon->soc(), Mon->soc_inf(), Mon->voc(), Mon->voc_soc());
  Serial.printf(" dis_tb_fa %d  dis_vb_fa %d  dis_ib_fa %d\n", ap.disab_tb_fa, ap.disab_vb_fa, ap.disab_ib_fa);
  Serial.printf(" bms_off  %d\n\n", Mon->bms_off());

  Serial.printf(" Tbh%7.3f Tbm=%7.3f sel%7.3f\n", Sen->Tb_hdwe, Sen->Tb_model, Sen->Tb);
  Serial.printf(" Vbh%7.3f Vbm %7.3f sel%7.3f\n", Sen->Vb_hdwe, Sen->Vb_model, Sen->Vb);
  Serial.printf(" V3v3%7.3f\n", Sen->ShuntAmp->Vc()*2.);
  Serial.printf(" Imh%7.3f Imm %7.3f Ib%7.3f\n", Sen->Ib_amp_hdwe, Sen->Ib_amp_model, Sen->Ib);
  Serial.printf(" Inh%7.3f Inm %7.3f Ib%7.3f\n", Sen->Ib_noa_hdwe, Sen->Ib_noa_model, Sen->Ib);
  Serial.printf(" Ibh%7.3f Ibh %7.3f Ib%7.3f\n\n", Sen->Ib_hdwe, Sen->Ib_hdwe_model, Sen->Ib);

  Serial.printf(" mod_tb %d mod_vb %d mod_ib  %d\n", sp.mod_tb(), sp.mod_vb(), sp.mod_ib());
  Serial.printf(" mod_tb_dscn %d mod_vb_dscn %d mod_ib_amp_dscn %d mod_ib_noa_dscn %d\n", sp.mod_tb_dscn(), sp.mod_vb_dscn(), sp.mod_ib_amp_dscn(), sp.mod_ib_noa_dscn());
  #ifdef HDWE_IB_HI_LO
    Serial.printf(" tb_s_st %d  vb_s_st %d  ib_choice %d ib_decision_ %d ib_s_st %d\n", tb_sel_stat_, vb_sel_stat_, ib_choice_, ib_decision_, ib_sel_stat_);
  #else
    Serial.printf(" tb_s_st %d  vb_s_st %d  ib_s_st %d ib_decision_ %d\n", tb_sel_stat_, vb_sel_stat_, ib_sel_stat_, ib_decision_);
  #endif
  Serial.printf(" fake_faults %d latched_fail %d latched_fail_fake %d preserving %d\n\n", ap.fake_faults, latched_fail_, latched_fail_fake_, *sp_preserving_);
  Serial.printf(" wrap_hi_or_lo-fa %d wrap_hi_and_lo_fa %d\n\n", wrap_hi_or_lo_fa(), wrap_hi_and_lo_fa());

  #ifdef HDWE_IB_HI_LO
    Serial.printf("HDWE_IB_HI_LO Decisions\n");
    Serial1.printf("HDWE_IB_HI_LO Decisions\n");
  #else
    Serial.printf("Active/Standby Decisions\n");
    Serial1.printf("Active/Standby Decisions\n");
  #endif
  Serial.printf(" wml     %d  %d 'Fo ^'\n", wrap_lo_m_flt(), wrap_lo_m_fa());
  Serial.printf(" wmh     %d  %d 'Fi ^'\n", wrap_hi_m_flt(), wrap_hi_m_fa());
  Serial.printf(" wnl     %d  %d 'Fo ^'\n", wrap_lo_n_flt(), wrap_lo_n_fa());
  Serial.printf(" wnh     %d  %d 'Fi ^'\n", wrap_hi_n_flt(), wrap_hi_n_fa());
  Serial.printf(" vc      %d  %d 'FI 1'\n", vc_flt(), vc_fa());
  Serial.printf(" bare n  %d  x \n", ib_noa_bare());
  Serial.printf(" bare m  %d  x \n", ib_amp_bare());
  Serial.printf(" ib_dsc  %d  %d 'Fq v'\n", ib_dscn_flt(), ib_dscn_fa());
  Serial.printf(" ibd_lo  %d  %d 'Fd ^  *SA/*SB'\n", ib_diff_lo_flt(), ib_diff_lo_fa());
  Serial.printf(" ibd_hi  %d  %d 'Fd ^  *SA/*SB'\n", ib_diff_hi_flt(), ib_diff_hi_fa());
  Serial.printf(" red wv  %d  %d   'Fd, Fi/Fo ^'\n",  red_loss(), wrap_vb_fa());
  Serial.printf(" wl      %d  %d 'Fo ^'\n", wrap_lo_flt(), wrap_lo_fa());
  Serial.printf(" wh      %d  %d 'Fi ^'\n", wrap_hi_flt(), wrap_hi_fa());
  Serial.printf(" vc | cc_dif %d  %d 'x Fc ^'\n", vc_fa(), cc_diff_fa());
  Serial.printf(" ib n    %d  %d 'FI 1'\n", ib_noa_flt(), ib_noa_fa());
  Serial.printf(" ib m    %d  %d 'FI 1'\n", ib_amp_flt(), ib_amp_fa());
  Serial.printf(" vb      %d  %d 'Fv 1  *SV, *Dc/*Dv'\n", vb_flt(), vb_fa());
  Serial.printf(" tb      %d  %d 'Ft 1'\n  ", tb_flt(), tb_fa());
  bitMapPrint(pr.buff, fltw_, NUM_FLT);
  Serial.print(pr.buff);
  Serial.printf("   ");
  bitMapPrint(pr.buff, falw_, NUM_FA);
  Serial.printf("%s\n", pr.buff);
  Serial.printf("  10FEDCBA9876543210   10FExxBA9876543210\n");
  Serial.printf("  fltw=%ld     falw=%ld\n", fltw_, falw_);
  if ( ap.fake_faults )
    Serial.printf("fake_faults=>redl\n");
}
void Fault::pretty_print1(Sensors *Sen, BatteryMonitor *Mon)
{
  Serial1.printf("Fault:\n");
  Serial1.printf(" cc_diff  %9.6f  thr=%9.6f Fc^\n", cc_diff_, cc_diff_thr_);
  Serial1.printf(" ib_diff  %7.3f  thr=%7.3f Fd^\n", ib_diff_f_, ib_diff_thr_);
  Serial1.printf(" e_wrap   %7.3f  thr=%7.3f Fo^%7.3f Fi^\n", e_wrap_filt_, ewlo_thr_, ewhi_thr_);
  Serial1.printf(" ib_quiet %7.3f  thr=%7.3f Fq v\n\n", ib_quiet_, ib_quiet_thr_);

  Serial1.printf(" soc  %7.3f  soc_inf %7.3f voc %7.3f  voc_soc %7.3f\n", Mon->soc(), Mon->soc_inf(), Mon->voc(), Mon->voc_soc());
  Serial1.printf(" dis_tb_fa %d  dis_vb_fa %d  dis_ib_fa %d\n", ap.disab_tb_fa, ap.disab_vb_fa, ap.disab_ib_fa);
  Serial1.printf(" bms_off   %d\n\n", Mon->bms_off());

  Serial1.printf(" Tbh=%7.3f  Tbm=%7.3f\n", Sen->Tb_hdwe, Sen->Tb_model);
  Serial1.printf(" Vbh %7.3f  Vbm %7.3f\n", Sen->Vb_hdwe, Sen->Vb_model);
  Serial1.printf(" V3v3 %7.3f \n", Sen->ShuntAmp->Vc()*2.);
  Serial1.printf(" Imh %7.3f  Imm %7.3f\n", Sen->Ib_amp_hdwe, Sen->Ib_amp_model);
  Serial1.printf(" Inh %7.3f  Inm %7.3f\n", Sen->Ib_noa_hdwe, Sen->Ib_noa_model);
  Serial1.printf(" Ibh %7.3f  Ibm %7.3f Ib %7.3f\n\n", Sen->Ib_hdwe, Sen->Ib_hdwe_model, Sen->Ib);

  Serial1.printf(" mod_tb  %d  mod_vb  %d  mod_ib  %d\n", sp.mod_tb(), sp.mod_vb(), sp.mod_ib());
  #ifdef HDWE_IB_HI_LO
    Serial1.printf(" tb_s_st %d  vb_s_st %d  ib_choice %d ib_decision %d\n", tb_sel_stat_, vb_sel_stat_, ib_choice_, ib_decision_);
  #else
    Serial1.printf(" tb_s_st %d  vb_s_st %d  ib_s_st %d ib_decision %d\n", tb_sel_stat_, vb_sel_stat_, ib_sel_stat_, ib_decision_);
  #endif
  Serial1.printf(" fake_faults %d latched_fail %d latched_fail_fake %d preserving %d\n\n", ap.fake_faults, latched_fail_, latched_fail_fake_, *sp_preserving_);

  Serial1.printf(" wml     %d  %d 'Fo ^'\n", wrap_lo_m_flt(), wrap_lo_m_fa());
  Serial1.printf(" wmh     %d  %d 'Fi ^'\n", wrap_hi_m_flt(), wrap_hi_m_fa());
  Serial1.printf(" wnl     %d  %d 'Fo ^'\n", wrap_lo_n_flt(), wrap_lo_n_fa());
  Serial1.printf(" wnh     %d  %d 'Fi ^'\n", wrap_hi_n_flt(), wrap_hi_n_fa());
  Serial1.printf(" vc      %d  %d 'FI 1'\n", vc_flt(), vc_fa());
  Serial1.printf(" bare n  %d  x \n", Sen->ShuntNoAmp->bare_shunt());
  Serial1.printf(" bare m  %d  x \n", Sen->ShuntAmp->bare_shunt());
  Serial1.printf(" ib_dsc  %d  %d 'Fq v'\n", ib_dscn_flt(), ib_dscn_fa());
  Serial1.printf(" ibd_lo  %d  %d 'Fd ^  *SA/*SB'\n", ib_diff_lo_flt(), ib_diff_lo_fa());
  Serial1.printf(" ibd_hi  %d  %d 'Fd ^  *SA/*SB'\n", ib_diff_hi_flt(), ib_diff_hi_fa());
  Serial1.printf(" red wv  %d  %d   'Fd  Fi/Fo ^'\n",  red_loss(), wrap_vb_fa());
  Serial1.printf(" wl      %d  %d 'Fo ^'\n", wrap_lo_flt(), wrap_lo_fa());
  Serial1.printf(" wh      %d  %d 'Fi ^'\n", wrap_hi_flt(), wrap_hi_fa());
  Serial1.printf(" cc_dif      %d 'Fc ^'\n", cc_diff_fa());
  Serial1.printf(" ibm     %d  %d 'FI 1'\n", ib_amp_flt(), ib_amp_fa());
  Serial1.printf(" ibn     %d  %d 'FI 1'\n", ib_noa_flt(), ib_noa_fa());
  Serial1.printf(" vb      %d  %d 'Fv 1, *SV, *Dc/*Dv'\n", vb_flt(), vb_fa());
  Serial1.printf(" tb      %d  %d 'Ft 1'\n  ", tb_flt(), tb_fa());
  bitMapPrint(pr.buff, fltw_, NUM_FLT);
  Serial1.print(pr.buff);
  Serial1.printf("   ");
  bitMapPrint(pr.buff, falw_, NUM_FA);
  Serial1.printf("%s\n", pr.buff);
  Serial1.printf("  10FEDCBA9876543210   10FExxBA9876543210\n");
  Serial1.printf("  fltw=%ld     falw=%ld\n", fltw_, falw_);
  if ( ap.fake_faults )
    Serial1.printf("fake_faults=>redl\n");
  Serial1.printf("vv0; to return\n");
}

// Calculate selection for ib_decision_
// Use model instead of sensors when running tests as user
// Equivalent to using voc(soc) as voter between two hardware currrents
// Over-ride sensed Ib, Vb and Tb with model when running tests
// Inputs:  Sen->Ib_model, Sen->Ib_hdwe,
//          Sen->Vb_model, Sen->Vb_hdwe,
//          ----------------, Sen->Tb_hdwe, Sen->Tb_hdwe_filt
// Outputs: Ib,
//          Vb,

//          Tb, Tb_filt
//          latched_fail_
void Fault::select_all_logic(Sensors *Sen, BatteryMonitor *Mon, const boolean reset)
{
  // Reset
  if ( reset_all_faults_ )
  {
    reset_all_faults_select();
    Serial.printf("reset ib flt\n");
    Serial.printf("reset vb flt\n");
  }

  // Ib decision tables
  #ifdef HDWE_IB_HI_LO
    ib_decision_hi_lo(Sen);
    if ( ap.fake_faults )
    {
      latched_fail_fake_ = latched_fail_;
      latched_fail_ = false;
      ib_choice_ = ibSel(sp.ib_force());
    }
  #else
    ib_decision_active_standby(Sen);
    if ( ap.fake_faults )
    {
      latched_fail_fake_ = latched_fail_;
      latched_fail_ = false;
      ib_sel_stat_ = sp.ib_force();
    }
  #endif

  // vb failure from wrap result
  if ( !ap.fake_faults )
  {
    if ( !vb_sel_stat_last_ && !sp.mod_vb() )
    {
      vb_sel_stat_ = 0;   // Latches
      latched_fail_ = true;
    }
    if (  wrap_vb_fa() || vb_fa() )
    {
      vb_sel_stat_ = 0; // Latches
      latched_fail_ = true;
    }
  }
  else  // fake_faults
  {
    if ( !vb_sel_stat_last_ )
    {
      latched_fail_fake_ = true;
    }
    if (  wrap_vb_fa() || vb_fa() )
    {
      latched_fail_fake_ = true;
    }
  }

  // tb failure from inactivity. Does not latch because can heal and failure not critical
  if ( reset_all_faults_ )
  {
    tb_sel_stat_last_ = 1;
    tb_sel_stat_ = 1;
    Serial.printf("reset tb flts\n");
    failAssign(false, TB_FA);
  }
  if ( tb_fa() )  // Latches
  {
    tb_sel_stat_ = 0;
    latched_fail_ = true;
  }
  else
    tb_sel_stat_ = 1;

  // Print
  #ifdef HDWE_IB_HI_LO
    if ( ib_choice_ != ib_choice_last_ || vb_sel_stat_ != vb_sel_stat_last_ || tb_sel_stat_ != tb_sel_stat_last_ )
    {
      Serial.printf("Sel chg:  Amp->bare %d NoAmp->bare %d ib_diff_fa %d wh_fa %d wl_fa %d wv_fa %d cc_diff_fa_ %d\n sp.ib_force() %d ib_choice %d vb_sel_stat %d tb_sel_stat %d vb_fail %d Tb_fail %d\n",
        Sen->ShuntAmp->bare_shunt(), Sen->ShuntNoAmp->bare_shunt(), ib_diff_fa(), wrap_hi_fa(), wrap_lo_fa(), wrap_vb_fa(), cc_diff_fa(), sp.ib_force(), ib_choice_, vb_sel_stat_, tb_sel_stat_, vb_fa(), tb_fa());
      Serial.printf("  fake %d ibchc %d ibchcl %d ib_dec %d vbss %d vbssl %d tbss %d  tbssl %d latched_fail %d latched_fail_fake %d\n",
        ap.fake_faults, ib_choice_, ib_choice_last_, ib_decision_, vb_sel_stat_, vb_sel_stat_last_, tb_sel_stat_, tb_sel_stat_last_, latched_fail_, latched_fail_fake_);
      Serial.printf("  preserving %d\n", *sp_preserving_);
    }
  #else
    if ( ib_sel_stat_ != ib_sel_stat_last_ || vb_sel_stat_ != vb_sel_stat_last_ || tb_sel_stat_ != tb_sel_stat_last_ )
    {
      Serial.printf("Sel chg:  Amp->bare %d NoAmp->bare %d ib_diff_fa %d wh_fa %d wl_fa %d wv_fa %d cc_diff_fa_ %d\n sp.ib_force() %d ib_sel_stat %d vb_sel_stat %d tb_sel_stat %d vb_fail %d Tb_fail %d\n",
        Sen->ShuntAmp->bare_shunt(), Sen->ShuntNoAmp->bare_shunt(), ib_diff_fa(), wrap_hi_fa(), wrap_lo_fa(), wrap_vb_fa(), cc_diff_fa(), sp.ib_force(), ib_sel_stat_, vb_sel_stat_, tb_sel_stat_, vb_fa(), tb_fa());
      Serial.printf("  fake %d ibss %d ibssl %d vbss %d vbssl %d tbss %d  tbssl %d latched_fail %d latched_fail_fake %d\n",
        ap.fake_faults, ib_sel_stat_, ib_sel_stat_last_, vb_sel_stat_, vb_sel_stat_last_, tb_sel_stat_, tb_sel_stat_last_, latched_fail_, latched_fail_fake_);
      Serial.printf("  preserving %d\n", *sp_preserving_);
    }
    if ( ib_sel_stat_ != ib_sel_stat_last_ )
    {
      Serial.printf("Small reset\n");
      cp.cmd_reset();   
    }
  #endif

  // Latch memory
  ib_choice_last_ = ib_choice_;
  ib_sel_stat_last_ = ib_sel_stat_;
  vb_sel_stat_last_ = vb_sel_stat_;
  tb_sel_stat_last_ = tb_sel_stat_;

  // Make sure Rf command gets executed at least once all fault logic.  Asynchronous hence counter
  static uint8_t count = 0;
  if ( reset_all_faults_ )
  {
    if ( ( falw_==0 && fltw_==0 ) || count>1 )
    {
      reset_all_faults_ = false;
      latched_fail_ = false;
      latched_fail_fake_ = false;
      preserving(false);
      count = 0;
    }
    else
    {
      count++;
      Serial.printf("Rf%d\n", count);
    }
  }
}

// Select ib decision table active-standby
void Fault::ib_decision_active_standby(Sensors *Sen)
{
  if ( ap.fake_faults )
  {
    ib_sel_stat_ = IB_SEL_STAT_DEF;
    latched_fail_ = false;
    ib_decision_ = 10;
  }
  else if ( latched_fail_ )
    // ib_decision_ = 0;
    {}
  else if ( Sen->Flt->ib_amp_fa() && Sen->Flt->ib_noa_fa() )  // these separate inputs don't latch
  {
    ib_decision_ = 1;
    ib_sel_stat_ = 0;    // takes two not latched inputs to set and latch
    latched_fail_ = true;
  }
  else if ( sp.ib_force()>0 && !Sen->Flt->ib_amp_fa() )
  {
    ib_decision_ = 2;
    ib_sel_stat_ = 1;
    latched_fail_ = true;
  }
  else if ( ib_sel_stat_last_==-1 && !Sen->Flt->ib_noa_fa() && !reset_all_faults_ )  // latches
  {
    ib_decision_ = 3;
    ib_sel_stat_ = -1;
    latched_fail_ = true;
  }
  else if ( sp.ib_force()<0 && !Sen->Flt->ib_noa_fa() && !reset_all_faults_)  // latches
  {
    ib_decision_ = 4;
    ib_sel_stat_ = -1;
    latched_fail_ = true;
  }
  else if ( sp.ib_force()==0 )  // auto
  {
    if ( Sen->Flt->ib_amp_fa() && !Sen->Flt->ib_noa_fa() )  // these inputs don't latch
    {
      ib_decision_ = 5;
      ib_sel_stat_ = -1;
      latched_fail_ = true;
    }
    else if ( ib_diff_fa() )  // this input doesn't latch
    {
      if ( vb_sel_stat_ && wrap_hi_or_lo_fa() )    // wrap_hi_or_lo_fa is not latched
      {
        ib_decision_ = 6;
        ib_sel_stat_ = -1;      // two not latched fails but result of 'and' with ib_diff_fa latches latched_fail
        latched_fail_ = true;
      }
      else if ( cc_diff_fa() )  // this input doesn't latch but result of 'and' with ib_diff_fa latches latched_fail
      {
        ib_decision_ = 7;
        ib_sel_stat_ = -1;      // takes two not latched inputs to isolate ib failure and to set and latch ib_sel
        latched_fail_ = true;
      }
    }
  }
  else if ( ( (sp.ib_force() <  0) && ib_sel_stat_last_>-1 ) ||
            ( (sp.ib_force() >= 0) && ib_sel_stat_last_< 1 )   )  // Latches.  Must reset to move out of no amp selection.  ==0 not reachable
  {
    ib_decision_ = 8;
    latched_fail_ = true;
  }
  else
  {
    latched_fail_ = false;
  }
  faultAssign(ib_sel_stat_!=1 || sp.ib_force()!=0  || ib_diff_fa() || ib_amp_fa() || ib_noa_fa() || vb_fail(), RED_LOSS); // for active-standby, redundancy loss anytime ib_sel_stat<0

  #ifdef DEBUG_DETAIL
    if ( sp.debug()==62 ) Serial.printf("fake_faults %d ib_force %d reset %d ib_sel_stat_last %d ib_amp_fa %d ib_noa_fa %d ib_diff_fa %d vb_sel_stat_last %d wrap_m_fa %d wrap_n_fa %d  cc_diff_fa %d latched_fail_ %d ib_sel_stat %d ib_decision_ %d\n", ap.fake_faults, sp.ib_force(), reset_all_faults_, ib_sel_stat_last_, ib_amp_fa(), ib_noa_fa(), ib_diff_fa(), vb_sel_stat_last_, wrap_m_fa(), wrap_n_fa(), cc_diff_fa(), latched_fail_, ib_sel_stat_, ib_decision_);
  #endif
}

// Select ib decision table hi-lo
// Inputs:  ib_amp_fa, ib_noa_fa, ib_force, ib_diff_fa, vb_sel_stat_last_, wrap_m_fa, wrap_n_fa, cc_diff_fa, wrap_hi_or_lo_fa
// Outputs:  ib_decision_, ib_choice_, latched_fail_
void Fault::ib_decision_hi_lo(Sensors *Sen)
{
  boolean latched_fail_enter = latched_fail_;
  if ( latched_fail_ )
    // ib_decision_ = xx;   lgv
    {}
  else if ( Sen->Flt->ib_amp_fa() && Sen->Flt->ib_noa_fa() )  // these separate inputs don't latch
  {
    ib_choice_ = UsingNone;
    latched_fail_ = true;
    ib_decision_ = 1;
  }
  else if ( sp.ib_force()>0 && !Sen->Flt->ib_noa_fa() )
  {
    ib_choice_ = UsingAmp;
    latched_fail_ = true;
    ib_decision_ = 2;
  }
  else if ( sp.ib_force()<0 && !Sen->Flt->ib_noa_fa() && !reset_all_faults_)  // latches
  {
    ib_choice_ = UsingNoa;
    latched_fail_ = true;
    ib_decision_ = 3;
  }
  else if ( sp.ib_force()==0 )  // auto section
  {
    if ( Sen->Flt->ib_amp_fa() && !Sen->Flt->ib_noa_fa() )  // these inputs don't latch
    {
      ib_choice_ = UsingNoa;
      latched_fail_ = true;
      ib_decision_ = 4;
    }
    else if ( !Sen->Flt->ib_amp_fa() && Sen->Flt->ib_noa_fa() )  // these inputs don't latch
    {
      ib_choice_ = UsingAmp;
      latched_fail_ = true;
      ib_decision_ = 5;
    }
    else if ( ib_diff_fa() )  // this input doesn't latch
    {
      if ( vb_sel_stat_last_ )
      {
        if ( Sen->Flt->wrap_m_fa() && !Sen->Flt->wrap_n_fa() )
        {
          ib_choice_ = UsingNoa;
          latched_fail_ = true;
          ib_decision_ = 6;
        }
        else if ( !Sen->Flt->wrap_m_fa() && Sen->Flt->wrap_n_fa() )
        {
          ib_choice_ = UsingAmp;
          latched_fail_ = true;
          ib_decision_ = 7;
        }
        else if ( Sen->Flt->wrap_m_fa() && Sen->Flt->wrap_n_fa() )
        {
          ib_choice_ = UsingDef;  // ambiguous; keep trying
          latched_fail_ = false;
          ib_decision_ = 8;
        }
        else  // all's well
        {
          ib_choice_ = ib_choice_last_;
          latched_fail_ = latched_fail_enter;
          ib_decision_ = 0;
        }
      }
      else if ( cc_diff_fa() )  // don't know how to isolate due to weighting of amp and noa
      {
        ib_choice_ = UsingDef;  // ambiguous; keep trying
        latched_fail_ = false;
        ib_decision_ = 10;
      }
      else  // all's well
      {
        ib_choice_ = ib_choice_last_;
        latched_fail_ = latched_fail_enter;
        ib_decision_ = 0;
      }
    }
    else if ( cc_diff_fa() )  // don't know how to isolate due to weighting of amp and noa
    {
        ib_choice_ = UsingDef;  // ambiguous; keep trying
        latched_fail_ = false;
        ib_decision_ = 12;
    }
    else  // all's well
    {
      ib_choice_ = ib_choice_last_;
      latched_fail_ = latched_fail_enter;
      ib_decision_ = 0;
    }
  }
  else if ( ( (sp.ib_force() <  0) && ib_choice_last_!=UsingNoa ) ||
            ( (sp.ib_force() >= 0) && ib_choice_last_!=UsingAmp )   )  // Latches.  Must reset to move out of no amp selection.  ==0 not reachable
  {
    latched_fail_ = true;
    ib_decision_ = 14;
  }
  else
  {
    latched_fail_ = false;
    ib_decision_ = 15;
  }
  faultAssign( (ib_choice_!=0 || vb_sel_stat_!=1) && !(sp.mod_ib() || sp.mod_vb()), RED_LOSS);  // hi_lo

  #ifdef DEBUG_DETAIL
    if ( sp.debug()==62 ) Serial.printf("latched_fail_enter %d fake_faults %d ib_force %d reset %d ib_choice_last %d ib_amp_fa %d ib_noa_fa %d ib_diff_fa %d vb_sel_stat_last %d wrap_m_fa %d wrap_n_fa %d  cc_diff_fa %d latched_fail_ %d ib_choice_ %d ib_decision_ %d\n", latched_fail_enter, ap.fake_faults, sp.ib_force(), reset_all_faults_, ib_choice_last_, ib_amp_fa(), ib_noa_fa(), ib_diff_fa(), vb_sel_stat_last_, wrap_m_fa(), wrap_n_fa(), cc_diff_fa(), latched_fail_, ib_choice_, ib_decision_);
  #endif
}

// Select reset
void Fault::reset_all_faults_select()
{
  // ib
  #ifdef HDWE_IB_HI_LO
    ib_choice_ = ibSel(sp.ib_force());
    ib_choice_last_ = ib_choice_;
  #else
    if ( sp.ib_force() >= 0 )
      ib_sel_stat_ = 1;
    else
      ib_sel_stat_ = -1;
    ib_sel_stat_last_ =  ib_sel_stat_;
  #endif

  // Reset latch memory
  vb_sel_stat_last_ = 1;
  vb_sel_stat_ = 1;
}

// Checks analog current.  Latches
void Fault::shunt_check(Sensors *Sen, BatteryMonitor *Mon, const boolean reset)
{
  boolean reset_loc = reset | reset_all_faults_;
  if ( reset_loc )
  {
    failAssign(false, IB_AMP_FA);
    failAssign(false, IB_NOA_FA);
  }
  faultAssign( Sen->ShuntAmp->bare_shunt(), IB_AMP_BARE);
  faultAssign( Sen->ShuntNoAmp->bare_shunt(), IB_NOA_BARE);
  #ifndef HDWE_BARE
    faultAssign( ( ib_amp_bare() || abs(Sen->ShuntAmp->Ishunt_cal()) >= Sen->Ib_amp_max() ) && !ap.disab_ib_fa, IB_AMP_FLT );
    faultAssign( ( ib_noa_bare() || abs(Sen->ShuntNoAmp->Ishunt_cal()) >= Sen->Ib_noa_max() ) && !ap.disab_ib_fa, IB_NOA_FLT );
    #ifdef DEBUG_DETAIL
      if ( sp.debug()==62 ) Serial.printf("ib_amp_bare=%d ib_noa_bare=%d Ibm%7.3f mX%7.3f Ibn%7.3f nX%7.3f IB_AMP_FLT=%d IB_NOA_FLT=%d\n", ib_amp_bare(), ib_noa_bare(), Sen->ShuntAmp->Ishunt_cal(), Sen->Ib_amp_max(), Sen->ShuntNoAmp->Ishunt_cal(), Sen->Ib_noa_max(), IB_AMP_FLT, IB_NOA_FLT);
    #endif
  #else
    float current_max = NOM_UNIT_CAP * sp.nP();
    faultAssign( abs(Sen->ShuntAmp->Ishunt_cal()) >= current_max && !ap.disab_ib_fa, IB_AMP_FLT );
    faultAssign( abs(Sen->ShuntNoAmp->Ishunt_cal()) >= current_max && !ap.disab_ib_fa, IB_NOA_FLT );
  #endif
  if ( ap.disab_ib_fa )
  {
    failAssign( false, IB_AMP_FA );
    failAssign( false, IB_NOA_FA);
  }
  else
  {
    failAssign( vc_fa() || ib_amp_bare() || ib_amp_fa() || IbAmpHardFail->calculate(ib_amp_flt(), IB_HARD_SET, IB_HARD_RESET, Sen->T, reset_loc), IB_AMP_FA );
    failAssign( vc_fa() || ib_noa_bare() || ib_noa_fa() || IbNoAmpHardFail->calculate(ib_noa_flt(), IB_HARD_SET, IB_HARD_RESET, Sen->T, reset_loc), IB_NOA_FA);
  }
}

// Check Tb 2-wire analog voltage.  Latches
void Fault::tb_check(Sensors *Sen, const float _tb_min, const float _tb_max, const boolean reset)
{
  boolean reset_loc = reset | reset_all_faults_;
  if ( reset_loc )
  {
    failAssign(false, TB_FA);
  }
  if ( ap.disab_tb_fa || sp.mod_tb() )
  {
    faultAssign( (Sen->Tb_model_filt<=_tb_min) || (Sen->Tb_model_filt>=_tb_max), TB_FLT);
    failAssign( tb_fa() || TbHardFail->calculate(tb_flt(), TB_HARD_SET, TB_HARD_RESET, Sen->T_temp, reset_loc), TB_FA);
  }
  else if ( ap.disab_ib_fa )
  {
    faultAssign( false, TB_FLT);
    failAssign( false, TB_FA); }
  else
  {
    faultAssign( (Sen->Tb_hdwe<=_tb_min) || (Sen->Tb_hdwe>=_tb_max), TB_FLT);
    failAssign( tb_fa() || TbHardFail->calculate(tb_flt(), TB_HARD_SET, TB_HARD_RESET, Sen->T_temp, reset_loc), TB_FA);
  }
}

// Temp stale check
void Fault::tb_stale(const boolean reset, Sensors *Sen)
{
  boolean reset_loc = reset | reset_all_faults_;

  if ( ap.disab_tb_fa || reset_loc || (sp.mod_tb() && !ap.fail_tb) )
  {
    faultAssign( false, TB_FLT );
    failAssign( false, TB_FA );
  }
  else
  {
    faultAssign( Sen->SensorTb->tb_stale_flt(), TB_FLT );
    failAssign( TbStaleFail->calculate(tb_flt(), TB_STALE_SET*ap.tb_stale_time_slr, TB_STALE_RESET*ap.tb_stale_time_slr,
      Sen->T_temp, reset_loc), TB_FA );
  }
}

// Check analog voltage.  Latches
void Fault::vb_check(Sensors *Sen, BatteryMonitor *Mon, const float _vb_min, const float _vb_max, const boolean reset)
{
  boolean reset_loc = reset | reset_all_faults_;
  if ( reset_loc )
  {
    failAssign(false, VB_FA);
  }
  if ( ap.disab_vb_fa || sp.mod_vb() )
  {
    faultAssign(false, VB_FLT);
    failAssign( false, VB_FA);
  }
  else
  {
    faultAssign( (Sen->vb_hdwe()<=_vb_min && Sen->ib_hdwe()*sp.nP()>IB_MIN_UP) || (Sen->vb_hdwe()>=_vb_max), VB_FLT);
    failAssign( vb_fa() || VbHardFail->calculate(vb_flt(), VB_HARD_SET, VB_HARD_RESET, Sen->T, reset_loc), VB_FA);
  }
}
void Fault::vc_check(Sensors *Sen, BatteryMonitor *Mon, const float _vc_min, const float _vc_max, const boolean reset)
{
  boolean reset_loc = reset | reset_all_faults_;
  if ( reset_loc )
  {
    failAssign(false, VC_FA);
  }
  if ( sp.mod_ib() || ap.disab_ib_fa )
  {
    faultAssign(false, VC_FLT);
    failAssign( false, VC_FA);
  }
  else
  {
    faultAssign( ( ((Sen->Vc<=_vc_min) || (Sen->Vc>=_vc_max)) && !reset_loc ), VC_FLT);
    failAssign( vc_fa() || VcHardFail->calculate(vc_flt(), VC_HARD_SET, VC_HARD_RESET, Sen->T, reset_loc), VC_FA);
  }
}

// Wrap scalars
void Fault::wrap_scalars(BatteryMonitor *Mon)
{
  if ( Mon->soc()>=WRAP_SOC_HI_OFF )
  {
    ewsat_slr_ = WRAP_SOC_HI_SLR;
    ewmin_slr_ = 1.;
  }
  else if ( Mon->soc() <= max(Mon->soc_min()+WRAP_SOC_LO_OFF_REL, WRAP_SOC_LO_OFF_ABS)  )
  {
    ewsat_slr_ = 1.;
    ewmin_slr_ = WRAP_SOC_LO_SLR;
  }
  else if ( Mon->voc_soc()>(Mon->vsat()-WRAP_HI_SAT_MARG) ||
          ( Mon->voc_stat()>(Mon->vsat()-WRAP_HI_SAT_MARG) && Mon->C_rate()>WRAP_MOD_C_RATE && Mon->soc()>WRAP_SOC_MOD_OFF) ) // Use voc_stat to get some anticipation
  {
    ewsat_slr_ = WRAP_HI_SAT_SLR;
    ewmin_slr_ = 1.;
  }
  else
  {
    ewsat_slr_ = 1.;
    ewmin_slr_ = 1.;
  }
  ewhi_thr_ = Mon->r_ss() * WRAP_HI_A * ap.ewhi_slr * ewsat_slr_ * ewmin_slr_;
  ewlo_thr_ = Mon->r_ss() * WRAP_LO_A * ap.ewlo_slr * ewsat_slr_ * ewmin_slr_;
}


// Class Sensors
Sensors::Sensors(double T, double T_temp, Pins *pins, Sync *ReadSensors, Sync *Talk, Sync *Summarize, unsigned long long time_now,
  unsigned long long millis, BatteryMonitor *Mon):  inst_millis_(millis), inst_time_(time_now), reset_temp_(false),
  sample_time_ib_(0UL), sample_time_ib_hdwe_(0UL), sample_time_vb_(0UL), sample_time_vb_hdwe_(0UL)
{
  this->T = T;
  this->T_filt = T;
  this->T_temp = T_temp;
  #if defined(HDWE_IB_HI_LO) || defined(HDWE_BARE)
    this->ShuntAmp = new Shunt("Amp", 0x49, &sp.ib_scale_amp_z, &sp.ib_bias_amp_z, SHUNT_AMP_GAIN, pins->Vcm_pin, pins->Vom_pin, pins->Vh3v3_pin, true);
    this->ShuntNoAmp = new Shunt("No Amp", 0x48, &sp.ib_scale_noa_z, &sp.ib_bias_noa_z, SHUNT_NOA_GAIN, pins->Vcn_pin, pins->Von_pin, pins->Vh3v3_pin, true);
  #else
    this->ShuntAmp = new Shunt("Amp", 0x49, &sp.ib_scale_amp_z, &sp.ib_bias_amp_z, SHUNT_AMP_GAIN, pins->Vcm_pin, pins->Vom_pin, pins->Vh3v3_pin, false);
    this->ShuntNoAmp = new Shunt("No Amp", 0x48, &sp.ib_scale_noa_z, &sp.ib_bias_noa_z, SHUNT_NOA_GAIN, pins->Vcn_pin, pins->Von_pin, pins->Vh3v3_pin, false);
  #endif
  #if !defined(HDWE_2WIRE) & !defined(HDWE_BARE)
    this->SensorTb = new TempSensor(pins->pin_1_wire, TEMP_PARASITIC, TEMP_DELAY);
  #elif !defined(HDWE_BARE)
    this->SensorTb = new TempSensor(pins->pin_1_wire, TEMP_PARASITIC, TEMP_DELAY, pins->VTb_pin);
  #endif
  this->TbSenseFilt = new General2_Pole(double(READ_DELAY)/1000., F_W_T, F_Z_T, -20.0, 150.);
  this->Sim = new BatterySim();
  this->elapsed_inj = 0ULL;
  this->start_inj = 0ULL;
  this->stop_inj = 0ULL;
  this->end_inj = 0ULL;
  this->ReadSensors = ReadSensors;
  this->Summarize = Summarize;
  this->Talk = Talk;
  this->display = true;
  this->Ib_hdwe_model = 0.;
  Prbn_Tb_ = new PRBS_7(TB_NOISE_SEED);
  Prbn_Vb_ = new PRBS_7(VB_NOISE_SEED);
  Prbn_Ib_amp_ = new PRBS_7(IB_AMP_NOISE_SEED);
  Prbn_Ib_noa_ = new PRBS_7(IB_NOA_NOISE_SEED);
  Flt = new Fault(T, &sp.preserving_z, Mon, this);
  Serial.printf("Vb sense ADC pin started\n");
  AmpFilt = new LagExp(T, AMP_FILT_TAU, -NOM_UNIT_CAP, NOM_UNIT_CAP);
  NoaFilt = new LagExp(T, AMP_FILT_TAU, -NOM_UNIT_CAP*sp.nS()*sp.nP(), NOM_UNIT_CAP*sp.nS()*sp.nP());
  SelFilt = new LagExp(T, AMP_FILT_TAU, -NOM_UNIT_CAP*sp.nS()*sp.nP(), NOM_UNIT_CAP*sp.nS()*sp.nP());
  VbFilt = new LagExp(T, AMP_FILT_TAU, 0., NOMINAL_VB*2.5);
  #ifdef HDWE_IB_HI_LO
    sel_brk_hdwe = new ScaleBrk(HDWE_IB_HI_LO_NOA_LO, HDWE_IB_HI_LO_AMP_LO, HDWE_IB_HI_LO_AMP_HI, HDWE_IB_HI_LO_NOA_HI);
  #else
    sel_brk_hdwe = new ScaleBrk(0., 0., 0., 0.);
  #endif
}

// Deliberate choice based on results and inputs
// Inputs:  ib_sel_stat_, Ib_amp_hdwe, Ib_noa_hdwe, Ib_amp_model, Ib_noa_model
// Outputs:  Ib_hdwe_model, Ib_hdwe
void Sensors::ib_choose_active_standby()
{
  if ( Flt->ib_sel_stat()==1 )
  {
    Ib_hdwe = Ib_amp_hdwe;
    Ib_hdwe_model = Ib_amp_model;
    sample_time_ib_hdwe_ = ShuntAmp->sample_time();
    dt_ib_hdwe_ = ShuntAmp->dt();
  }
  else if ( Flt->ib_sel_stat()==-1 )
  {
    Ib_hdwe = Ib_noa_hdwe;
    Ib_hdwe_model = Ib_noa_model;
    sample_time_ib_hdwe_ = ShuntNoAmp->sample_time();
    dt_ib_hdwe_ = ShuntNoAmp->dt();
  }
  else
  {
    Ib_hdwe = 0.;
    Ib_hdwe_model = 0.;
    sample_time_ib_hdwe_ = 0ULL;
    dt_ib_hdwe_ = 0ULL;
  }
}

// Deliberate choice based on results and inputs
// Inputs:  ib_choice_, Ib_noa_hdwe, Ib_amp_hdwe, Ib_noa_hdwe, Ib_amp_model, Ib_noa_model
// Outputs:  Ib_hdwe_model, Ib_hdwe
void Sensors::ib_choose_hi_lo()
{
  int8_t sel_stat = 0;
  if ( Flt->ib_choice()==UsingDef )
  {
    Ib_hdwe = scale_select(Ib_noa_hdwe, sel_brk_hdwe, Ib_amp_hdwe, Ib_noa_hdwe, &sel_stat);
    Ib_hdwe_model = scale_select(Ib_noa_model, sel_brk_hdwe, Ib_amp_model, Ib_noa_model, &sel_stat);
    sample_time_ib_hdwe_ = ShuntNoAmp->sample_time();
    dt_ib_hdwe_ = ShuntNoAmp->dt();
    Flt->ib_sel_stat(sel_stat);
  }
  else if ( Flt->ib_choice()==UsingNoa )
  {
    Ib_hdwe = Ib_noa_hdwe;
    Ib_hdwe_model = Ib_noa_model;
    sample_time_ib_hdwe_ = ShuntNoAmp->sample_time();
    dt_ib_hdwe_ = ShuntNoAmp->dt();
    Flt->ib_sel_stat(-1);
  }
  else if ( Flt->ib_choice()==UsingAmp )
  {
    Ib_hdwe = Ib_amp_hdwe;
    Ib_hdwe_model = Ib_amp_model;
    sample_time_ib_hdwe_ = ShuntAmp->sample_time();
    dt_ib_hdwe_ = ShuntAmp->dt();
    Flt->ib_sel_stat(1);
  }
  else
  {
    Ib_hdwe = 0.;
    Ib_hdwe_model = 0.;
    sample_time_ib_hdwe_ = 0ULL;
    dt_ib_hdwe_ = 0ULL;
    Flt->ib_sel_stat(0);
  }
}

// Make final assignemnts
void Sensors::select_all_hdwe_or_model(BatteryMonitor *Mon)
{

  #ifdef HDWE_IB_HI_LO
    // Reselect ib since may be changed
    // Inputs:  ib_choice_, Ib_amp_hdwe, Ib_noa_hdwe, Ib_amp_model(past), Ib_noa_model(past)
    // Outputs:  Ib_hdwe_model, Ib_hdwe
    ib_choose_hi_lo();
  #else
    // Reselect ib since may be changed
    // Inputs:  ib_sel_stat_, Ib_amp_hdwe, Ib_noa_hdwe, Ib_amp_model(past), Ib_noa_model(past)
    // Outputs:  Ib_hdwe_model, Ib_hdwe
    ib_choose_active_standby();
  #endif

  // Final assignments
  // tb
  if ( sp.mod_tb() )
  {
    if ( Flt->tb_fa() )
    {
      Tb = NOMINAL_TB;
      Tb_filt = NOMINAL_TB;

    }
    else
    {
      Tb = RATED_TEMP + Tb_noise() + ap.Tb_bias_model;
      Tb_filt = RATED_TEMP + ap.Tb_bias_model;  // Simplifying assumption that Tb_filt perfectly quiet - so don't have to make model of filter
    }
    #ifndef HDWE_PHOTON
      if ( sp.debug()==16) Serial.printf("Tb_noise %7.3f Tb%7.3f Tb_filt%7.3f tb_fa %d\n", Tb_noise(), Tb, Tb_filt, Flt->tb_fa());
    #endif
  }
  else
  {
    if ( Flt->tb_fa() )
    {
      Tb = NOMINAL_TB;
      Tb_filt = NOMINAL_TB;
    }
    else
    {
      Tb = Tb_hdwe;
      Tb_filt = Tb_hdwe_filt;
    }
  }

  // vb
  if ( sp.mod_vb() )
  {
    if ( (Flt->wrap_vb_fa() || Flt->vb_fa()) && !ap.fake_faults )
    {
      Vb = Mon->vb_model_rev() * sp.nS();
      sample_time_vb_ = Sim->sample_time();
    }
    else
    {
      Vb = Vb_model + Vb_noise();
      sample_time_vb_ = Sim->sample_time();
    }
  }
  else
  {
    if ( (Flt->wrap_vb_fa() || Flt->vb_fa()) && !ap.fake_faults )
    {
      Vb = Mon->vb_model_rev() * sp.nS();
      sample_time_vb_ = Sim->sample_time();
    }
    else
    {
      Vb = Vb_hdwe;
      sample_time_vb_ = sample_time_vb_hdwe_;
    }
  }
  
  // ib
  if ( sp.mod_ib() )
  {
    Ib = Ib_hdwe_model;
    Ib_amp = Ib_amp_model;
    Ib_noa = Ib_noa_model;
    Vc = HALF_V3V3;
    sample_time_ib_ = Sim->sample_time();
    dt_ib_ = Sim->dt();
  }
  else
  {
    Ib = Ib_hdwe;
    Ib_amp = Ib_amp_hdwe;
    Ib_noa = Ib_noa_hdwe;
    Vc = Vc_hdwe;
    sample_time_ib_ = sample_time_ib_hdwe_;
    dt_ib_ = dt_ib_hdwe_;
  }
  now = sample_time_ib_ - inst_millis_ + inst_time_*1000;
  if ( sp.debug()==62 ) Serial.printf(" Ib%7.3f Ib_hdwe%7.3f Ib_hdwe_model%7.3f Ib_amp%7.3f Ib_amp_model%7.3f Ib_amp_hdwe%7.3f Ib_noa%7.3f Ib_noa_model%7.3f Ib_noa_hdwe%7.3f\n",
   Ib, Ib_hdwe, Ib_hdwe_model, Ib_amp, Ib_amp_model, Ib_amp_hdwe, Ib_noa, Ib_noa_model, Ib_noa_hdwe);

  // print_signal_select for data collection
  if ( (sp.debug()==2 || sp.debug()==4 || sp.debug()==61 )  && cp.publishS )
  {
      double cTime = double(now)/1000.;

      sprintf(pr.buff, "unit_sel,%13.3f, %d, %d,  %10.7f, %8.5f,%8.5f,%8.5f,%8.5f,%8.5f, %8.5f,%8.5f, ",
          cTime, reset, sp.ib_force(),
          Flt->cc_diff(),
          ib_amp_hdwe(), ib_noa_hdwe(), ib_amp_model(), ib_noa_model(), ib_model(), 
          Flt->ib_diff(), Flt->ib_diff_f());
      Serial.printf("%s", pr.buff);

      sprintf(pr.buff, "  %7.5f,%8.5f,%8.5f,%8.5f,%8.5f,%8.5f,%8.5f,%8.5f,",
          Mon->voc_soc(), Flt->e_wrap(), Flt->e_wrap_filt(), Flt->e_wrap_m(), Flt->e_wrap_m_filt(), Flt->e_wrap_n(), Flt->e_wrap_n_filt(),
          Flt->LoopIbAmp->e_wrap_trim());
      Serial.printf("%s", pr.buff);

        sprintf(pr.buff, "  %d,%8.5f,%8.5f,%8.5f, %d,%8.5f,  %d,%8.5f,%8.5f, %d,%8.5f,  %5.2f,%5.2f, %d, %5.2f, ",
            Flt->ib_sel_stat(), vc_hdwe(), ib_hdwe(), ib_hdwe_model(), sp.mod_ib(), ib(),
            Flt->vb_sel_stat(), vb_hdwe(), vb_model(), sp.mod_vb(), vb(),
            Tb_hdwe, Tb, sp.mod_tb(), Tb_filt);

      Serial.printf("%s", pr.buff);

      sprintf(pr.buff, "%ld, %ld, %7.3f, %7.3f, %d, %9.6f,%7.3f,%7.3f,%7.3f,%7.3f,%d,%d,%7.3f,%d,",
          Flt->fltw(), Flt->falw(), Flt->ib_rate(), Flt->ib_quiet(), Flt->tb_sel_status(),
          Flt->cc_diff_thr(), Flt->ewhi_thr(), Flt->ewlo_thr(), Flt->ib_diff_thr(), Flt->ib_quiet_thr(), Flt->preserving(), ap.fake_faults,
          Mon->y_ekf_filt(), Flt->ib_decision());
      Serial.printf("%s\n", pr.buff);
  }
}

// Selection print debug
#ifdef DEBUG_DETAIL
  void Sensors::select_print(Sensors *Sen, BatteryMonitor *Mon)  // vv==62
  {
    Serial.printf("ib_ %7.3f                     vb_hdwe %7.3f                      Tb_hdwe %7.3f\n", ib_hdwe(), vb_hdwe(), Tb_hdwe);
    Serial.printf("ib limits amp%7.3f noa %7.3f  diff %7.3f\n", ap.ib_amp_max, ap.ib_noa_max, Flt->ib_diff_thr());
    Serial.printf("ib_hdwe_?: %7.3f %7.3f ib_model_?: %7.3f %7.3f", ib_amp_hdwe(), ib_noa_hdwe(), ib_amp_model(), ib_noa_model());
    #ifdef HDWE_IB_HI_LO
      Serial.printf(" ib_choice_ %d ibmfa %d ibnfa %d ibdfa %d\n", Flt->ib_choice(), Flt->ib_amp_fa(), Flt->ib_noa_fa(), Flt->ib_diff_fa());
    #else
      Serial.printf(" ib_sel_stat_ %d ibmfa %d ibnfa %d ibdfa %d\n", Flt->ib_sel_stat(), Flt->ib_amp_fa(), Flt->ib_noa_fa(), Flt->ib_diff_fa());
    #endif
    Serial.printf("ib_hdwe:     %7.3f     ib_hdwe_model: %7.3f  modeling=%d\n", ib_hdwe(), ib_hdwe_model(), sp.mod_ib());
    Serial.printf("               ib:  %7.3f\n", ib());
    Serial.printf("     ");
    Serial.printf("ib_ %7.3f                     vb_hdwe %7.3f                      Tb_hdwe %7.3f\n", ib_hdwe(), vb_hdwe(), Tb_hdwe);
    Serial.printf("ib limits amp%7.3f noa %7.3f  diff %7.3f\n", ap.ib_amp_max, ap.ib_noa_max, Flt->ib_diff_thr());
    Serial.printf("ib_hdwe_?: %7.3f %7.3f ib_model_?: %7.3f %7.3f", ib_amp_hdwe(), ib_noa_hdwe(), ib_amp_model(), ib_noa_model());
    Serial.printf("ib_hdwe:     %7.3f     ib_hdwe_model: %7.3f  modeling=%d\n", ib_hdwe(), ib_hdwe_model(), sp.mod_ib());
    Serial.printf("               ib:  %7.3f\n", ib());
    Serial.printf("     ");
  }
#endif

// Tb noise
float Sensors::Tb_noise()
{
  if ( ap.Tb_noise_amp==0. ) return ( 0. );
  uint8_t raw = Prbn_Tb_->calculate();
  float noise = (float(raw)/127. - 0.5) * ap.Tb_noise_amp;
  return ( noise );
}

// Conversion.   Here to avoid circular reference to sp in headers.
float Sensors::Ib_amp_add() { return ( ap.ib_amp_add * sp.nP() ); };
float Sensors::Ib_amp_max() { if (sp.tweak_test()) return ( __FLT_MAX__ ); else return ( ap.ib_amp_max * sp.nP() ); };
float Sensors::Ib_amp_min() { if (sp.tweak_test()) return ( -__FLT_MAX__ ); else return ( ap.ib_amp_min * sp.nP() ); };
float Sensors::Ib_noa_add() { return ( ap.ib_noa_add * sp.nP() ); };
float Sensors::Ib_noa_max() { if (sp.tweak_test()) return ( __FLT_MAX__ ); else return ( ap.ib_noa_max * sp.nP() ); };
float Sensors::Ib_noa_min() { if (sp.tweak_test()) return ( -__FLT_MAX__ ); else return ( ap.ib_noa_min * sp.nP() ); };
float Sensors::Vb_add() { return ( ap.vb_add * sp.nS() ); };

// Vb noise
float Sensors::Vb_noise()
{
  if ( ap.Vb_noise_amp==0. ) return ( 0. );
  uint8_t raw = Prbn_Vb_->calculate();
  float noise = (float(raw)/127. - 0.5) * ap.Vb_noise_amp;
  return ( noise );
}

// Ib noise
float Sensors::Ib_amp_noise()
{
  if ( ap.Ib_amp_noise_amp==0. ) return ( 0. );
  uint8_t raw = Prbn_Ib_amp_->calculate();
  float noise = (float(raw)/125. - 0.5) * ap.Ib_amp_noise_amp;
  return ( noise );
}
float Sensors::Ib_noa_noise()
{
  if ( ap.Ib_noa_noise_amp==0. ) return ( 0. );
  uint8_t raw = Prbn_Ib_noa_->calculate();
  float noise = (float(raw)/125. - 0.5) * ap.Ib_noa_noise_amp;
  return ( noise );
}

// Print Shunt selection data
void Sensors::shunt_print()
{
    Serial.printf("reset,T,select,inj_bias,  vim,Vsm,Vcm,Vom,Ibhm,  vin,Vsn,Vcn,Von,Ibhn,  vi3,vh3, Ib_hdwe,T,Ib_amp_fault,Ib_amp_fail,Ib_noa_fault,Ib_noa_fail,=,    %d,%7.3f,%d,%7.3f,    %d,%7.3f,%7.3f,%7.3f,%7.3f,    %d,%7.3f,%7.3f,%7.3f,%7.3f,    %7.3f,%7.3f, %d,%d,  %d,%d,\n",
        reset, T, sp.ib_force(), sp.inj_bias(),
        ShuntAmp->vshunt_int(), ShuntAmp->vshunt(), ShuntAmp->Vc(), ShuntAmp->Vo(), ShuntAmp->Ishunt_cal(),
        ShuntNoAmp->vshunt_int(), ShuntNoAmp->vshunt(), ShuntNoAmp->Vc(), ShuntNoAmp->Vo(), ShuntNoAmp->Ishunt_cal(),
        Ib_hdwe, T,
        Flt->ib_amp_flt(), Flt->ib_amp_fa(), Flt->ib_noa_flt(), Flt->ib_noa_fa());
}

// Shunt selection.  Use Coulomb counter and EKF to sort three signals:  amp current, non-amp current, voltage
// Initial selection to charge the Sim for modeling currents on BMS cutback
// Inputs: sp.ib_force (user override), Mon (EKF status)
// States:  Ib_fail_noa_
// Outputs:  Ib_hdwe, Ib_model_in, Vb_sel_status_
void Sensors::shunt_select_initial(const boolean reset)
{
    // Current signal selection, based on if there or not.
    // Over-ride 'permanent' with Talk(sp.ib_force) = Talk('s')

    // Hardware and model current assignments
    float hdwe_add, mod_add;
    if ( !sp.mod_ib() )
    {
      mod_add = 0.;
      hdwe_add = sp.ib_bias_all() + sp.inj_bias();
    }
    else
    {
      mod_add = sp.ib_bias_all() + sp.inj_bias();
      if ( sp.tweak_test() )
        hdwe_add = sp.inj_bias();
      else
        hdwe_add = 0.;
    }
    Ib_amp_model = max(min(Ib_model + Ib_amp_add() + mod_add, Ib_amp_max()/SIZE_MARG), Ib_amp_min()/SIZE_MARG); // uses past Ib.  Synthesized signal to use as substitute for sensor, Dm/Mm/Nm
    Ib_noa_model = max(min(Ib_model + Ib_noa_add() + mod_add, Ib_noa_max()/SIZE_MARG), Ib_noa_min()/SIZE_MARG); // uses past Ib.  Synthesized signal to use as substitute for sensor, Dn/Nx/Nm
    Ib_amp_hdwe = ShuntAmp->Ishunt_cal() + hdwe_add;    // Sense fault injection feeds logic, not model
    Ib_amp_hdwe_f = AmpFilt->calculate(Ib_amp_hdwe, reset, AMP_FILT_TAU, T);
    Vc_hdwe = max(ShuntAmp->Vc(), ShuntNoAmp->Vc());
    Ib_noa_hdwe = ShuntNoAmp->Ishunt_cal() + hdwe_add;  // Sense fault injection feeds logic, not model
    Ib_noa_hdwe_f = NoaFilt->calculate(Ib_noa_hdwe, reset, AMP_FILT_TAU, T);
    Ib_hdwe_f = SelFilt->calculate(Ib_hdwe, reset, AMP_FILT_TAU, T);
    
    // Initial choice
    // Inputs:  ib_choice/ib_sel_stat_, Ib_amp_hdwe, Ib_noa_hdwe, Ib_amp_model(past), Ib_noa_model(past)
    // Outputs:  Ib_hdwe_model, Ib_hdwe
    #ifdef HDWE_IB_HI_LO
      ib_choose_hi_lo();
    #else
      ib_choose_active_standby();
    #endif

    // When running normally the model tracks hdwe to synthesize reference information
    if ( !sp.mod_ib() )
    {
      Ib_model_in = Ib_hdwe;
    }
    // Otherwise it generates signals for feedback into monitor
    else
    {
      Ib_model_in = mod_add;
      // if ( sp.debug()==-24 ) Serial.printf("ib_bias_all%7.3f mod_add%7.3f Ib_model_in%7.3f\n", sp.ib_bias_all(), mod_add, Ib_model_in);
    }
}

// Load and filter Tb
void Sensors::temp_load_and_filter(Sensors *Sen, const boolean reset_temp)
{
  Log.info("top temp_load_and_filter");
  reset_temp_ = reset_temp;
  #ifndef HDWE_BARE
    Tb_hdwe = SensorTb->sample(Sen);
  #else
    Tb_hdwe = RATED_TEMP;
  #endif

  // Filter and add rate limited bias
  if ( reset_temp_ && Tb_hdwe>TEMP_RANGE_CHECK_MAX )  // Bootup T=85.5 C
  {
      Tb_hdwe = RATED_TEMP;
      Tb_hdwe_filt = TbSenseFilt->calculate(RATED_TEMP, reset_temp_, min(T_temp, F_MAX_T_TEMP));
  }
  else
  {
      Tb_hdwe_filt = TbSenseFilt->calculate(Tb_hdwe, reset_temp_, min(T_temp, F_MAX_T_TEMP));
  }
  Tb_hdwe += sp.Tb_bias_hdwe();
  Tb_hdwe_filt += sp.Tb_bias_hdwe();

  if ( sp.debug()==16 || (sp.debug()==-1 && reset_temp_) ) Serial.printf("reset_temp_,Tb_bias_hdwe_loc, RATED_TEMP, Tb_hdwe, Tb_hdwe_filt, ready %d %7.3f %7.3f %7.3f %7.3f %d\n",
    reset_temp_, sp.Tb_bias_hdwe(), RATED_TEMP, Tb_hdwe, Tb_hdwe_filt, cp.tb_info.ready);

  #ifdef HDWE_2WIRE
    Flt->tb_check(Sen, TB_MIN, TB_MAX,  reset_temp_);
  #else
    Flt->tb_stale(reset_temp_, Sen);
  #endif
}

// Load analog voltage
void Sensors::vb_load(const uint16_t vb_pin, const boolean reset)
{
  if ( !sp.mod_vb_dscn() )
  {
    #if !defined(HDWE_BARE)
      Vb_raw = analogRead(vb_pin);
      Vb_hdwe =  float(Vb_raw)*VB_CONV_GAIN*sp.Vb_scale() + float(VB_A) + sp.Vb_bias_hdwe();
    #endif
    Vb_hdwe_f = VbFilt->calculate(Vb_hdwe, reset, AMP_FILT_TAU, T);
  }
  else
  {
    Vb_raw = 0;
    Vb_hdwe = 0.;
  }
  sample_time_vb_hdwe_ = System.millis();
}

// Print analog voltage
void Sensors::vb_print()
{
  Serial.printf("reset, T, vb_dscn, Vb_raw, sp.Vb_bias_hdwe(), Vb_hdwe, vb_flt(), vb_fa(), wv_fa=, %d, %7.3f, %d, %d, %7.3f,  %7.3f, %d, %d, %d,\n",
    reset, T, sp.mod_vb_dscn(), Vb_raw, sp.Vb_bias_hdwe(), Vb_hdwe, Flt->vb_flt(), Flt->vb_fa(), Flt->wrap_vb_fa());
}


// Scale select between a high and low set of inputs.  Low might be a precise, amplified sensor and high might be the high range equivalent
float scale_select(const float in, const ScaleBrk *brk, const float lo, const float hi)
{
  
  if ( brk->n_hi <= in && in <= brk->p_lo )
  {
    // if ( sp.debug()==99 ) Serial.printf("scale_select lo: in=%7.3f, brk->n_hi=%7.3f, brk->p_lo=%7.3f, lo=%7.3f, hi=%7.3f, sel=%7.3f\n", in, brk->n_hi, brk->p_lo, lo, hi, lo);
    return ( lo );
  }

  else if ( in <= brk->n_lo || in >= brk->p_hi )
  {
    // if ( sp.debug()==99 ) Serial.printf("scale_select hi: in=%7.3f, brk->n_lo=%7.3f, brk->p_hi=%7.3f, lo=%7.3f, hi=%7.3f, sel=%7.3f\n", in, brk->n_lo, brk->p_hi, lo, hi, hi);
    return ( hi );
  }

  else if ( in < brk->n_hi )
  {
    // if ( sp.debug()==99 ) Serial.printf("scale_select n t: in=%7.3f, brk->n_hi=%7.3f, brk->p_lo=%7.3f, lo=%7.3f, hi=%7.3f\n", in, brk->n_hi, brk->p_lo, lo, hi);
    return ( (in - brk->n_lo) / brk->n_d * (hi - lo) + hi );
  }

  else
  {
    // if ( sp.debug()==99 ) Serial.printf("scale_select p t: in=%7.3f, brk->n_hi=%7.3f, brk->p_lo=%7.3f, lo=%7.3f, hi=%7.3f\n", in, brk->n_hi, brk->p_lo, lo, hi);
    return ( (in - brk->p_lo) / brk->p_d * (hi - lo) + hi );
  }

}
float scale_select(const float in, const ScaleBrk *brk, const float lo, const float hi, int8_t *sel_stat)
{
  
  if ( brk->n_hi <= in && in <= brk->p_lo )
  {
    *sel_stat = 1;
    // if ( sp.debug()==99 ) Serial.printf("scale_select lo: in=%7.3f, brk->n_hi=%7.3f, brk->p_lo=%7.3f, lo=%7.3f, hi=%7.3f, sel=%7.3f\n", in, brk->n_hi, brk->p_lo, lo, hi, lo);
    return ( lo );
  }

  else if ( in <= brk->n_lo || in >= brk->p_hi )
  {
    *sel_stat = -1;
    // if ( sp.debug()==99 ) Serial.printf("scale_select hi: in=%7.3f, brk->n_lo=%7.3f, brk->p_hi=%7.3f, lo=%7.3f, hi=%7.3f, sel=%7.3f\n", in, brk->n_lo, brk->p_hi, lo, hi, hi);
    return ( hi );
  }

  else if ( in < brk->n_hi )
  {
    *sel_stat = 0;
    // if ( sp.debug()==99 ) Serial.printf("scale_select n t: in=%7.3f, brk->n_hi=%7.3f, brk->p_lo=%7.3f, lo=%7.3f, hi=%7.3f\n", in, brk->n_hi, brk->p_lo, lo, hi);
    return ( (in - brk->n_lo) / brk->n_d * (hi - lo) + hi );
  }

  else
  {
    *sel_stat = 0;
    // if ( sp.debug()==99 ) Serial.printf("scale_select p t: in=%7.3f, brk->n_hi=%7.3f, brk->p_lo=%7.3f, lo=%7.3f, hi=%7.3f\n", in, brk->n_hi, brk->p_lo, lo, hi);
    return ( (in - brk->p_lo) / brk->p_d * (hi - lo) + hi );
  }

}
