davegutz/myStateOfCharge/SOC_Particle/pyStateOfCharge/CompareTensorData.py

# CompareTensorData:  Load long term hysteresis data and extract and save
# Copyright (C) 2023 Dave Gutz
#
# This library is free software; you can redistribute it and/or
# modify it under the terms of the GNU Lesser General Public
# License as published by the Free Software Foundation;
# version 2.1 of the License.
#
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
# See http://www.fsf.org/licensing/licenses/lgpl.txt for full license text.

""" Extract and save long term hysteresis data from file and save for regression by TrainTensor.py for example."""
import numpy as np

from MonSim import replicate, save_clean_file
from unite_pictures import unite_pictures_into_pdf, cleanup_fig_files, precleanup_fig_files
from CompareFault import over_fault
import matplotlib.pyplot as plt
from datetime import datetime
from CompareRunRun import load_data
from DataOverModel import dom_plot
from PlotSimS import sim_s_plot
from PlotEKF import ekf_plot
from PlotGP import gp_plot
from PlotOffOn import off_on_plot
import os
from myFilters import LagExp
import numpy.lib.recfunctions as rf
from Chemistry_BMS import ib_lag, Chemistry
import sys
if sys.platform == 'darwin':
    import matplotlib
    matplotlib.use('tkagg')
plt.rcParams['axes.grid'] = True


# Add ib_lag = ib lagged by time constant
def add_ib_lag(data):
    lag_tau = ib_lag(data.chm[0])
    IbLag = LagExp(1., lag_tau, -100., 100.)
    n = len(data.cTime)
    if data.ib_lag is None:
        data = rf.rec_append_fields(data, 'ib_lag', np.array(data.sat, dtype=float))
        data.ib_lag = np.zeros(n)
    dt = data.cTime[1] - data.cTime[0]
    for i in range(n):
        if i > 0:
            dt = data.cTime[i] - data.cTime[i-1]
        data.ib_lag[i] = IbLag.calculate_tau(float(data.ib[i]), i == 0, dt, lag_tau)
    return data


# Add reshaped voc_soc curve, so it shows on plots to adjust it
def add_voc_soc_new(data):
    chm = data.chm[1]
    chem = Chemistry(chm)
    chem.assign_all_mod(chm)
    n = len(data.cTime)
    data.voc_soc_new = np.zeros(n)
    for i in range(n):
        data.voc_soc_new[i] = chem.lookup_voc(data.soc[i], data.Tb[i])
    return data


# Scale soc and adjust ib for observed calibration error
def adjust_soc(data, dDA_in, scap_in=None):
    n = len(data.cTime)
    d_soc = 0.
    for i in range(n-1):
        T = data.cTime[i+1] - data.cTime[i]
        # Accumulated soc change
        if scap_in is None:
            d_soc += dDA_in * T / data.qcrs[i]
        else:
            d_soc += dDA_in * T / 360000. / scap_in
        data.soc[i+1] += d_soc
        data.soc_s[i+1] += d_soc
        data.soc_ekf[i+1] += d_soc
        data.ib[i] += dDA_in
        data.ib_charge[i] += dDA_in
    return data


# Scale soc and adjust ib for observed calibration error
def scale_sres0(data, sres0):
    data.dv_dyn *= sres0
    return data


def seek_tensor(save_pdf_path='./figures', path_to_temp='./temp'):
    date_time = datetime.now().strftime("%Y-%m-%dT%H-%M-%S")
    date_ = datetime.now().strftime("%y%m%d")
    if not os.path.isdir(save_pdf_path):
        os.mkdir(save_pdf_path)
    if not os.path.isdir(path_to_temp):
        os.mkdir(path_to_temp)

    # Transient  inputs
    init_time_in = None
    use_ib_mon_in = True
    skip = 1
    time_end_in = None
    # plot_init_in = False
    long_term_in = False
    plot_overall_in = True
    use_vb_sim_in = False
    cc_dif_tol_in = 0.2
    verbose_in = False
    legacy_in = False
    # data_file_txt = None
    temp_file = ''
    # sat_init_in = None
    use_mon_soc_in = True
    v1_only_in = True
    dDA_in = 0.
    zero_zero_in = True
    unit_key = 'soc0p'
    data_file_path = None
    sres0_in = 1.
    stauct_mon_in = 1.
    sresct_in = 1.

    data_file_txt = 'temp/putty_2023-09-17T16-48-56_join.csv'

    # data_file_txt = 'GenerateDV_Data_Loop_cat_20230916.csv'; use_vb_sim_in = True; use_ib_mon_in = False
    # data_file_txt = 'GenerateDV_Data_Loop_step_20230916.csv'; use_vb_sim_in = True; use_ib_mon_in = False
    # data_file_txt = 'GenerateDV_Data_Loop_simple_20230916.csv'; use_vb_sim_in = True; use_ib_mon_in = False

    # data_file_txt = 'dv_20230911_soc0p_ch_raw.csv'; stauct_mon_in = 1.; sresct_in = 1.
    # data_file_txt = 'dv_20230831_soc0p_ch_clip.csv'; dDA_in = .023
    # data_file_txt = 'dv_validate_soc0p_ch_clip.csv'; dDA_in = .023
    # data_file_txt = 'dv_test_soc0p_ch.csv';  dDA_in = .023

    # Save these examples
    # data_file_txt = 'GenerateDV_Data.csv'; use_vb_sim_in = True; use_ib_mon_in = False

    data_file = None
    if data_file_path is None:
        if data_file_txt is not None:
            path_to_data = os.path.join(os.getcwd(), data_file_txt)
        else:
            path_to_data = None
        data_file_path = path_to_data
        if temp_file == '':
            data_file = data_file_path
        else:
            path_to_temp = os.path.join(path_to_temp, temp_file)
            data_file = path_to_temp

    # # Load mon v4 (old)
    mon_old, sim_old, f, data_file_clean, temp_flt_file_clean, _ = \
        load_data(data_file, skip, unit_key, zero_zero_in, time_end_in, legacy=legacy_in, v1_only=v1_only_in)
    mon_old = add_ib_lag(mon_old)
    mon_old = adjust_soc(mon_old, dDA_in)
    mon_old = add_voc_soc_new(mon_old)
    mon_old = scale_sres0(mon_old, sres0_in)
    mon_old_file_save = data_file_clean.replace(".csv", "_clean.csv")
    save_clean_file(mon_old, mon_old_file_save, 'mon' + date_)

    # How to initialize
    if mon_old.time[0] == 0.:  # no initialization flat detected at beginning of recording
        if init_time_in:
            init_time = init_time_in
        else:
            init_time = 1.
    else:
        if init_time_in:
            init_time = init_time_in
        else:
            init_time = -4.

    # New run
    mon_file_save = data_file_clean.replace(".csv", "_rep.csv")
    mon_ver, sim_ver, sim_s_ver, mon, sim = \
        replicate(mon_old, sim_old=sim_old, init_time=init_time, use_ib_mon=use_ib_mon_in, verbose=verbose_in,
                  use_vb_sim=use_vb_sim_in, use_mon_soc=use_mon_soc_in,
                  sres0=sres0_in, stauct_mon=stauct_mon_in, sresct=sresct_in)
    save_clean_file(mon_ver, mon_file_save, 'mon_rep' + date_)

    # Plots
    fig_list = []
    fig_files = []
    dir_root_test, data_root_test = os.path.split(data_file_clean)
    data_root_test = data_root_test.replace('.csv', '')
    filename = data_root_test
    plot_title = dir_root_test + '/' + data_root_test + '   ' + date_time
    if temp_flt_file_clean and len(f.time) > 1:
        fig_list, fig_files = over_fault(f, filename, fig_files=fig_files, plot_title=plot_title, subtitle='faults',
                                         fig_list=fig_list, long_term=long_term_in, cc_dif_tol=cc_dif_tol_in)
    if plot_overall_in:
        fig_list, fig_files = dom_plot(mon_old, mon_ver, sim_old, sim_ver, sim_s_ver, filename, fig_files,
                                       plot_title=plot_title, fig_list=fig_list, ref_str='',
                                       test_str='_ver')
        fig_list, fig_files = ekf_plot(mon_old, mon_ver, sim_old, sim_ver, sim_s_ver, filename, fig_files,
                                       plot_title=plot_title, fig_list=fig_list, ref_str='',
                                       test_str='_ver')
        fig_list, fig_files = sim_s_plot(mon_old, mon_ver, sim_old, sim_ver, sim_s_ver, filename, fig_files,
                                         plot_title=plot_title, fig_list=fig_list, ref_str='',
                                         test_str='_ver')
        fig_list, fig_files = gp_plot(mon_old, mon_ver, sim_old, sim_ver, sim_s_ver, filename, fig_files,
                                      plot_title=plot_title, fig_list=fig_list, ref_str='',
                                      test_str='_ver')
        fig_list, fig_files = off_on_plot(mon_old, mon_ver, sim_old, sim_ver, sim_s_ver, filename, fig_files,
                                          plot_title=plot_title, fig_list=fig_list, ref_str='',
                                          test_str='_ver')

    precleanup_fig_files(output_pdf_name=filename, path_to_pdfs=save_pdf_path)
    print('filename', filename, 'path', save_pdf_path)
    unite_pictures_into_pdf(outputPdfName=filename+'_'+date_time+'.pdf', save_pdf_path=save_pdf_path)
    cleanup_fig_files(fig_files)

    plt.show()
    return True


if __name__ == '__main__':
    seek_tensor()
