davegutz/myStateOfCharge/(commit log)

2021-08-09 I2C works
    I2C works
2021-08-11 fix DST
    [debugproto - Copy.xls]
2021-08-12 Add display
    [debugproto - Copy.xls]
2021-08-15 add prototype tables battery model, un-debugged but compiles
    [BattleBorn.xlsx]
2021-08-17 Track structure
    [BattleBorn.xlsx]
2021-08-20 fix digital instability, I hope
    [BattleBorn.xlsx, proto_2021-08-20T08-51 digital instability.xlsx]
2021-08-20 robust filter in presence of sample time delays
2021-08-23 tweak time handling
    [BattleBorn Calculator.xlsx, BattleBorn.xlsx]
2021-08-25 add derivative and solved battery structure
    [BattleBorn.xlsx]
2021-08-31 Tune soc handling beyond 1
    [BattleBorn.xlsx]
2021-09-01 data stored
    [20210831_142915.xlsx, beforeChargeDischarge.xlsx]
2021-09-06 tweak VOC-SOC
    [BattleBorn Rev.xlsx]
2021-09-07 Create BattleBorn Rev.ods
    [BattleBorn Rev.ods]
2021-09-08 cleanup model
    [BattleBorn Calculator.xlsx, BattleBorn Rev.ods, BattleBorn Rev.xlsx, BattleBorn Rev1.xls]
2021-09-22 update for new target device
2021-09-25 debug temp sensor read
2021-09-26 sliding deadband and cleanup names and sync time
    [CoolTerm Capture 2021-08-26 09-17-03 deadband temp.xlsx, CoolTerm Capture 2021-08-26 09-17-03.xlsx]
2021-09-26 status from laptop
    [CoolTerm Capture 2021-09-23 15-14-30 deadband values.ods, CoolTerm Capture 2021-09-23 17-37-34.ods]
2021-10-18 bias current
2021-10-27 more info in amp print
2021-10-28 debug amp
    [dataCal 20211028.ods]
2021-11-10 python battery
2021-11-18 battery model
2021-11-20 Battery class
2021-12-11 Tweak battery dynamic model for ekf to best match original data match from truck
2021-12-16 debug 'wifi on after reset'
    add initial values to CommandPars
    [Battery.cpp, StateSpace.cpp, command.h, main.h, myCloud.cpp, mySubs.cpp, mySync.cpp]
2021-12-16 connect ishunt_amp; delete sliding deadband
    gain is wrong somewhere
    [constants.h, main.h, myCloud.cpp, myCloud.h, mySubs.cpp, mySubs.h]
2021-12-18 Fix retained parameters being lost
    had included Battery.h in retained.h to use a global parameter
    [main.h]
2021-12-20 BatteryModel inherits Randles_
2021-12-20 move injection to BatteryModel
2021-12-21 fix charge time
2021-12-21 Created Coulombs class, to replace struct CoulombCounter
    [Battery.cpp, Battery.h, Coulombs.cpp, Coulombs.h, myCloud.cpp, mySubs.cpp, mySubs.h]
2021-12-25 print cleanup
2021-12-27 Temperature loss of charge capabiliyt
2022-01-02 voltage investigation
2022-01-04 bug in state space construction
    [Battery.cpp, Battery.py, StateSpace.py]
2022-01-07 debug old battery model
    n_cells * rct is incorrect for old batt model
2022-01-11 first hyst runs. broken
    not able to scale hys
    [Battery.py, Hysteresis.py]
2022-01-11 clean up pretty prints
2022-01-22 add voc_soc table method
    [20220118_111309.xlsx, BattleBorn Rev1.xls, BattleBorn.xlsx]
2022-01-24 adjust saturation logic to reset if voltage high OR soc high
    [Battery.cpp, Battery.h, main.h]
2022-01-31 tweak for low temp operation
    [20220129_063101.xlsx]
2022-02-01 status of adding bms_off and dc_dc_on
2022-02-03 15 C added
    [20220129_063101.xlsx, VOC_SOC data.xlsx]
2022-02-05 update more 15C data
    [VOC_SOC data.xlsx]
2022-02-07 Update VOC_SOC data.xlsx
    [VOC_SOC data.xlsx]
2022-02-09 battery heat initial
    [VOC_SOC data.xlsx]
2022-02-13 document battery heater
2022-02-13 Create Boil Your Battery Heat Model.jpg
2022-02-16 broke retained. Fixed it
    [Battery.cpp, constants.h, myTalk.cpp]
2022-02-18 tune tables
    [VOC_SOC data.xlsx]
2022-03-22 after field trials
    [VOC_SOC adj.ods, VOC_SOC adj.xlsx]
2022-03-23 Create SW 2022 Trip.xlsx
    [SW 2022 Trip.xlsx]
2022-03-27 draft BatteryMonitor class
2022-03-28 rearrange python model for BatteryMonitor
2022-04-07 fix temp initialization problem
    [Battery.cpp, Battery.h, Coulombs.cpp, Coulombs.h, main.h, mySubs.cpp]
2022-04-10 prevent first pass tweak update
    [main.h]
2022-04-10 fix hangup in reading a/d converters
    [main.h, mySubs.cpp]
2022-04-11 fix broken sat logic. tweak count_max
    [Battery.h, main.h]
2022-04-23 pretty print ADS
2022-04-28 debug ekf reset. Next logic to set Mon=EKF at right times
    [Battery.cpp, main.h, myTalk.cpp]
2022-05-04 progress battery type
2022-05-14 new float
    [newFloatCycleMod_overplots.xlsx, newFloatTweakMod_overplots.xlsx]
2022-05-28 fast print
2022-05-28 big fixes dv_ and sign of Randles in model
    [local_config.h.proto.h, local_config.h.soc0.h]
2022-06-04 cleanup amp_hrs
    [rapidTweakRegressionTest20220529.xlsx]
2022-06-05 add csv files
    [rapidTweakRegressionTest20220605_new.csv, rapidTweakRegressionTest20220605_newShort.csv]
2022-06-05 hys direx wrong in python
    [Battery.py, Hysteresis.py]
2022-06-06 fix up Randles plots
    appears to be time slip in Ib data
    [Battery.py, StateSpace.py]
2022-06-06 Matched!!!!!
    Putting time out with Sen data during tweak. coherent data was the problem
    [rapidTweakRegressionTest20220606_new1.csv, rapidTweakRegressionTest20220606_new1Short.csv]
2022-06-07 Add throughput test
    [rapidTweakRegressionTest20220605_new.csv, rapidTweakRegressionTest20220605_newShort.csv, rapidTweakRegressionTest20220606_new1.csv, rapidTweakRegressionTest20220606_new1Short.csv]
2022-06-11 fix -pole filter
2022-06-14 debug after looking at new data
    soc_m still has issues
    [DataOverModel.py, MonSim.py]
2022-06-18 Revert "Update main.h"
    This reverts commit 7791a6649b7ef5e80292562a3a27fefef02a2bef.
    [main.h]
2022-06-24 driving through BT
    [serial_20220624_095543_mon.csv, serial_20220624_095543_mon_rep.csv]
2022-06-25 rejigger voc, voc_stat, fix Hysteresis usage
    [Battery.cpp, Battery.h, Battery.py, DataOverModel.py, Hysteresis.py, MonSim.py, debug.cpp, main.h]
2022-07-16 debugging bluetooth baud rate problem
    [command.h, main.h, myCloud.cpp, mySubs.cpp, mySummary.cpp, myTalk.cpp]
2022-07-19 slow tweak tail for ekf fail studies
    [MonSim.py, constants.h, mySubs.h, myTalk.cpp]
2022-07-20 Blynk functionality
    won't work because 9600 baud is too slow for this application but Blynk itself won't support 115200
    [command.h, main.h, mySubs.cpp, mySummary.cpp, myTalk.cpp]
2022-07-23 status after edits to create Sensors.cpp/h
2022-07-25 fix t_last reset value
    was missing rp.t_last_model = ... in retained.h large_reset
    [Battery.cpp, Battery.h, Coulombs.cpp, Coulombs.h, command.h, constants.h, main.h, mySensors.cpp]
2022-08-03 fix initial time shift because counted too far in while loop
    [Battery.py, DataOverModel.py, MonSim.py]
2022-08-04 Noise added for model
    [constants.h, main.h, myFilters.cpp, myFilters.h, mySensors.cpp, mySensors.h, mySubs.cpp, myTalk.cpp]
2022-08-07 Try reset soc~=sat for reset
    [Battery.cpp, Battery.h, mySubs.cpp]
2022-08-09 begin work on Vb fail
    [Battery.cpp, DataOverModel.py, MonSim.py, mySensors.cpp, mySensors.h, mySubs.cpp]
2022-08-16 adding dscn filter and logic
2022-08-18 debug timer TFDelay
2022-08-21 add ewsat logic to prevent false positive where voc(soc) goes saturated (high slope)
    [DataOverModel.py, MonSim.py, constants.h, mySensors.cpp, mySensors.h, mySubs.cpp, myTalk.cpp]
2022-08-21 Fix Saturation wrap hi fault from soc jump
    [DataOverModel.py, mySensors.cpp]
2022-08-25 Tweak noamp calibration to match amp and reduce ibdiff errors and turn off tweak logic
    [MonSim.py, constants.h, local_config.h.proto.h, local_config.h.soc0.h]
2022-08-28 20220828a tweak current scalars SA/B
2022-08-28 Really cool fix for bad data in txt files from CoolTerm
    [DataOverModel.py]
2022-08-29 print edits
2022-08-29 SUMMARY PRINT ON Ble
2022-08-30 Debug regression tests. A few bug fixes
    [rapidTweakRegressionTest20220529.xlsx, realWorldXp20_20220825.ods]
2022-09-01 Create VOC_SOC adj_again.ods
    [VOC_SOC adj_again.ods]
2022-09-01 progress new build
    [VOC_SOC adj_again.ods]
2022-09-02 right sample rate for python triTweakDisch
2022-09-02 fix table lookup in hystereis python
    [Hysteresis.py, test_lut.py]
2022-09-02 test after hyst fix in python
    [MonSim.py]
2022-09-02 Fix bug in header print
    [main.h, mySubs.cpp, mySubs.h]
2022-09-03 Tweak all again
    [VOC_SOC adj_again.ods]
2022-09-05 LION with bucket
2022-09-06 cleanup and debug. sign error in calculate_capacity
    [Battery.cpp, Battery.h, Coulombs.cpp, Coulombs.py, MonSim.py, mySensors.cpp, mySensors.h, myTalk.cpp]
2022-09-06 fix XR logic end injection reset for XS
    [myTalk.cpp]
2022-09-06 debug bucket curve LIE
2022-09-10 fix chemistry stuck on boot configuration
    [VOC_SOC adj_again.ods]
2022-09-11 print tables from class
    prevents construction error ignorance
    [Battery.cpp, Coulombs.cpp, myTables.cpp, myTables.h]
2022-09-12 20220910 tunings
    [VOC_SOC adj_again_38C.ods]
2022-09-12 20220910a build
    better e_wrap and cc_diff disable at extremes. Bug in summ print for Vb
    [VOC_SOC adj_again_38C.ods]
2022-09-12 fix power on faults
    [Battery.cpp, Battery.h, MonSim.py, constants.h, mySensors.cpp, mySensors.h, mySubs.cpp, mySubs.h]
2022-09-13 20220910 40C data test
    -30C and 40C curves probably 0.1 V too high because used voc_stat instead of hand calc from Vb and Hdump. Too bad Vb error in Hdump can't recover
    - scale_hys by 0.3 to get chg and recharge voc_stat curves to align. Should always do disch followed by charge to get curves
    - use e_wrap to verify R_ss
    [Battery.py, DataOverModel.py, MonSim.py]
2022-09-13 tweak tables again
    [VOC_SOC adj_again_38C.ods]
2022-09-14 Debug triTweak
    needed tweak_test() in logicfor bms_off
2022-09-17 dvoc-.05 --> 0. Mods to fault logic for low soc e_wrap 220917 deploy
    [VOC_SOC adj_again_38C_30C.ods]
2022-09-19 ekf print
2022-09-19 debug EKF update time problem
    update time problem
    [Battery.cpp, Coulombs.cpp, myTalk.cpp]
2022-09-20 bms_off tweaks
2022-09-21 20220917b
    had run with wrong local_config. Also doubled WRAP_SOC_LO_SCLR
    [CompareRun.py, constants.h]
2022-09-21 cleanup plots
    confirms fix of 2022017b. double the e_wrap_lo thr to 60.
    [CompareRun.py, DataOverModel.py, mySensors.cpp]
2022-09-22 20220917c deploy
    [VOC_SOC adj_again_38C_30C_backwards.ods]
2022-09-23 Update mySensors.cpp
    wrap_lo fail near saturation with soc < actual soc so Vb higher than expected. Add FAKE_FAULT to prevent selection from being changed to model then should snap to SAT. Still need a fix for soc shift causing false fault
    [mySensors.cpp]
2022-09-24 Throughput test
    read load 530 us
    read calc 370 us
    read print v0 1 us
    v1 2000 us
    v2 3880 us
    v3 2070 us
    load t 40 us
    pub 50 us
    [throughput 20220917d.ods]
2022-09-25 Corrections
    now need hyst scaling
    [CompareHist.py]
2022-09-26 add hys redesign model
    [CompareHist.py, Hysteresis_20220926.py]
2022-09-27 redesign hist at 20C
    [CompareHist_20220917d.py, Hysteresis_20220926.py]
2022-09-29 update curves after capacitance ctudy
2022-09-29 debug
    some kind of small sync error around saturation in e_wrap
    [DataOverModel.py]
2022-10-02 fix ubc in python mon.calculate for dv_hys init
    [Battery.cpp, Battery.py, CompareRun.py, DataOverModel.py, Hysteresis_20220926.py, MonSim.py]
2022-10-02 debugging bms_off
    [offSitHysBms20220926.csv, offSitHysBms20220926.ods]
2022-10-04 debugging
    python ver models broken. See CompareRun: rapidTweakRegression v20220926
    [offSitHysBms20220926.csv, offSitHysBms20220926.ods]
2022-10-29 multi-frame EKF in Photon
2022-10-29 undo rp.i_select change from befoe
    was battery problem
2022-11-02 fix sign error AinvB in StateSpace
    [Battery.cpp, Battery.h, Coulombs.cpp, StateSpace.cpp, constants.h, mySubs.cpp, myTalk.cpp]
2022-11-10 debug bms_off
2022-11-13 fixed dv_dyn_ver
    input to Randles was [vb ib] instead of [self.vb self.ib]
    [Battery.py, CompareRun.py]
2022-11-22 debug on-off-on
    set Mon only internal voltages = vb on shutoff
2022-12-20 draft dscn, lower case python
2022-12-26 Add Vo_Vc filter
2022-12-27 new soc1a board
2023-01-05 Swap soc and pro argons - just rename them
    [local_config.h.pro1a.h, local_config.h.soc1a.h]
2023-01-08 1k for divider
    compromise between power loss and performance. 4k7 is bare limit of performance. 470 uses 5 mA. 1000 uses 2 mA.
2023-01-09 4th ib sense wire (separate commons). Also save time_now
2023-01-09 cal soc1a current
2023-01-15 Update State of Charge Monitor 20230112.odt
2023-01-22 install soc0p and cal
    - sign in shunt gain disappeared wih wiring change
2023-01-27 Spare battery defn
2023-01-29 tune tables
    soc_ekf wandering fixed. tables were 0.15 v too high
    [Battery.cpp, Battery.h, Battery.py, CompareRunSim.py, DataOverModel.py, local_config.h.soc0p.h]
2023-01-29 NP=2 for photon devices running bedroom system CHINS
2023-02-07 tune schd + hys for high soc disch/charge
2023-02-16 debug new Charge Transfer dynamics
2023-02-17 debug the ChargeTransfer
2023-02-19 cleaning up Battery constants
2023-02-20 fix Bs, Bm talk logic
    [CompareRunSim.py, Coulombs.h, myTalk.cpp]
2023-02-20 prevent compiling app with wrong headers
    [local_config.h.pro0p.h, local_config.h.pro1a.h, local_config.h.soc0p.h, local_config.h.soc1a.h]
2023-03-04 cleanup data
    [CoolTerm Capture 2021-01-20 13-00-00_floor.xlsx, CoolTerm Capture 2021-08-18 08-21-27.xlsx, CoolTerm Capture 2021-08-18 14-12-34.xlsx, CoolTerm Capture 2021-08-18 16-31-59.xlsx, CoolTerm Capture 2021-08-20 03-33-571 digital instability.xlsx, CoolTerm Capture 2021-08-26 04-54-37.xlsx, CoolTerm Capture 2021-08-26 09-17-03 deadband temp.xlsx, CoolTerm Capture 2021-09-23 15-14-30 deadband values.ods]
2023-03-05 restore capacity of Battleborn in soc1a
2023-03-08 debug vb_off, delete bms_ (its inherited by chem_)
2023-03-08 Update State of Charge Monitor 20230227.odt
2023-03-21 dt bug
    root cause: could not test real hardware in test suite
    [constants.h, mySensors.h]
2023-03-26 add calibration filter
2023-04-01 Arduino plots added
2023-04-03 prototype v20230403
2023-04-03 change name of folder
    [20210831_142915.xlsx, BattleBorn Calculator.xlsx, BattleBorn Rev1.xls, BattleBorn.xlsx, EKF_Track Dr2000 v20220917_mon.csv, EKF_Track v20221028_ekf.csv, EKF_Track v20221028_flt.csv, EKF_Track v20221028_mon.csv]
2023-04-05 inf counter
    [history soc0p v20230305 .csv, puttyLog20230404_042903_rep.csv, rapidTweakRegression vA20230403 BB_ekf.csv, rapidTweakRegression vA20230403 BB_flt.csv, rapidTweakRegression vA20230403 BB_mon.csv, rapidTweakRegression vA20230403 BB_mon_rep.csv, rapidTweakRegression vA20230403 BB_sel.csv, rapidTweakRegression vA20230403 BB_sim.csv]
2023-05-15 organize data
    [20210831_142915.xlsx, SW 2022 Trip.xlsx, VOC_SOC adj.ods, VOC_SOC adj.xlsx, VOC_SOC adj_again.ods, VOC_SOC adj_again_38C.ods, VOC_SOC adj_again_38C_30C.ods, VOC_SOC adj_again_38C_30C_backwards.ods]
2023-05-24 rename party
    [history soc0p_P_.csv]
2023-05-28 debug pulse
    [pulseSS_A_CH.csv]
2023-05-28 clean file
    [pulseSS_A_CH.csv]
2023-05-30 full suite done
    [ampHiFailSlow_A_CH.csv, pulseEKF_A_CH.csv, tbFailHdwe_A_CH.csv, tbFailMod_A_CH.csv, vHiFailFf_A_CH.csv, vHiFail_A_CH.csv]
2023-05-31 new version
    [ampHiFailFf_A_CH.csv, ampHiFailFf_A_CH_rep.csv, ampHiFailNoise_A_CH.csv, ampHiFailNoise_A_CH_rep.csv, ampHiFail_A_CH.csv, ampHiFail_A_CH_rep.csv, ampLoFail_A_CH.csv, ampLoFail_A_CH_rep.csv]
2023-05-31 full test g20230530
    [ampHiFailSlow_A_CH.csv, ampHiFailSlow_A_CH_rep.csv, pulseSS_A_CH.csv, pulseSS_A_CH_rep.csv, tbFailHdwe_A_CH.csv, tbFailHdwe_A_CH_rep.csv, tbFailMod_A_CH.csv, tbFailMod_A_CH_rep.csv]
2023-06-04 checkout new
    [ampHiFailFf_A_BB.csv, ampHiFailFf_P_CH.csv, ampHiFailNoise_A_BB.csv, ampHiFailNoise_P_CH.csv, ampHiFailSlow_A_BB.csv, ampHiFail_A_BB.csv, ampHiFail_P_CH.csv, ampLoFail_A_BB.csv]
2023-06-05 fix path for linux
    [constants.h, local_config.h]
2023-06-11 save as
    [ampHiFail_A_CH_test1.csv_A_CH.csv]
2023-06-12 debug path
    [ampHiFail_A_CH.csv, ampHiFail_A_CH_rep.csv]
2023-06-12 debug linux
    [ampHiFail_A_CH.csv, ampHiFail_A_CH_rep.csv]
2023-06-13 new linux
    [ampHiFail_P_CH.csv, ampHiFail_P_CH_rep.csv]
2023-06-16 rejigger keys and file names
    [ampHiFailFf_A_BB.csv, ampHiFailFf_P_CH.csv, ampHiFailFf_pro0p_ch.csv, ampHiFailFf_pro1a_bb.csv, ampHiFailNoise_A_BB.csv, ampHiFailNoise_P_CH.csv, ampHiFailNoise_pro0p_ch.csv, ampHiFailNoise_pro1a_bb.csv]
2023-06-17 linux debug
    [offSitHysBmsBB_pro1a_bb.csv, offSitHysBmsCH_pro0p_ch.csv, offSitHysBmsCH_pro0p_ch_rep.csv, offSitHysBmsNoiseCH_pro0p_ch.csv]
2023-06-17 debug ch
    [ampHiFailFf_pro0p_ch.csv, ampHiFailFf_pro0p_ch_rep.csv, ampHiFailNoise_pro0p_ch.csv, ampHiFailNoise_pro0p_ch_rep.csv, ampLoFail_pro0p_ch.csv, ampLoFail_pro0p_ch_rep.csv, coldStart_pro0p_ch.csv, coldStart_pro0p_ch_rep.csv]
2023-06-17 debug tests
    [rapidTweakRegression40C_pro0p_ch.csv, rapidTweakRegression40C_pro0p_ch_rep.csv, satSitCH_pro0p_ch.csv, slowTweakRegression_pro0p_ch.csv, slowTweakRegression_pro0p_ch_rep.csv]
2023-06-18 font sizes
    [ampHiFailSlow_pro0p_ch.csv, ampHiFailSlow_pro0p_ch_rep.csv, offSitHysBmsNoiseCH_pro0p_ch.csv, offSitHysBmsNoiseCH_pro0p_ch_rep.csv, vHiFail_pro0p_ch.csv, vHiFail_pro0p_ch_rep.csv]
2023-06-19 clear and ask overwrite
    [vHiFailFf_pro0p_ch.csv, vHiFailFf_pro0p_ch_rep.csv]
2023-07-01 p2 runs first time - has issues
    [SOC_Particle.ino, SerialRAM.cpp, constants.h, fault.cpp, fault.h, local_config.h, local_config.h.pro0p.h, local_config.h.pro1a.h]
2023-07-14 tune soc1a on trip
    [Hd_20230713_soc1a_bb.csv, Hd_20230714_soc1a_bb.csv, VOC_SOC adj_again_38C_30C_backwards.ods, dump_soc1a_bb.csv, hist20221028.csv, hist_20230709_soc1a_bb.csv, hist_20230711_soc1a_bb.csv, hist_20230712_soc1a_bb.csv]
2023-07-25 p2 needs DP4 until serial fixed. also detect BARE
    [mySensors.cpp, myTalk.cpp]
2023-07-25 trip changes
    [hist20221028.csv, hist_Dc06_20230715_soc1a_bb.csv, static_look_at_sat_20230716_soc1a_bb.csv, testv2_soc1a_bb.csv, testv2_soc1a_bb_rep.csv, unplug_at_sat_20230716_soc1a_bb.csv, unplug_at_sat_20230716_soc1a_bb_rep.csv]
2023-07-26 Tweak schedules BB +0.3
    somehow shifted scheds down by hysteresis
    [Hd_Dc06_20230725_soc1a_bb.csv, hist20221028.csv]
2023-08-07 import long term hyst data
    [dv_long_soc0p_ch.csv]
2023-08-14 new test
    [putty_test 20230814.csv]
2023-08-14 new data
    [putty_test 20230814.csv]
2023-08-14 another test run
    [dv_test_soc0p_ch_rep.csv, dv_validate_soc0p_ch_rep.csv]
2023-08-15 padded training data
    [dummy.csv, dummy.ods, dv_train_soc0p_ch.csv]
2023-08-18 debug sat
    [dv_test_soc0p_ch_clean.csv, dv_test_soc0p_ch_rep.csv, dv_validate_soc0p_ch_clean.csv, dv_validate_soc0p_ch_rep.csv]
2023-08-20 add ib_lag
    [dv_test_soc0p_ch_clean.csv, dv_test_soc0p_ch_rep.csv, dv_validate_soc0p_ch_clean.csv, dv_validate_soc0p_ch_rep.csv]
2023-08-21 fail case
2023-08-21 hidden 4, 180 s lag
    [dv_test_soc0p_ch_clean.csv, dv_test_soc0p_ch_rep.csv, dv_validate_soc0p_ch_clip_clean.csv, dv_validate_soc0p_ch_clip_rep.csv]
2023-08-27 split data
    [dv_train_soc0p_ch_clip01.csv, dv_train_soc0p_ch_clip01_clean.csv, dv_train_soc0p_ch_clip01_rep.csv, dv_train_soc0p_ch_clip02.csv, dv_train_soc0p_ch_clip02_clean.csv, dv_train_soc0p_ch_clip02_rep.csv, dv_train_soc0p_ch_clip03.csv, dv_train_soc0p_ch_clip03_clean.csv]
2023-08-29 clear the decks
    [GenerateDV_Data_rep.csv, dummy.csv, dummy.ods, dv_test_soc0p_ch.csv, dv_test_soc0p_ch_clean.csv, dv_test_soc0p_ch_rep.csv, dv_train_soc0p_ch.csv, dv_train_soc0p_ch_clip01.csv]
2023-10-12 fix Dw effects
    [dw_pro1a_bb.csv, dw_pro1a_bb_rep.csv, putty_2023-10-10T06-27-55.csv, rapidTweakRegression_pro0p_ch.csv]
2023-10-13 close plots in TestSOC
    [ampHiFailSlow_pro1a_bb.csv, ampHiFailSlow_pro1a_bb_rep.csv, ampHiFail_pro1a_bb_rep.csv, ampLoFail_pro1a_bb.csv, ampLoFail_pro1a_bb_rep.csv, dy_pro1a_bb.csv_pro1a_bb.csv, dy_pro1a_bb_rep.csv, dy_pro1a_bb_rep.csv_pro1a_bb_rep.csv]
2023-10-13 investigate fault responses
    [ampHiFailSlow_pro1a_bb_rep.csv, ampHiFail_pro1a_bb.csv, fault responses.ods, vHiFail_pro1a_bb.csv, vHiFail_pro1a_bb_rep.csv]
2023-10-13 dw and dy runs
    [ampHiFailSlow_pro1a_bb.csv, ampHiFail_pro1a_bb.csv, dw_pro1a_bb.csv]
2023-10-13 Dy inv
    [dy0p8_pro1a_bb.csv, dy0p8_pro1a_bb_rep.csv, fault responses.ods]
2023-11-08 fixup GUI_TestSOC
    [fault responses.ods, vHiFail_pro0p_ch_rep.csv]
2023-11-08 g20230530a version
    [fault responses.ods]
2023-11-09 testing to vet hys removal
    [fault responses.ods]
2023-11-11 debug vHiFail
    longer T_SAT = 22. Decouple ewrap timers from T_SAT
    [fault responses.ods]
2023-11-12 plot killer
    [fault responses.ods]
2023-11-15 draft timer
2023-11-17 Fix skew e_wrap on model
    [Battery.cpp, Battery.h]
2023-11-18 debug. finish 20231111 testing. don't release yet
    [fault responses.ods]
2023-11-23 debugging photon2. Got SRAM working using retained
    [ds18b20.fzz]
2023-11-30 Time UT and fix memory retention Argon
    [local_config.h, myTalk.cpp, parameters.cpp, parameters.h]
2023-12-01 play with DS2482
    [putty_test DS2482 fail - multi.csv, putty_test DS2482 success.csv]
2023-12-02 road to recovery
    this build shows DS2482 causes red light panic during XS;Xp0;
    [putty_test DS2482 success.csv, putty_testred.csv]
2023-12-02 BP BS fix to get flat lines in plots
    [mySensors.cpp, mySubs.cpp]
2023-12-03 Remove single drop DS2482 - didn't work
    [GUI_TestSOC.py, SOC_Particle.ino, constants.h, local_config.h.pro3p2.h]
2023-12-05 Perhaps working Photon2 ??
    [putty_test DS2482 fail talkframe.csv]
2023-12-06 Fix red light SoS 4 blink Bus Fail (COMMAND_LIST_STACK_SIZE)
    [GUI_TestSOC.py, SOC_Particle.ino, parameters.cpp]
2023-12-06 fix startup
    [puttyLog20231118_121523.csv, putty_2023-10-10T06-27-55.csv, putty_2023-10-13T12-59-13.csv, putty_test Argon success.csv, putty_test DS2482 fail - multi.csv, putty_test DS2482 fail talkframe.csv, putty_test DS2482 success.csv, putty_testred.csv]
2023-12-07 investigate CompareFault troubles
    [ampHiFail_pro3p2_bb.csv, hist20221028.csv]
2023-12-08 status (missing * on some floatZ
    [SOC_Particle.ino, Z.h, command.h, mySensors.cpp, mySensors.h, myTalk.cpp]
2023-12-08 debug * prints
2023-12-09 Using Class Template Lists prototype
2023-12-14 fixed table delete bug
    [Chemistry_BMS.cpp, GUI_TestSOC.py, myTables.cpp, recall_X.cpp]
2023-12-16 print proto scaling history logs
2023-12-16 Create Adjustments Plus.ods
    [Adjustments Plus.ods]
2023-12-18 fix up paths in worker file
    [CompareHistSim.py, GUI_TestSOC.py]
2023-12-20 Time now bug (was float instead of unsigned long
    [SOC_Particle.ino, parameters.h]
2023-12-20 fix lack of mySum printing (nsum=0)
    [SOC_Particle.ino, fault.cpp, fault.h, mySummary.cpp, mySummary.h, parameters.cpp, parameters.h]
2023-12-21 proper case in parameter.h names
2023-12-23 install g20231111b to soc0p
    [deploy_g2023111b_soc0p_ch.csv, status20231223_soc0p_ch.csv]
2023-12-30 fix bug resize nhis_ after instantiation of buffers
    [Adjust.h, Battery.cpp, SOC_Particle.ino, Sensors.cpp, Variable.h, followup.cpp, help.cpp]
2024-01-08 debug new build process
    [SOC_Calibrate.ods]
2024-01-12 install soc0p g20240109
    [SOC_Calibrate.ods]
2024-01-13 load soc0p
    [g20240109_static_soc0p_ch.csv, soc0p_pre_g20240109_soc0p_ch.csv]
2024-01-14 progress cal
    [SOC_Calibrate.ods]
2024-01-15 finish soc0p cal
    [SOC_Calibrate.ods, curve_20240115_soc0p_ch.csv]
2024-01-26 micros
    0.0012 = T are there any bus calls to comment out still?
    [putty_2024-01-25T16-22-34.csv, putty_2024-01-25T16-39-02.csv]
2024-02-11 fix fault word import type
    [CompareFault.py, load_data.py]
2024-02-20 pynput not pyautogui
    [putty_def.csv]
2024-03-07 ltspice on linux
    [putty_def.csv]
2024-03-21 tune tsc2010 circuit
2024-04-01 debug charge time for nS
2024-04-17 OLED schematic
2024-04-18 update schematics
2024-04-28 re-sucsitate soc3p2 after pro3p2 failure
    [constants.h, local_config.h, local_config.h.soc3p2.h]
2024-04-30 workaround Photon 2 serial limitations -->Dr400
    [GUI_TestSOC.py, serial.cpp]
2024-05-06 fix some of executable path issues
    [Calibrate_exe.py, CompareFault.py, CompareHistSim.py, DataOverModel.py, DriveHys.py, Hysteresis.py, Hysteresis_20220917d.py, Hysteresis_20220926.py]
2024-05-09 Fix flatSitHys leftover bias Xb0
    [GUI_TestSOC.py]
2024-05-17 Create Taidacent Replace 7805 DC-DC Buck.pdf
2024-05-17 Fix config management error soc3p2
    forgot to change R1 and R2 when rescucitated soc3p2 after pro3p2 failed. Curves ok
    [local_config.h.soc3p2.h]
2024-06-10 Create ECO-WORTHY 120 Watts 12V Monocrystalline Solar Panel for Off-Grid.pdf
2024-06-10 Create Renogy Solar Panel 200 Watt 12 Volt, High-Efficiency Monocrystalline PV Module Power 200W.pdf
2024-06-13 organize files
    [bothFansHi.csv, bothFansHiOsc.csv, inverterOff.csv, inverterOffZoomTime.csv, oneFanHi.csv, oneFanLow.csv, oneFanMed.csv, oneFanOff.csv]
2024-06-13 inverter data rigol
    [bothFansHi.csv, bothFansHiOsc.csv, inverterOff.csv, inverterOffZoomTime.csv, oneFanHi.csv, oneFanLow.csv, oneFanMed.csv, oneFanOff.csv]
2024-06-14 rigol data guest room
    [inverterOff.csv, inverterOffZoomTime.csv, noFans.csv, oneFanHi.csv, oneFanMed.csv, oneFanOff.csv]
2024-06-14 data with v3/2
    [bothFansHi.csv, bothFansHiOsc.csv, inverterOff.csv, light.csv, oneFanHi.csv, oneFanLow.csv, oneFanOff.csv]
2024-06-23 document noise filtering
2024-06-24 soc4p2 doesn't read serial reliably. ASK_DURING_BOOT 0
    [SOC_Particle.ino, Sensors.cpp, constants.h, pro2p2.h, serial.cpp, soc4p2.h]
2024-06-24 cleanup printouts
2024-06-28 Update Build an Ib Filter Module.odt
2024-07-14 adding battery calculation to verify e_wrap
2024-07-14 redesign e_wrap trimmer for amp
    simplify. set to 0 for reset or out of range
    [Battery.py, DataOverModel.py, myFilters.py]
2024-07-21 cleanup old active-standby faults
    [FaultGrid_activeStandby.ods]
2024-07-21 implementing HI_LO progress
    [FaultGrid_activeStandby.ods]
2024-07-21 finish prototype HI_LO fault detection
    [FaultGrid_activeStandby.ods]
2024-07-22 cleanup hi_lo
    [FaultGrid_activeStandby.ods]
2024-07-22 debug new hi_lo selection
    [FaultGrid_activeStandby.ods]
2024-07-22 testing new logic
    si-1 does not reset from thhis back to good spot - see BT blink words
    [FaultGrid_activeStandby.ods]
2024-08-05 debug ib_choice with fake_f
    [DecisionTables.ods]
2024-08-12 debug RED_LOSS. Set ib_sel_stat for hi-lo
    [DecisionTables.ods]
2024-08-15 Swap test ref
    battery display is not updated but swap works in all other regards
    [GUI_TestSOC.py]
2024-08-25 update decision tables for ib_lo_active
    [DecisionTables.ods]
2024-08-26 major bug for model running fixed
    [DecisionTables.ods]
2024-08-27 FIX pulseSS ib_DIFF_flt
    with hi-lo construction a huge ib-diff develops DUE TO due to limits
    [GUI_TestSOC.py]
2024-08-27 revise default hi-lo ib_dec so whenevER it is default, IB DEC = 0
    [DecisionTables.ods]
2024-08-27 BUG THAT CAUSED IB_diff to always be active
    [DecisionTables.ods]
2024-08-29 make bms_off work
2024-08-30 update plots and fix vHiFailFf
    [DataOverModel.py, GUI_TestSOC.py]
2024-08-30 finish transients...still some errors to fix: tbFail*
    [DecisionTables.ods]
2024-09-09 debug noise sensitivity g20240909
    [GUI_TestSOC.py, Sensors.cpp, Sensors.h, constants.h, myFilters.cpp, myFilters.h, version.h]
2024-09-09 Update Sensors.cpp
    not needed
2024-09-10 add vHi noise test
    [GUI_TestSOC.py]
2024-10-06 amp wrap windup fix prototype
    [Battery.cpp, CompareHistSim.py, GUI_TestSOC.py, Sensors.cpp, Sensors.h, local_config.h, version.h]
2024-11-03 add SH Tb algorithm
    [2-wireRTD.ods]
2024-12-04 no sat with Tb=10 fix
    [Chemistry_BMS.cpp]
2024-12-04 print SAT for vv5
