davegutz/myStateOfCharge/SOC_Particle/datasheets/Schematics/ASD_OPA Design 20220102.jpg

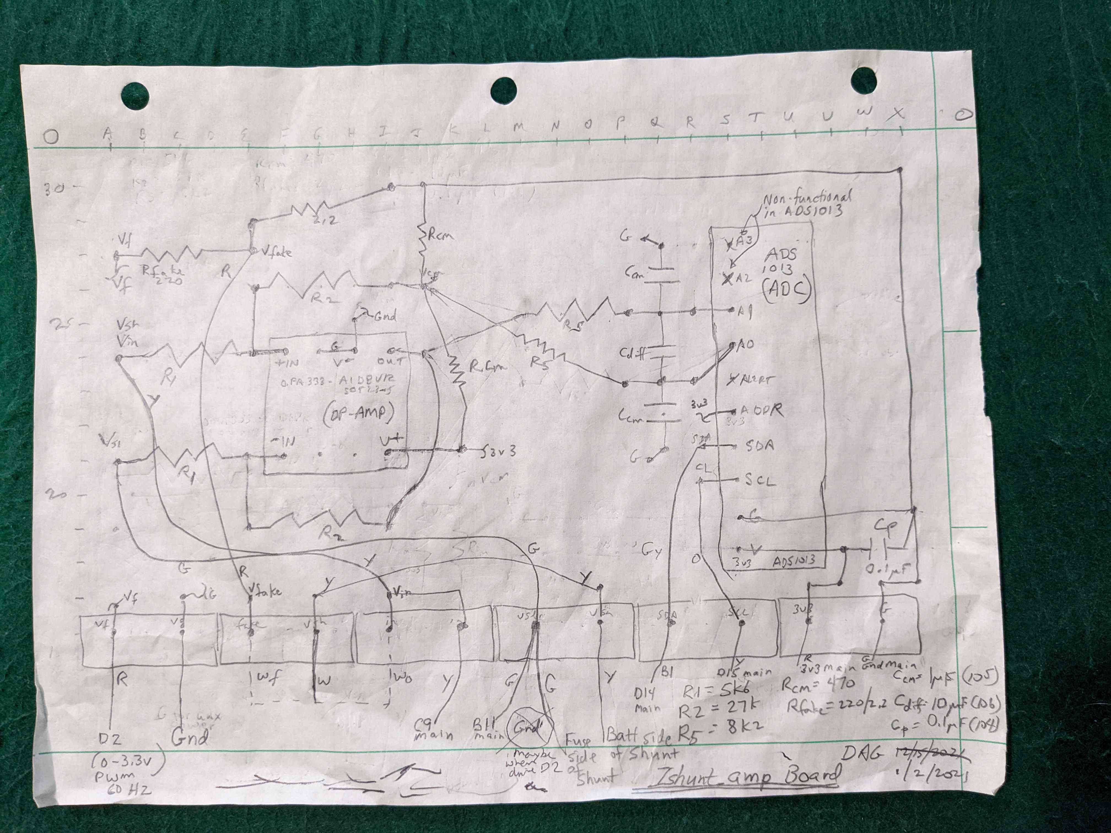
SOC_Particle/datasheets/Schematics/ASD_OPA Design 20220102.jpg
